TCI-LUH/Gateway-Module-v3/3d-case/backplate.step

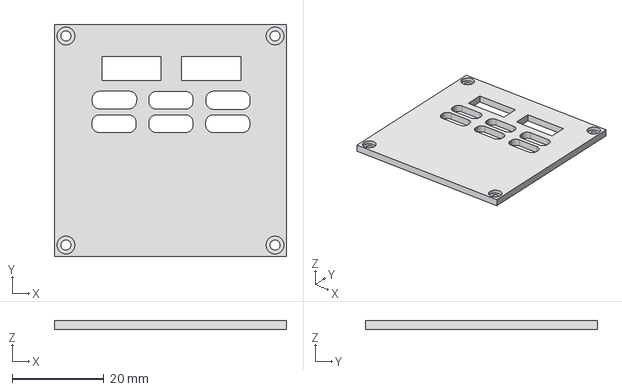
[picture p1: CAD file, 2025-05-20]
3d-case/backplate.step
50.6 x 50.6 x 2.00 mm
