TCI-LUH/Gateway-Module-v3/3d/fan_25x25x6.step

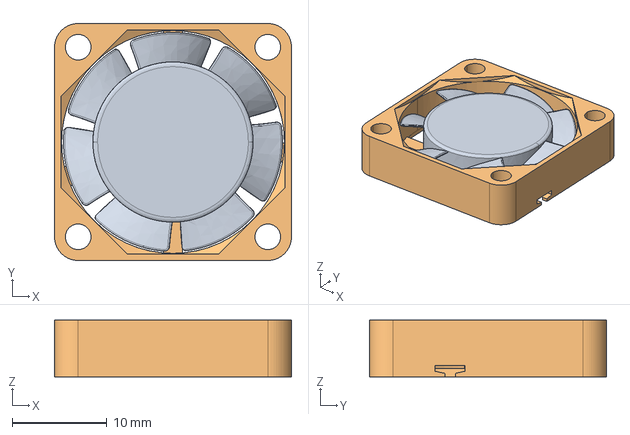
[picture p2: CAD file, 2025-05-20]
3d/fan_25x25x6.step
25.0 x 25.0 x 6.00 mm
