TCI-LUH/Gateway-Module-v3/pcbs/testing/tty2eth-slim/tty2eth-slim.step

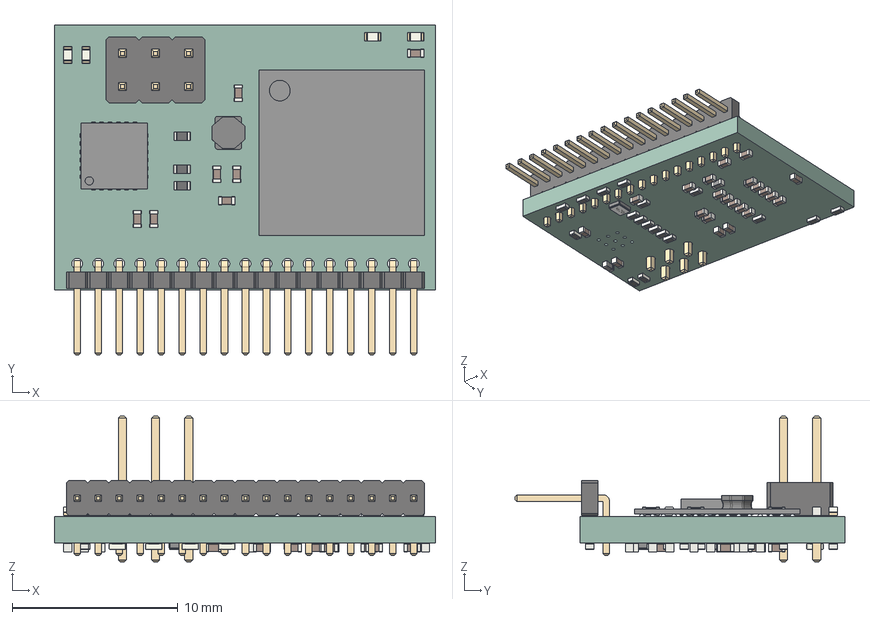
[picture p3: CAD file, 2025-05-20]
pcbs/testing/tty2eth-slim/tty2eth-slim.step
23.0 x 19.9 x 8.80 mm
C_0402_1005Metric x 29
R_0402_1005Metric x 21
LED_0402_1005Metric x 4
L_DND2020MK004
ASSEMBLY x 2
PinHeader_2x03_P200mm_Vertical
PinHeader_1x17_P127mm_Horizontal
ASCO
L_0402_1005Metric x 2
tty2eth-slim_PCB
