TCI-LUH/Gateway-Module-v3/3d-case/case-base.step

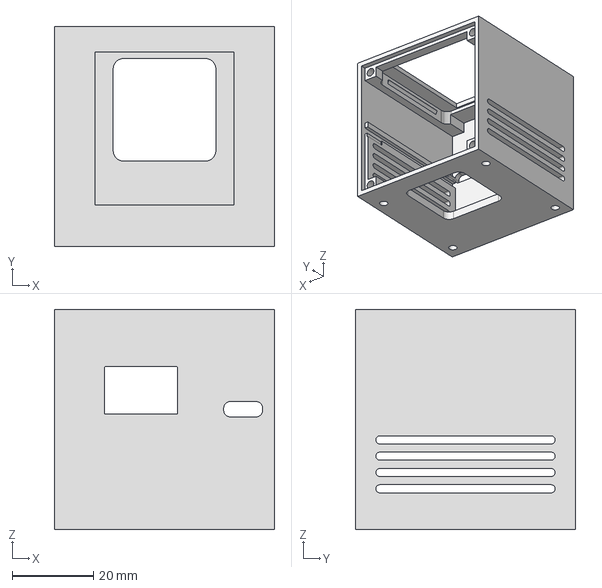
[picture p4: CAD file, 2025-05-20]
3d-case/case-base.step
54.0 x 54.0 x 54.0 mm
