TCI-LUH/Gateway-Module-v3/3d/XK049b-Heatspreader.step

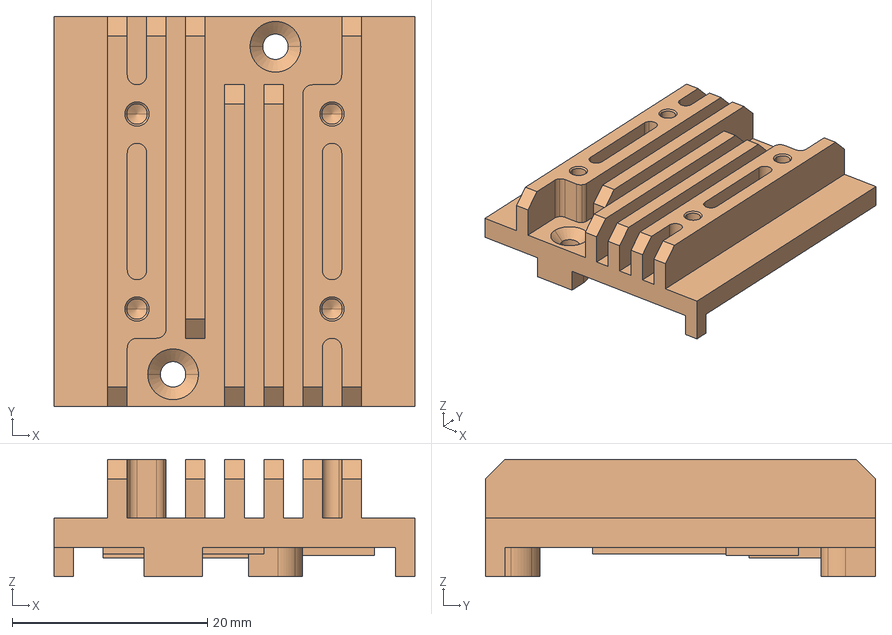
[picture p5: CAD file, 2025-05-20]
3d/XK049b-Heatspreader.step
37.0 x 40.0 x 12.0 mm
