TCI-LUH/Gateway-Module-v3/3d-case/foot.step

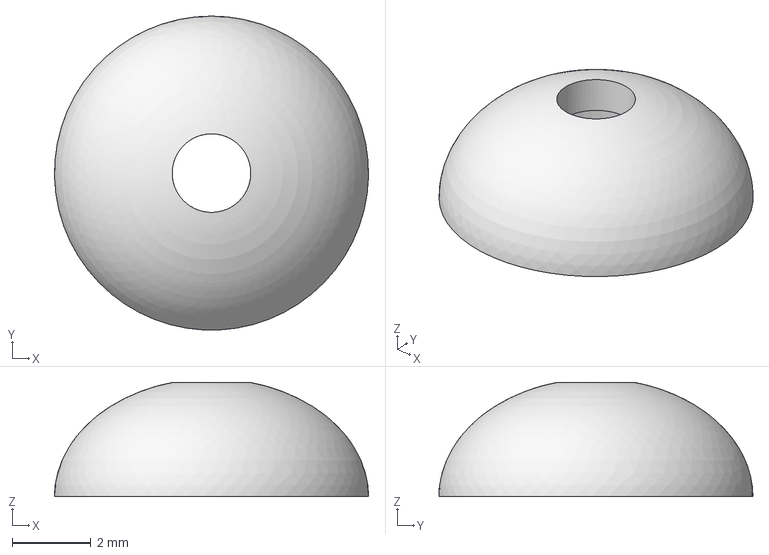
[picture p6: CAD file, 2025-05-20]
3d-case/foot.step
8.00 x 7.99 x 2.90 mm
