TCI-LUH/Gateway-Module-v3/3d-case/fan-grill.step

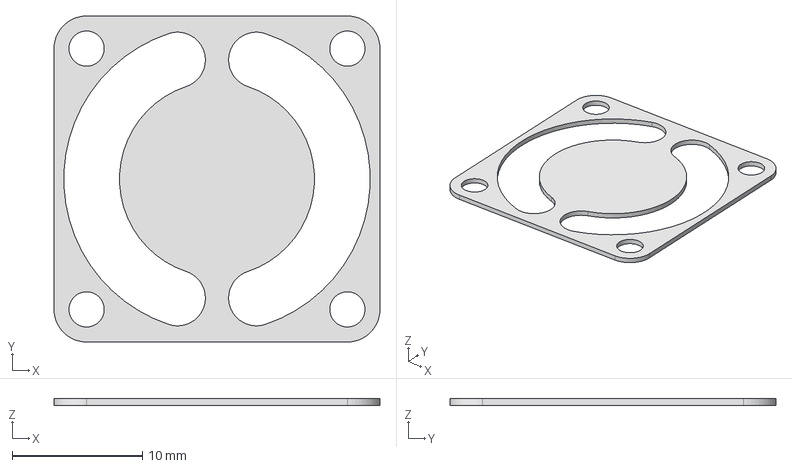
[picture p7: CAD file, 2025-05-20]
3d-case/fan-grill.step
25.0 x 25.0 x 0.5 mm
