TCI-LUH/Gateway-Module-v3/pcbs/schematics/gwm-main-board.pdf

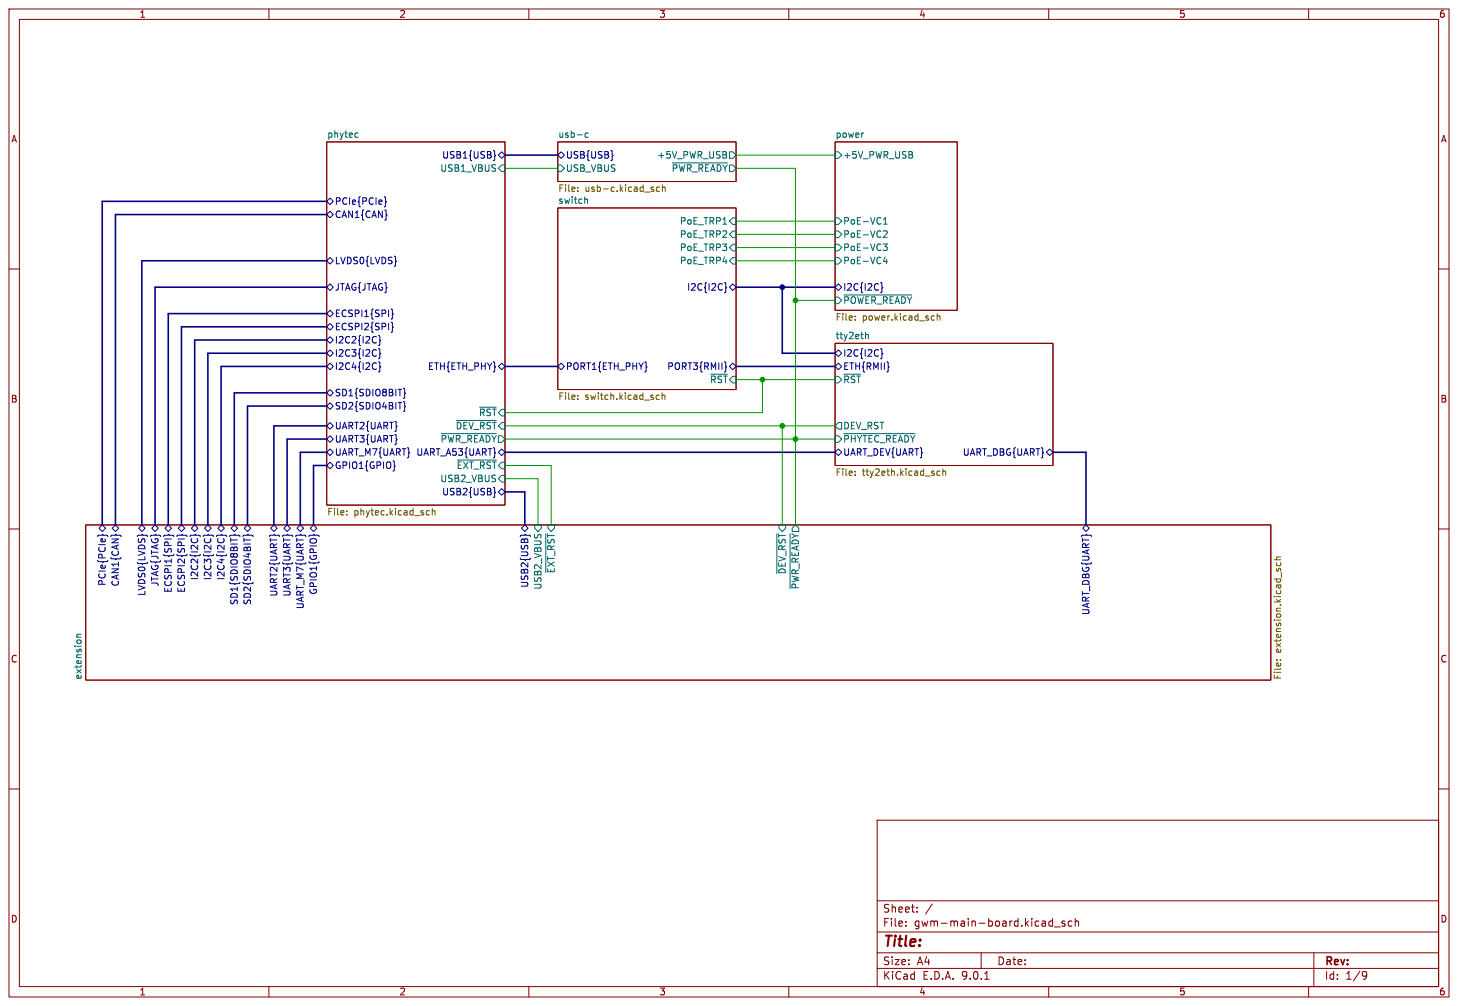
[picture p8: page 1]

Id: 1/9 Title: File: gwm-main-board.kicad_sch Sheet: /

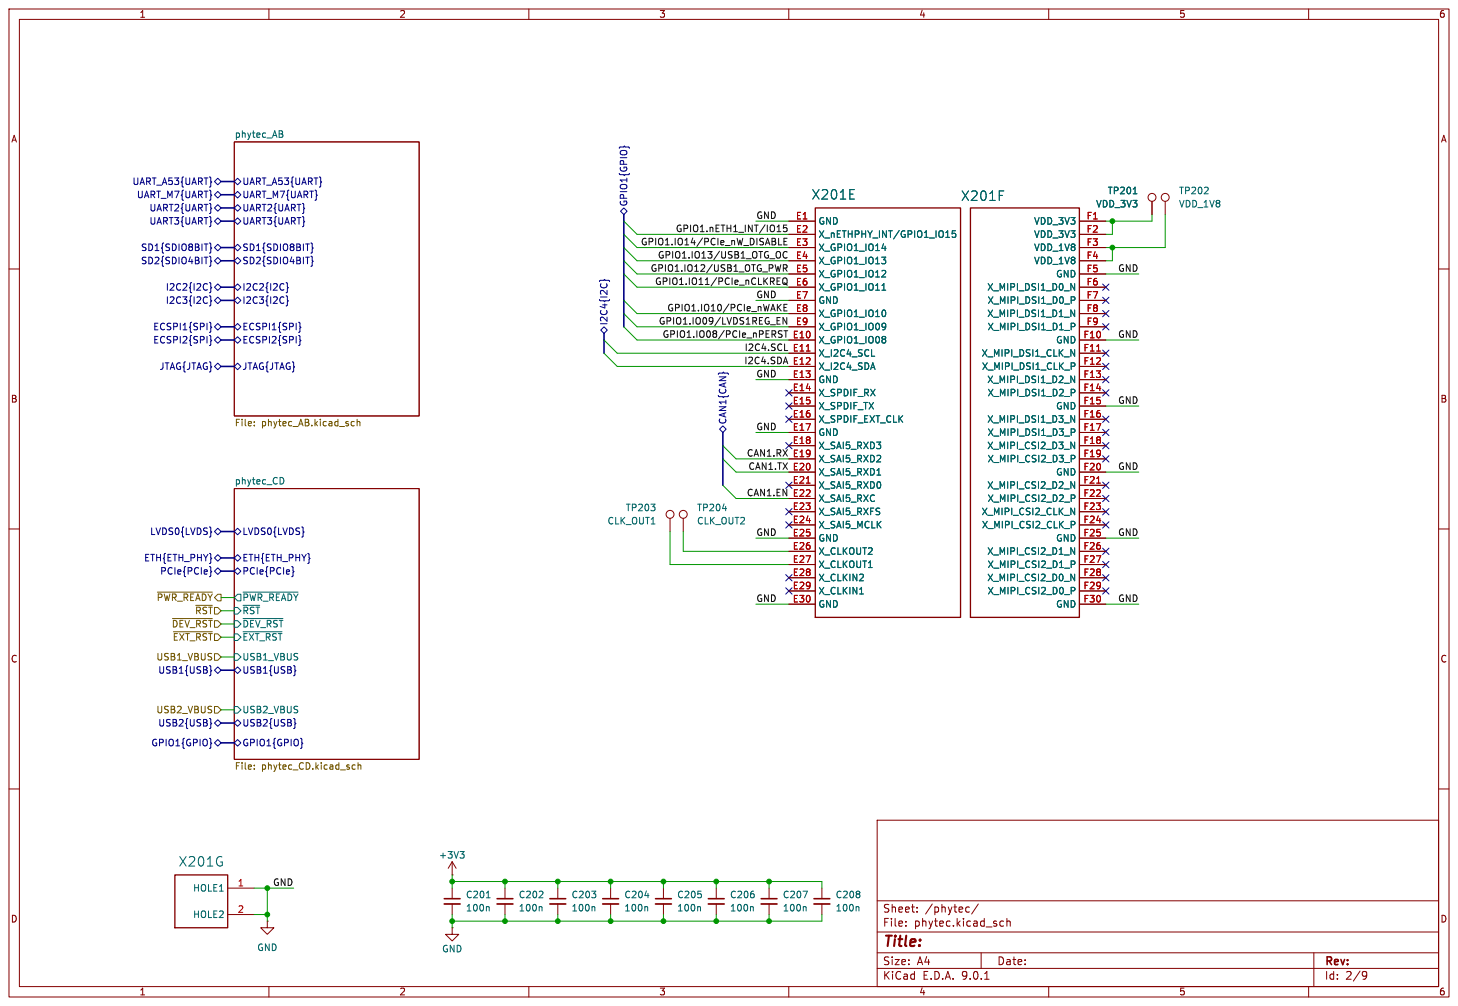
[picture p9: page 2]

Id: 2/9 Title: File: phytec.kicad_sch Sheet: /phytec/

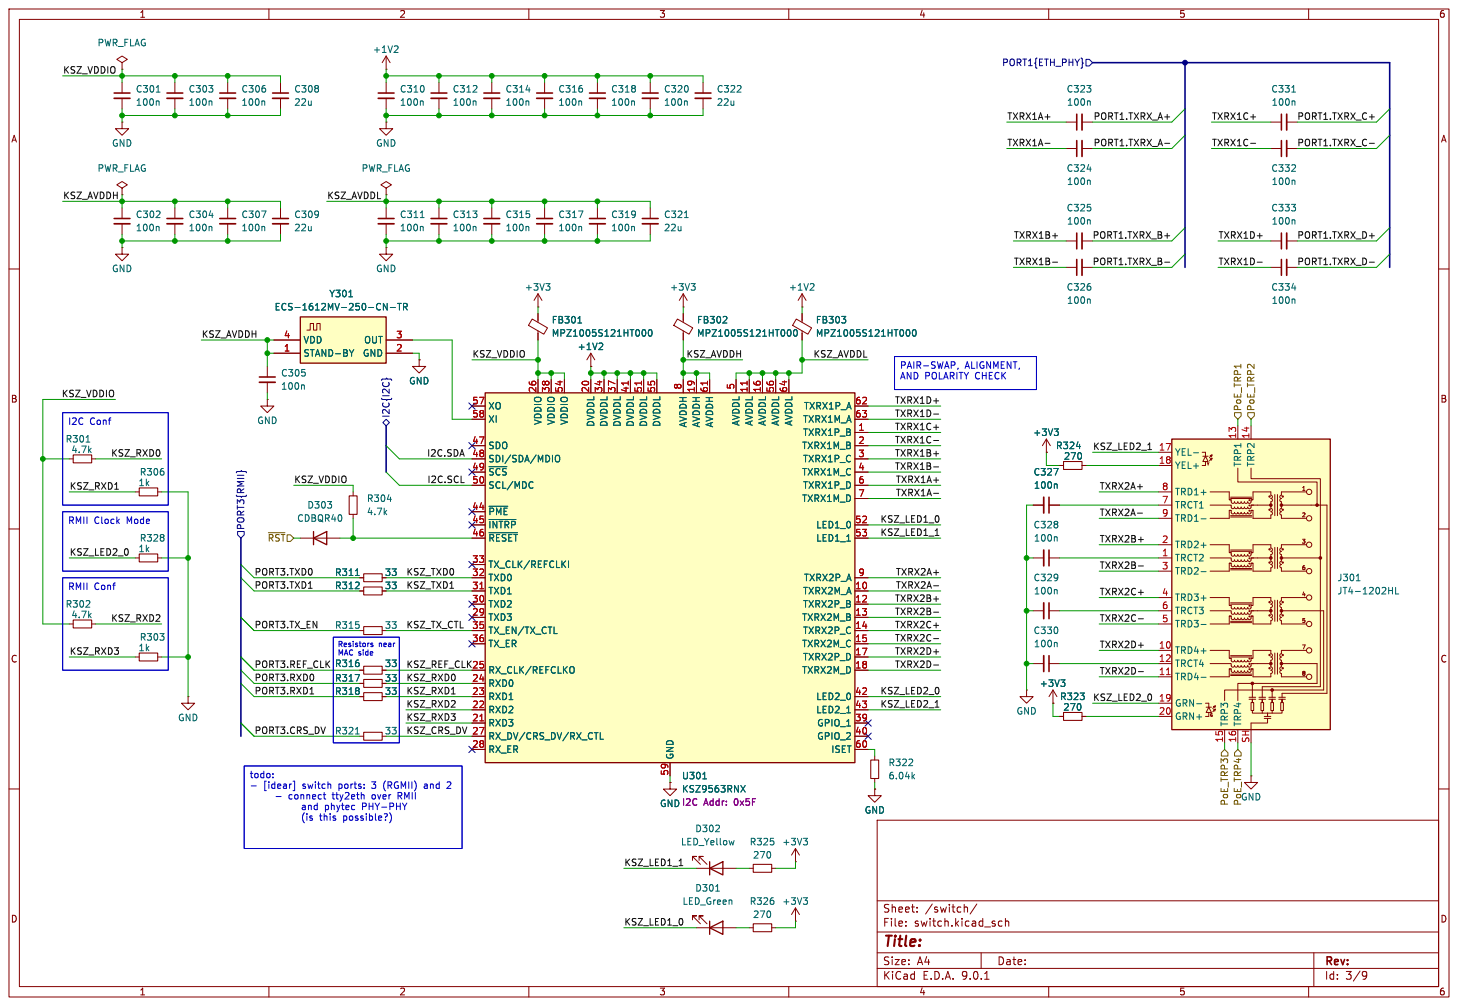
[picture p10: page 3]

PAIR-SWAP, ALIGNMENT, AND POLARITY CHECK

5 AVDDL 11 AVDDL 16 AVDDL 56 AVDDL 64 TXRX1P_A 62 TXRX1M_A 63 TXRX1P_B 1 TXRX1M_B 2 TXRX1P_C 3 TXRX1M_C 4 TXRX1P_D 6 TXRX1M_D 7

Id: 3/9 Title: File: switch.kicad_sch Sheet: /switch/

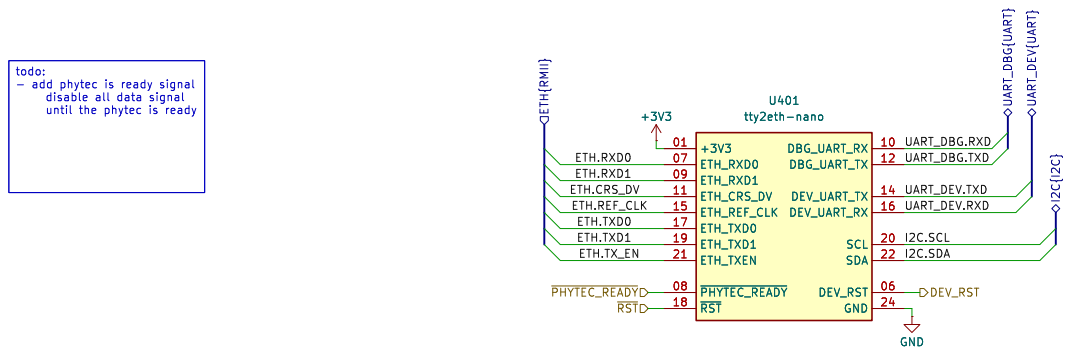
[picture p11: page 4]

Id: 4/9 Title: File: tty2eth.kicad_sch Sheet: /tty2eth/

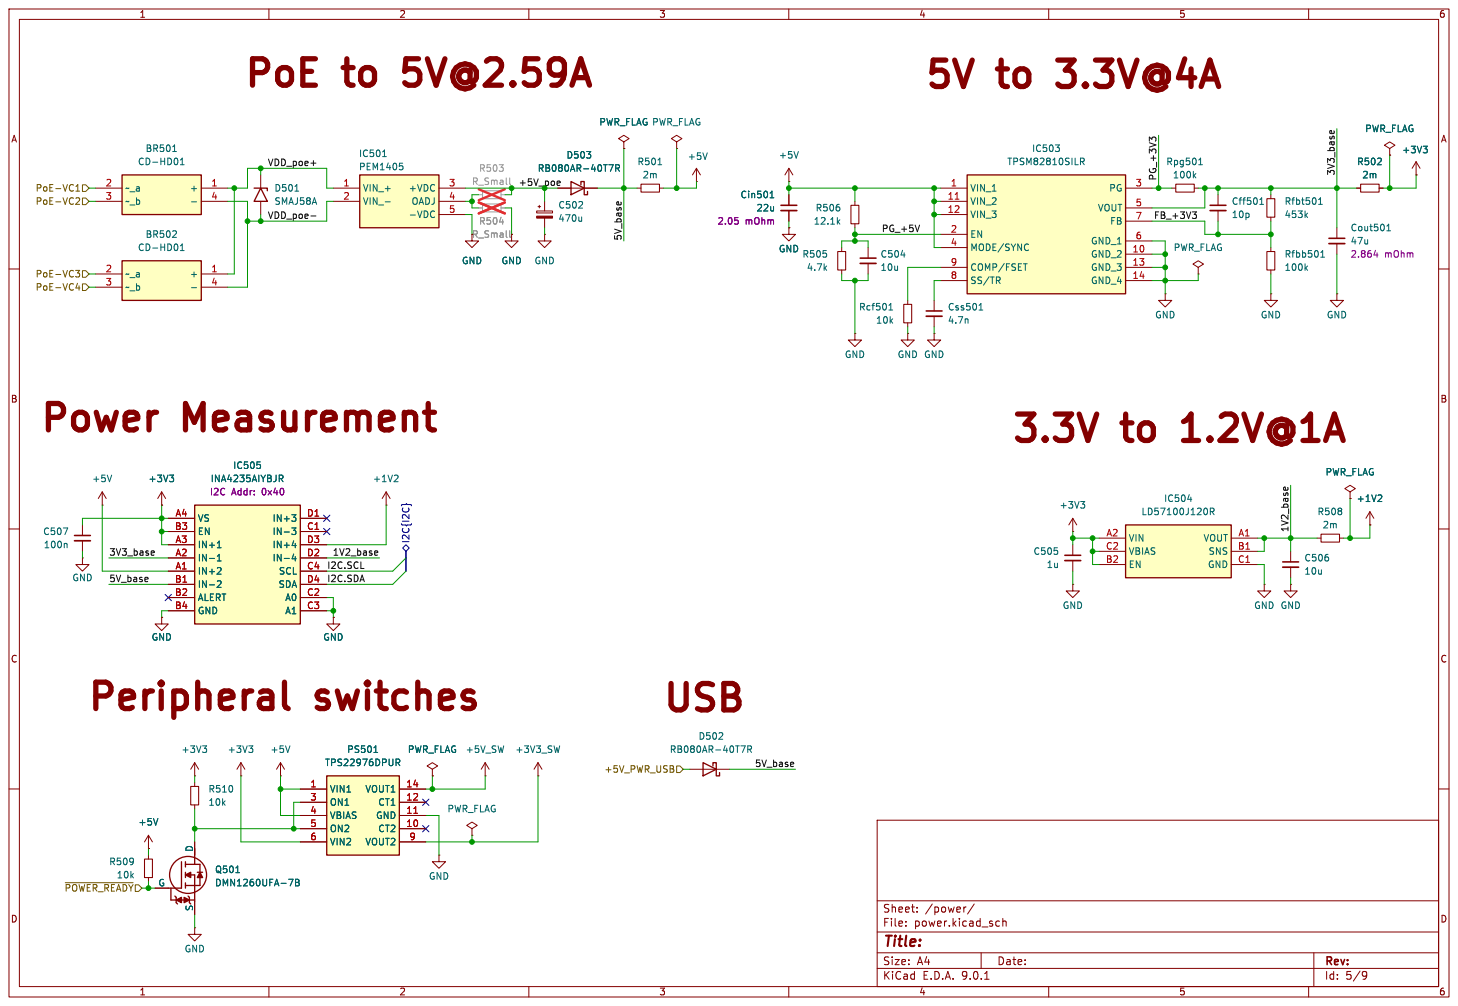
[picture p12: page 5]

Id: 5/9 Title: File: power.kicad_sch Sheet: /power/

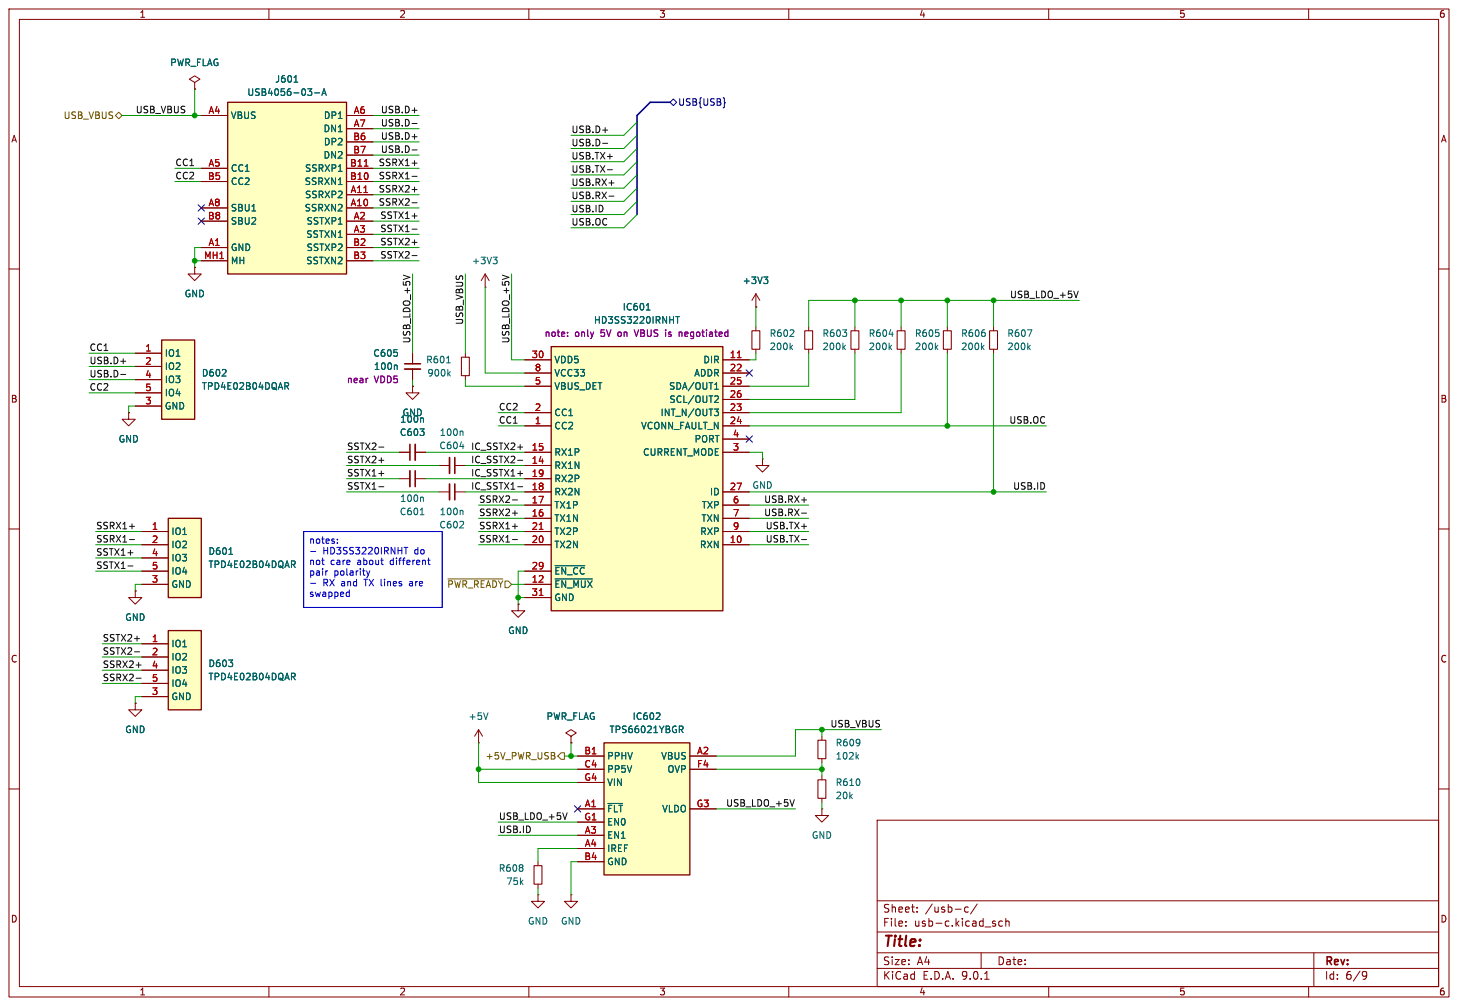
[picture p13: page 6]

PWR_FLAG
USB.TX- USB.RX+ USB.TX+ USB.D- USB.D+ CC1 USB.ID

USB.TX+ USB.TX- SSRX1+ SSTX2+

not care about different pair polarity - RX and TX lines are

Id: 6/9 Title: File: usb-c.kicad_sch Sheet: /usb-c/

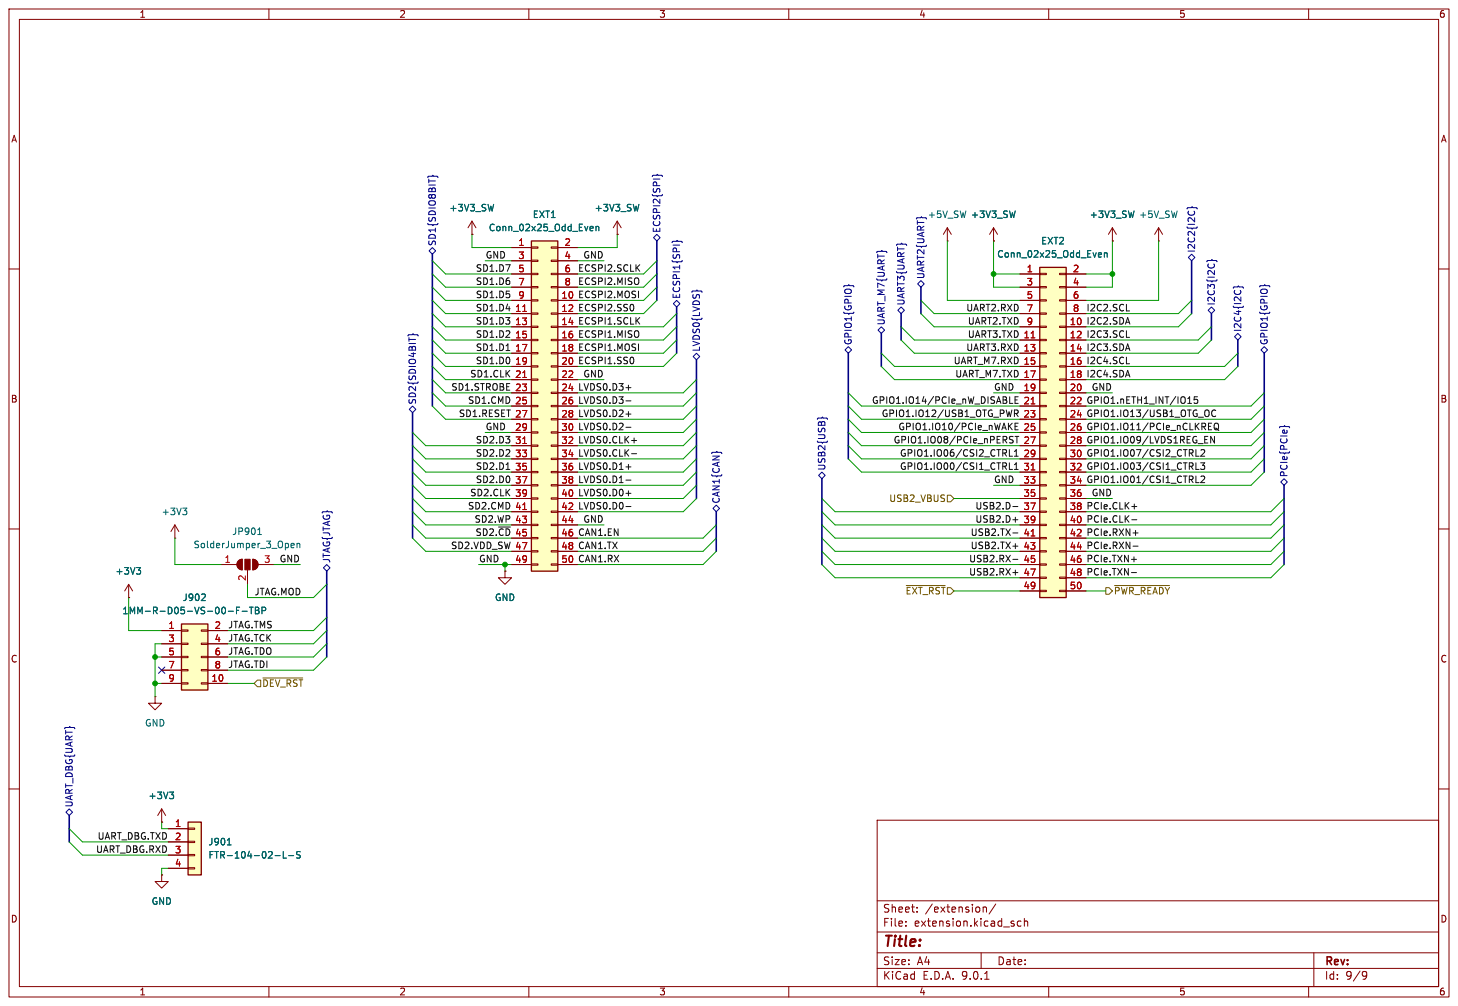
[picture p14: page 7]

Id: 9/9 Title: File: extension.kicad_sch Sheet: /extension/ 13579

PCIe.CLK- PCIe.TXN- SD2.WP

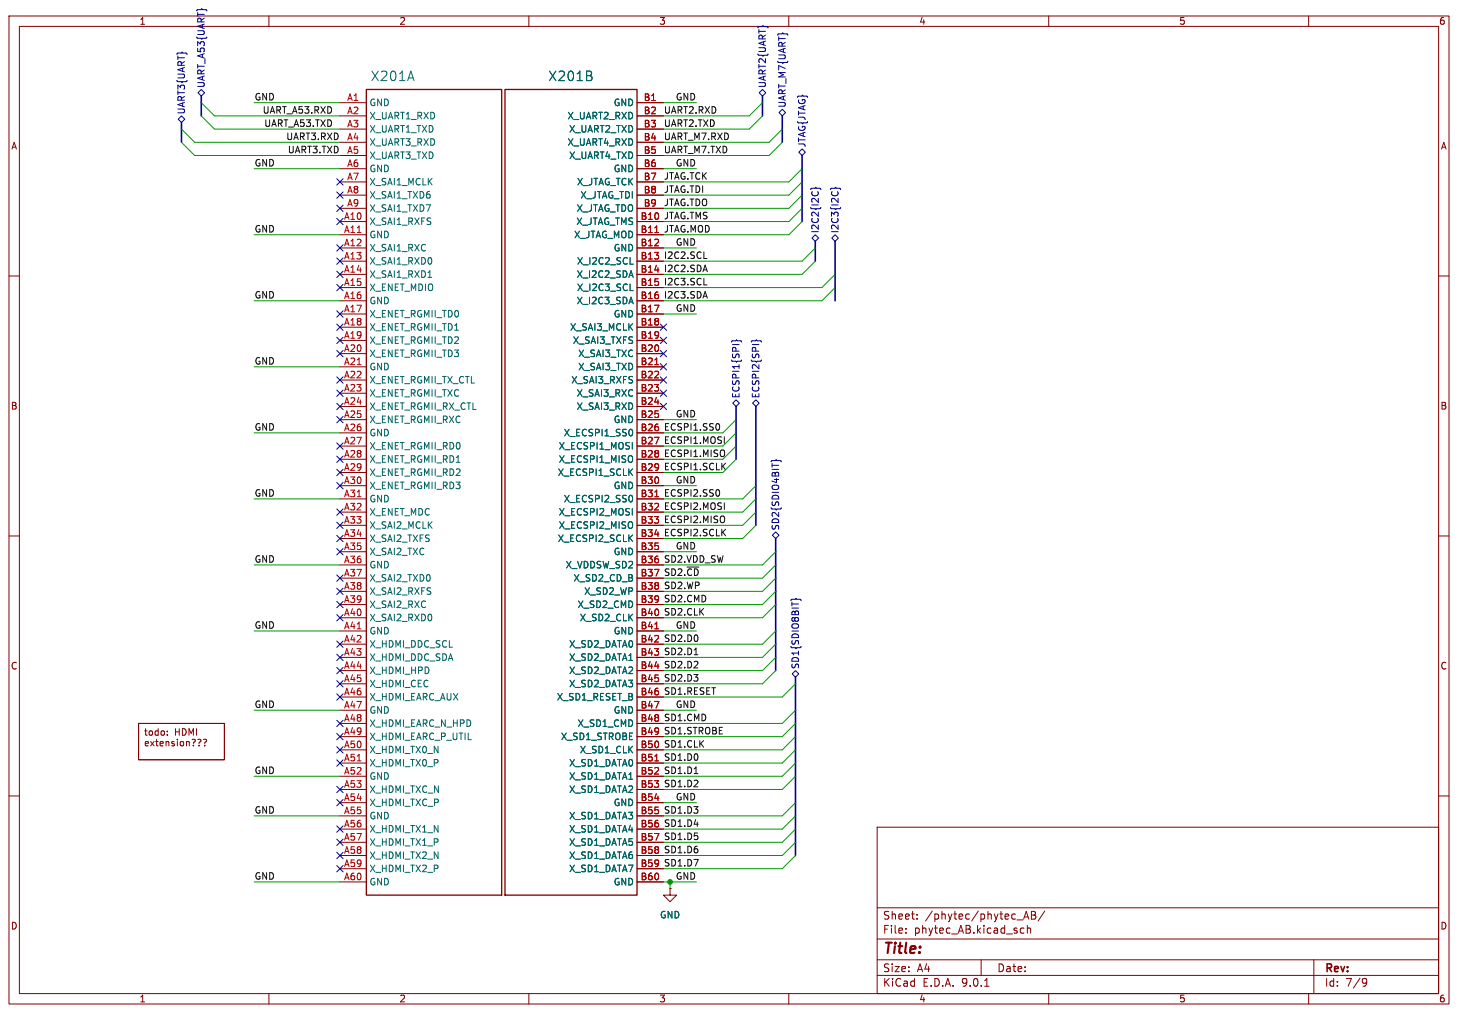
[picture p15: page 8]

UART3.RXD GND GND
UART3.TXD GND GND GND

GND B1 X_UART2_RXD B2 X_UART2_TXD B3 X_UART4_RXD B4 X_UART4_TXD B5 GND B6 X_JTAG_TCK B7 X_JTAG_TDI B8 X_JTAG_TDO B9 X_JTAG_TMS B10 X_JTAG_MOD B11 GND B12 X_I2C2_SCL B13 X_I2C2_SDA B14 X_I2C3_SCL B15 X_I2C3_SDA B16 GND B17 X_SAI3_MCLK B18 X_SAI3_TXFS B19 X_SAI3_TXC B20 X_SAI3_TXD B21 X_SAI3_RXFS B22 X_SAI3_RXC B23 X_SAI3_RXD B24 GND B25 X_ECSPI1_SS0 B26 X_ECSPI1_MOSI B27 X_ECSPI1_MISO B28 X_ECSPI1_SCLK B29 GND B30 X_ECSPI2_SS0 B31 X_ECSPI2_MOSI B32 X_ECSPI2_MISO B33 X_ECSPI2_SCLK B34 GND B35 X_VDDSW_SD2 B36 X_SD2_CD_B B37 X_SD2_WP B38 X_SD2_CMD B39 X_SD2_CLK B40 GND B41 X_SD2_DATA0 B42 X_SD2_DATA1 B43 X_SD2_DATA2 B44 X_SD2_DATA3 B45 X_SD1_RESET_B B46 GND B47 X_SD1_CMD B48 X_SD1_STROBE B49 X_SD1_CLK B50 X_SD1_DATA0 B51 X_SD1_DATA1 B52 X_SD1_DATA2 B53 GND B54 X_SD1_DATA3 B55 X_SD1_DATA4 B56 X_SD1_DATA5 B57 X_SD1_DATA6 B58 X_SD1_DATA7 B59 GND B60

JTAG.TCK GND GND

JTAG.TDI ECSPI2.SCLK GND

JTAG.MOD GND GND

Id: 7/9 Title: File: phytec_AB.kicad_sch Sheet: /phytec/phytec_AB/

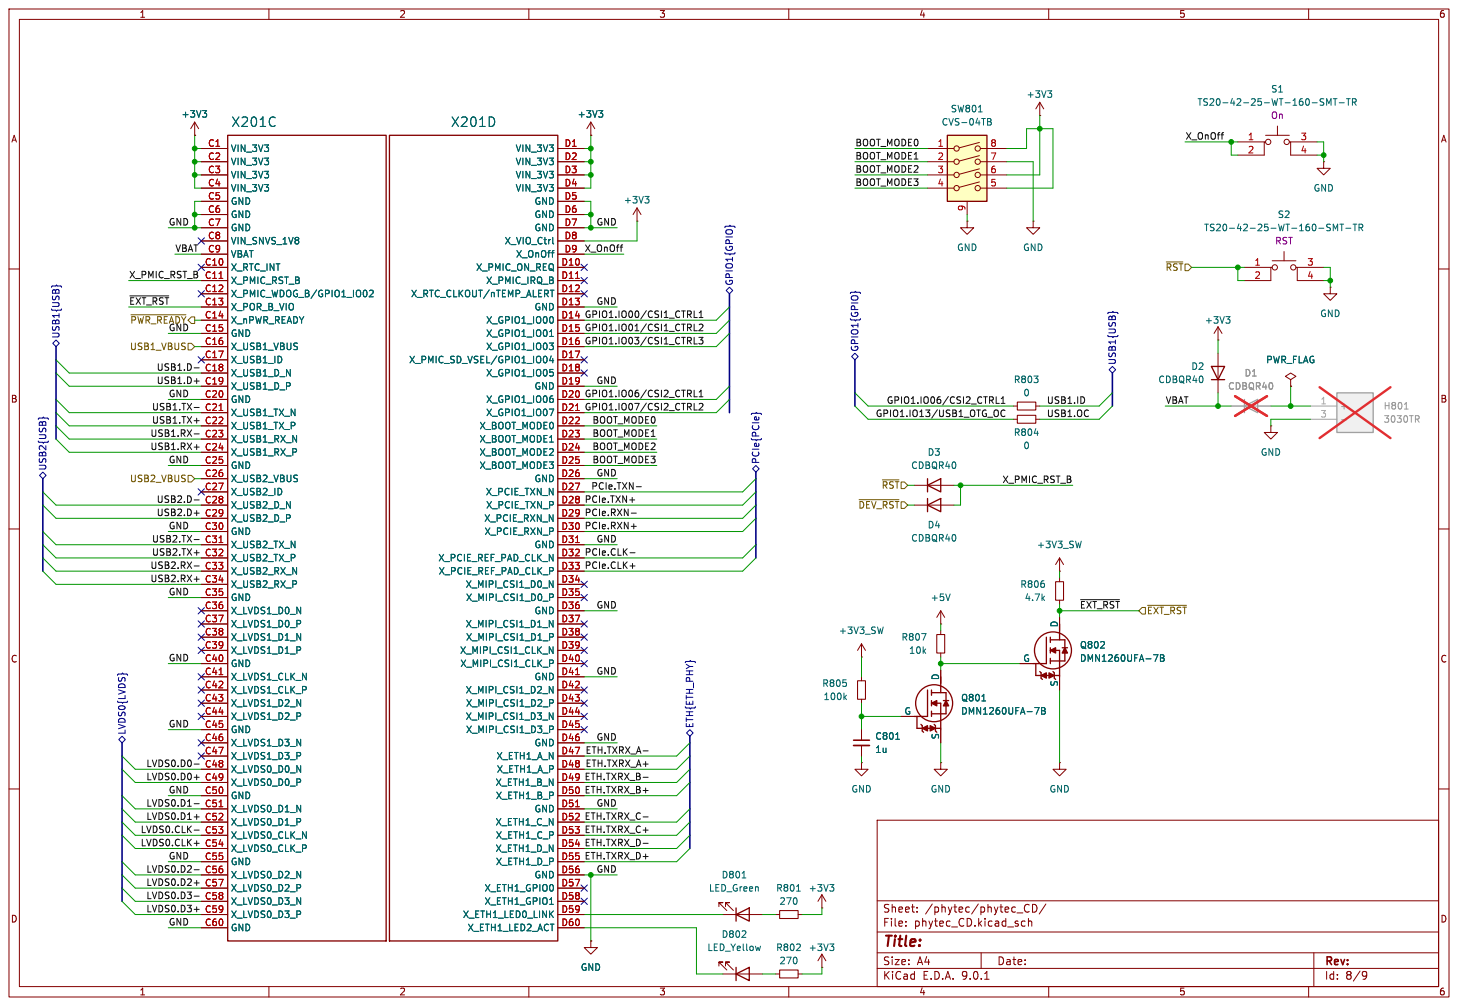
[picture p16: page 9]

4 S1 TS20-42-25-WT-160-SMT-TR On +5V PCIe{PCIe}
GPIO1.IO01/CSI1_CTRL2 GPIO1.IO00/CSI1_CTRL1 GPIO1.IO03/CSI1_CTRL3 GND GND

GND GND
VBAT GND
USB2.TX- USB2.TX+ USB2.RX+ USB2.RX- X_PMIC_RST_B GND GND

Id: 8/9 Title: File: phytec_CD.kicad_sch Sheet: /phytec/phytec_CD/
