TCI-LUH/Gateway-Module-v3/pcbs/schematics/serial-extension.pdf

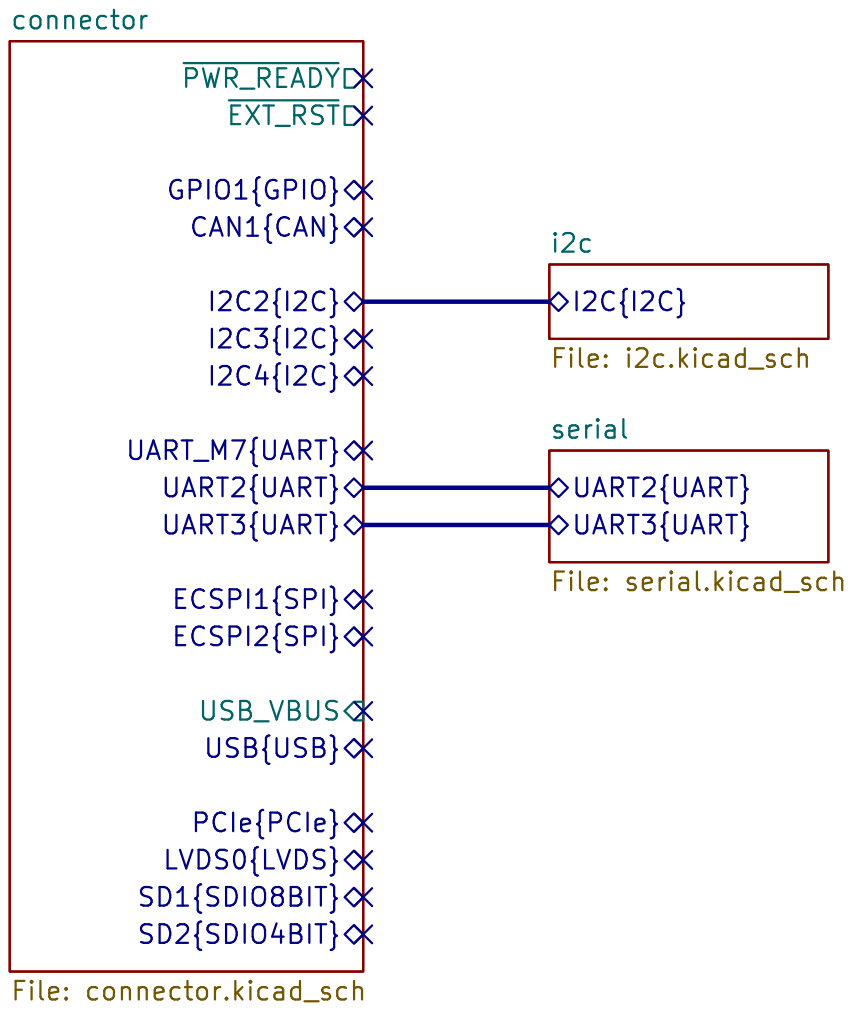
[picture p17: page 1]

UART3{UART} serial File: serial.kicad_sch

PCIe{PCIe}
LVDS0{LVDS}
SD1{SDIO8BIT}
Id: 1/4 Title: File: serial-extension.kicad_sch Sheet: / SD2{SDIO4BIT}

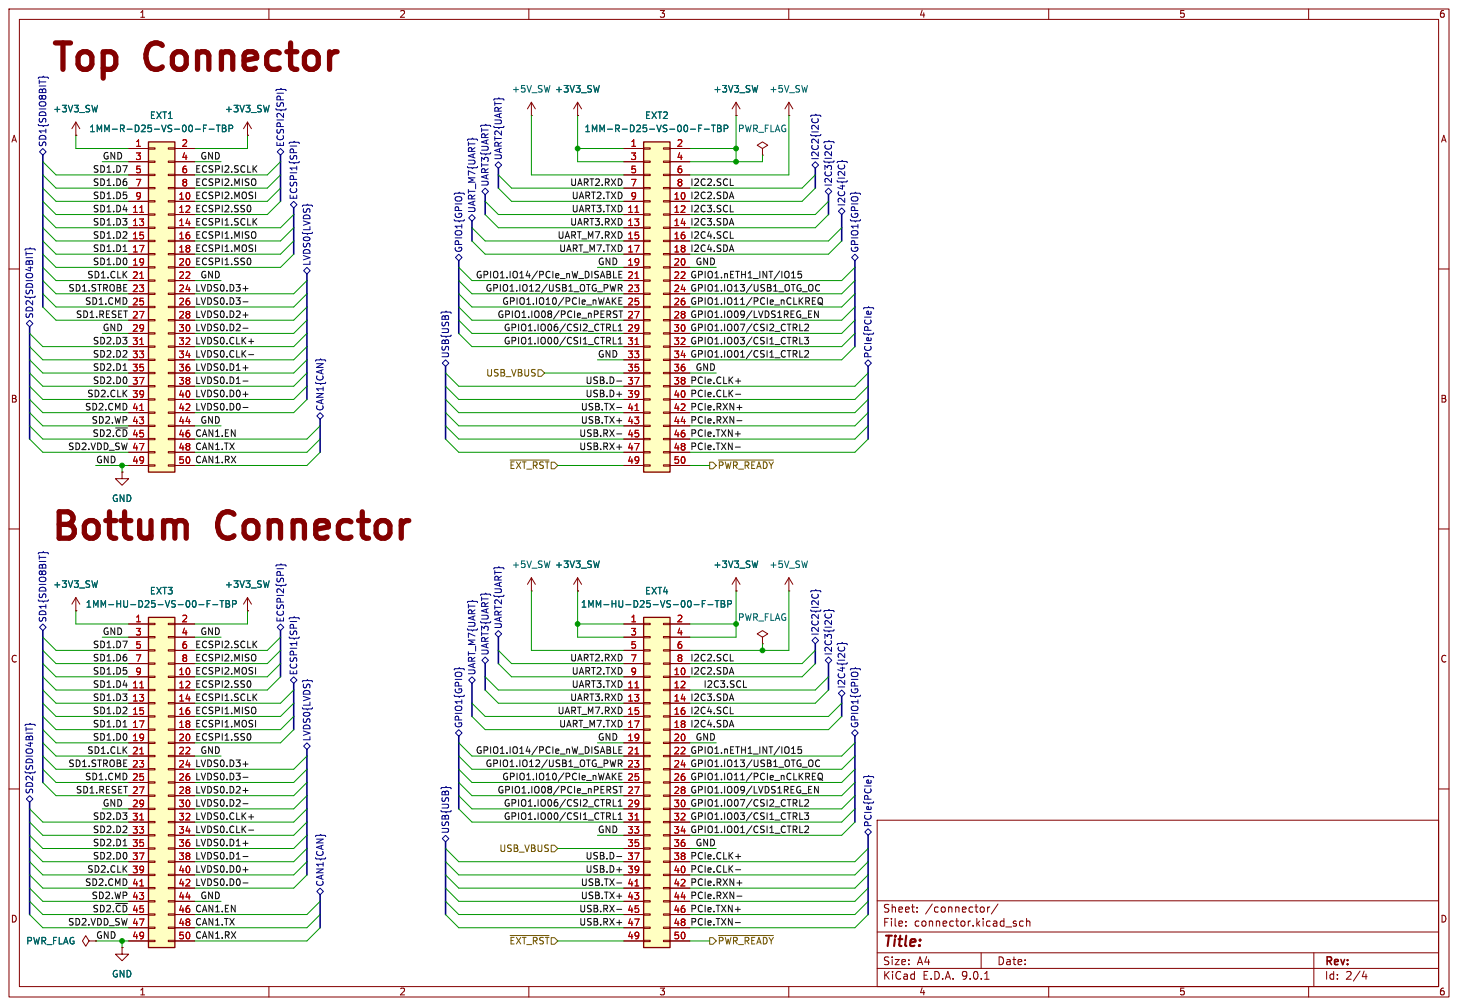
[picture p18: page 2]

Id: 2/4 Title: File: connector.kicad_sch Sheet: /connector/

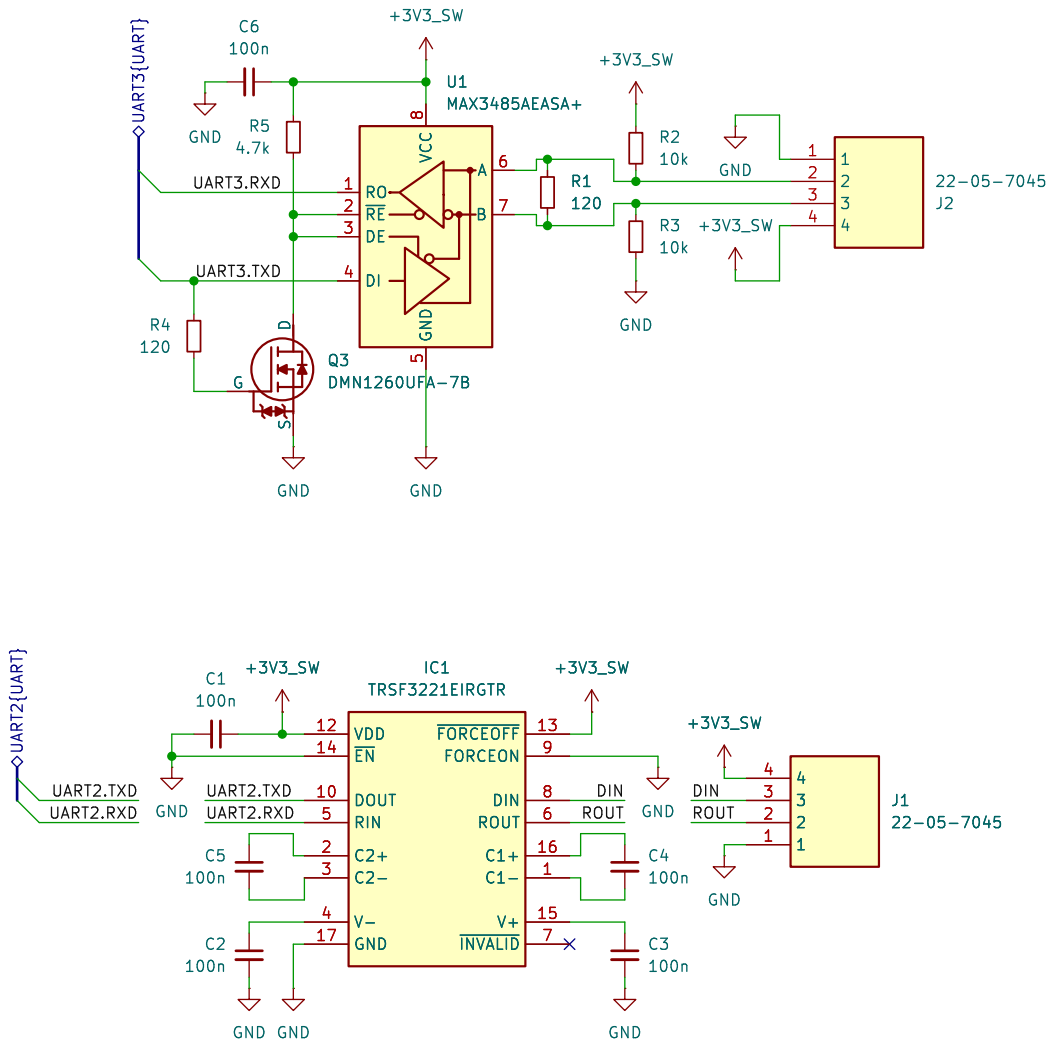
[picture p19: page 3]

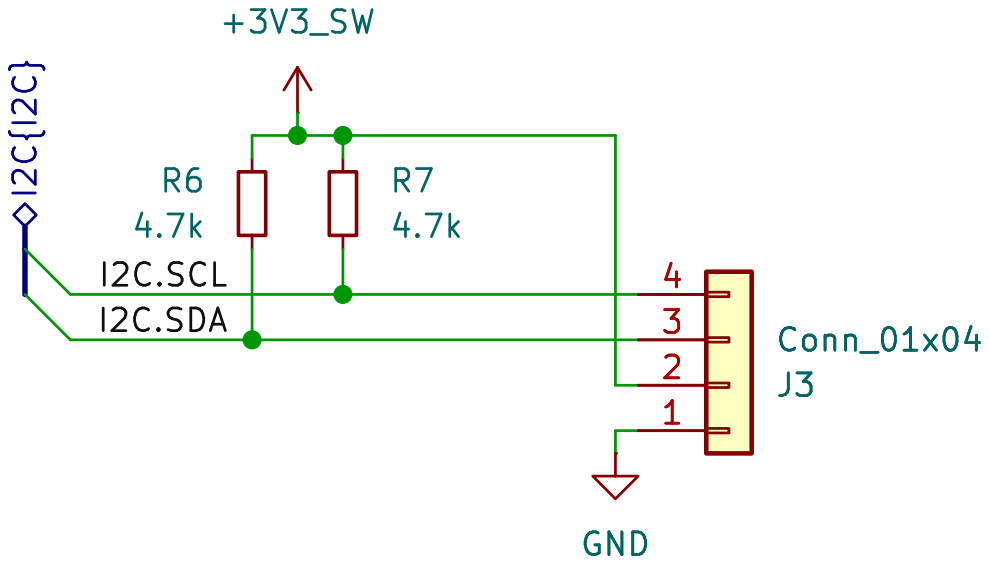
[picture p20: page 4]

Id: 4/4 Title: File: i2c.kicad_sch Sheet: /i2c/
