TCI-LUH/Gateway-Module-v3/pcbs/schematics/tty2eth-nano.pdf

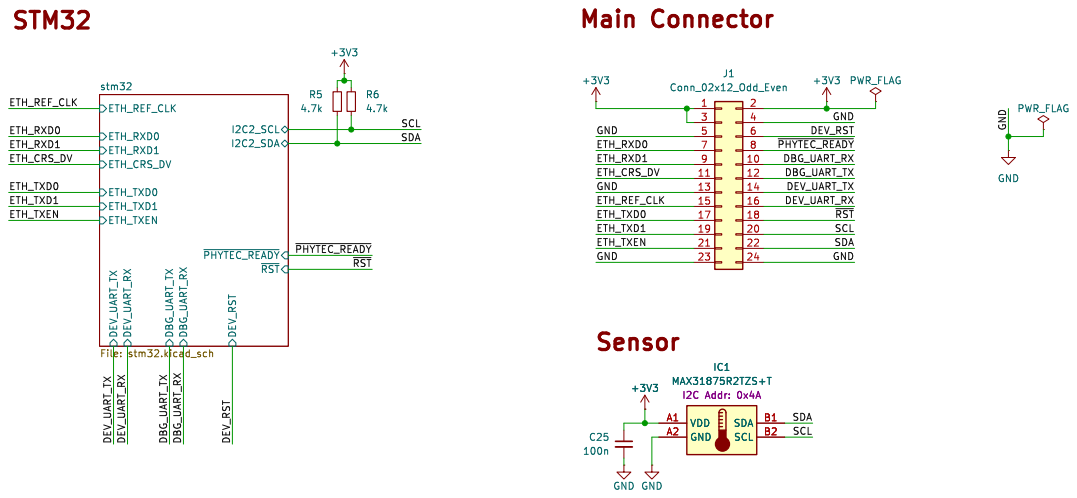
[picture p21: page 1]

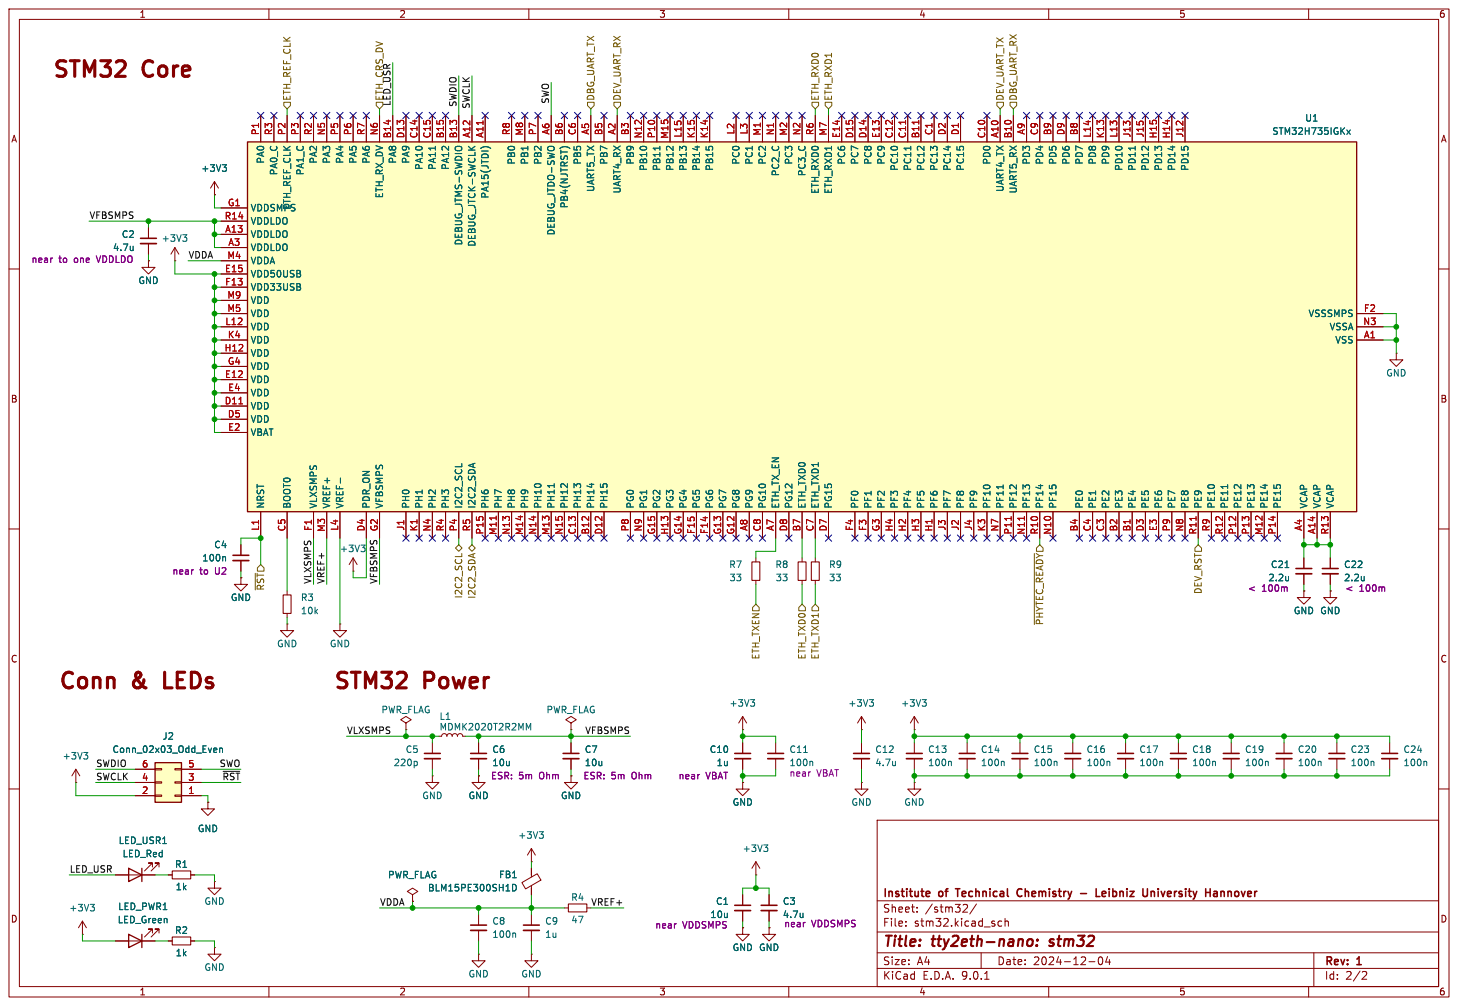
[picture p22: page 2]

near to one VDDLDO

near VDDSMPS GND GND
