TCI-LUH/Gateway-Module-v3/pcbs/schematics/usb-extension.pdf

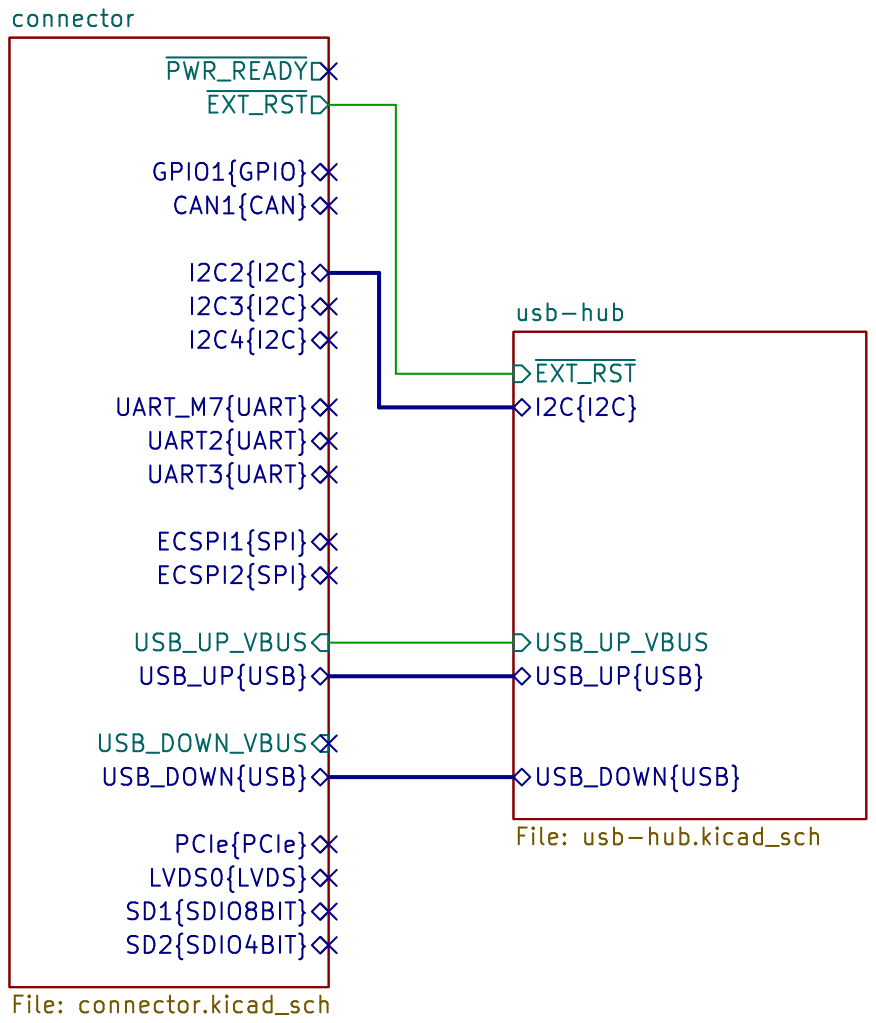
[picture p23: page 1]

Id: 1/4 Title: File: usb-extension.kicad_sch Sheet: / USB_UP_VBUS USB_UP{USB}

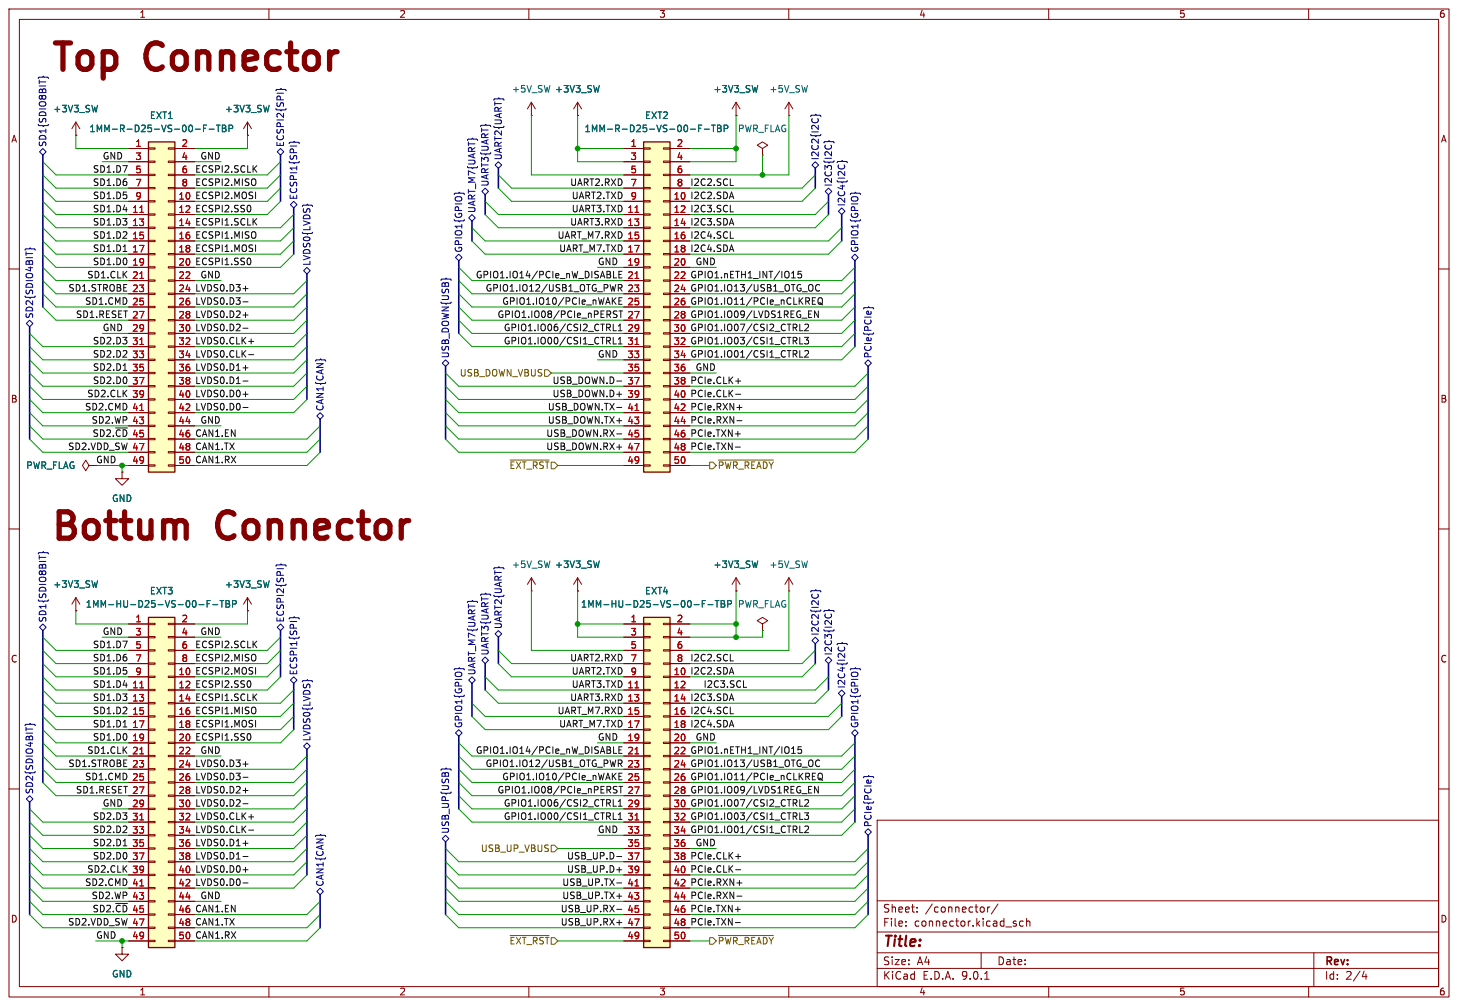
[picture p24: page 2]

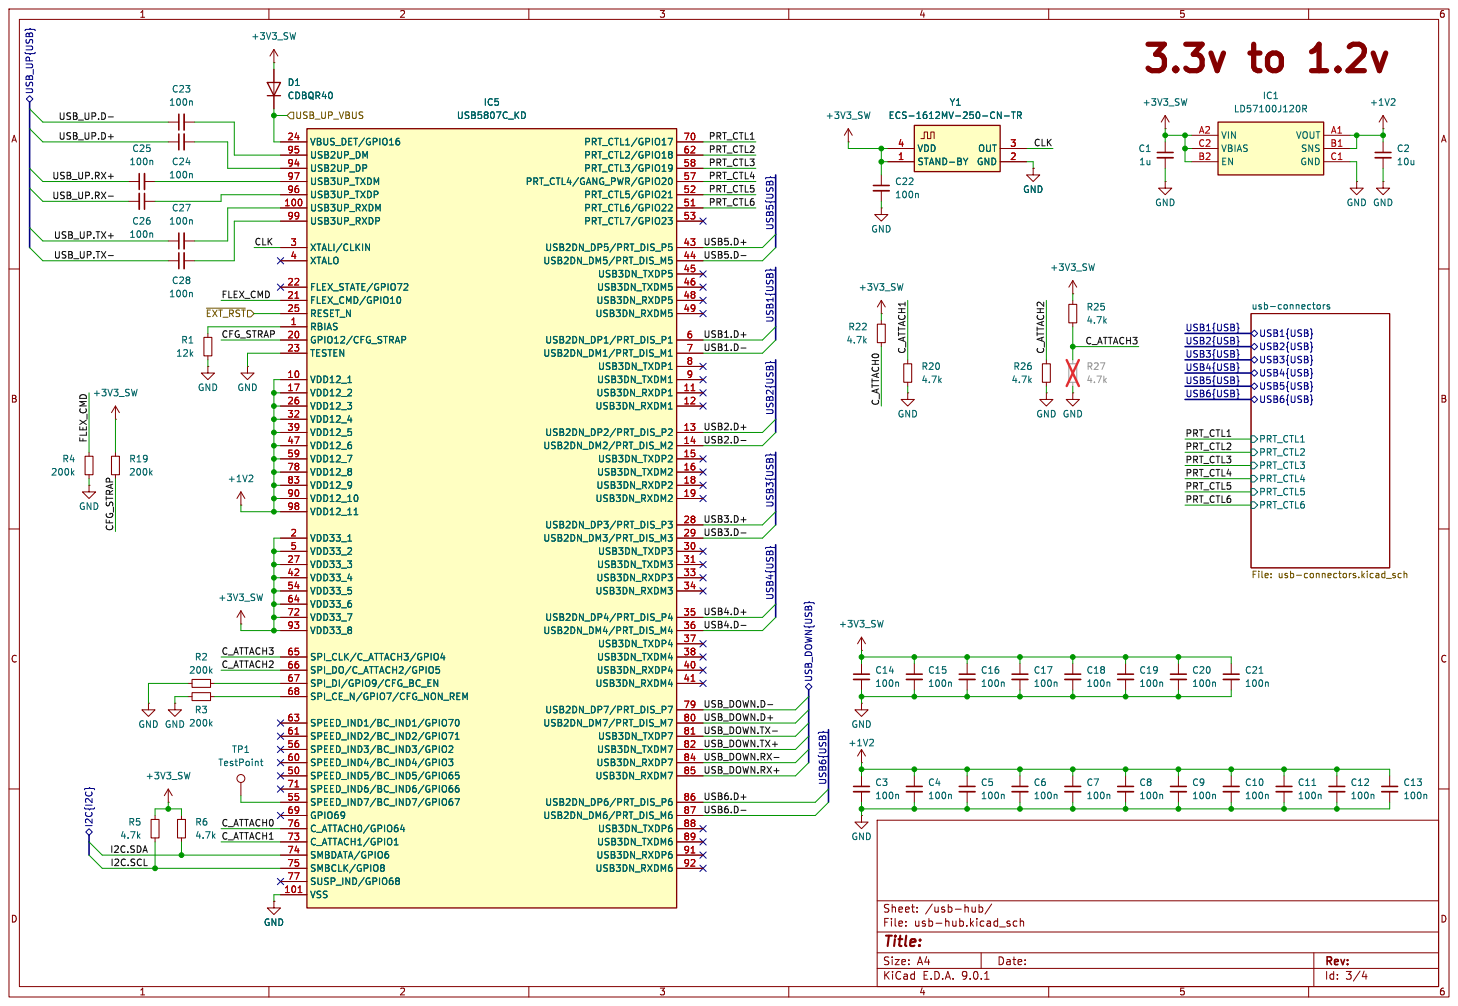
[picture p25: page 3]

Id: 3/4 Title: File: usb-hub.kicad_sch Sheet: /usb-hub/

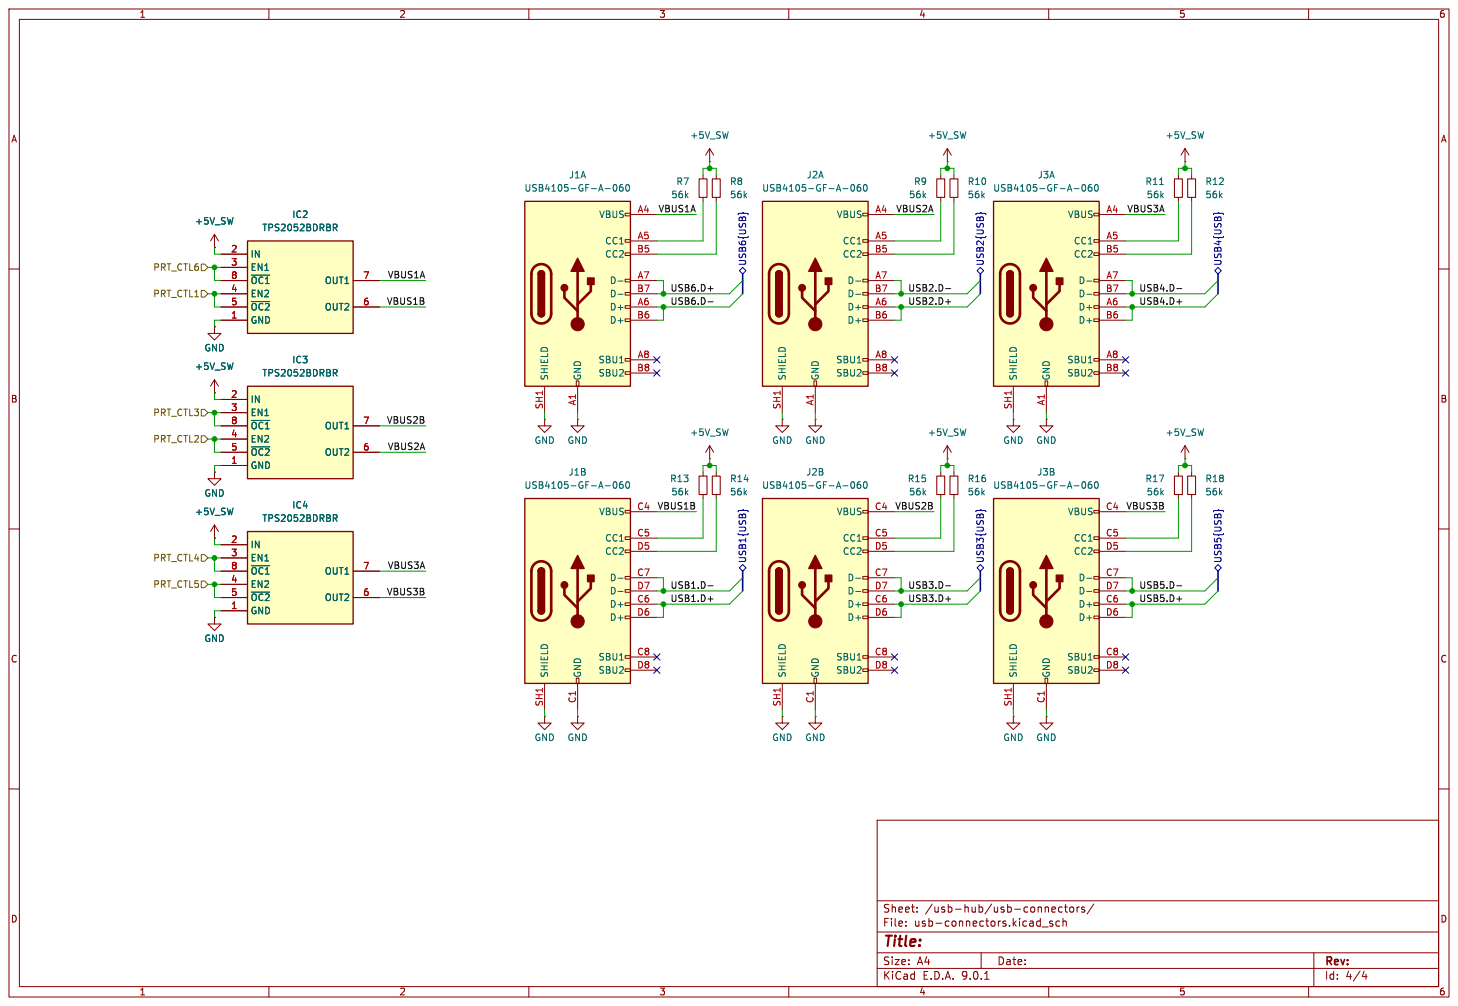
[picture p26: page 4]

Id: 4/4 Title: File: usb-connectors.kicad_sch Sheet: /usb-hub/usb-connectors/ R16
