TCI-LUH/Gateway-Module-v3/pcbs/testing/tty2eth-evb/tty2eth-evb-B_Cu.pdf

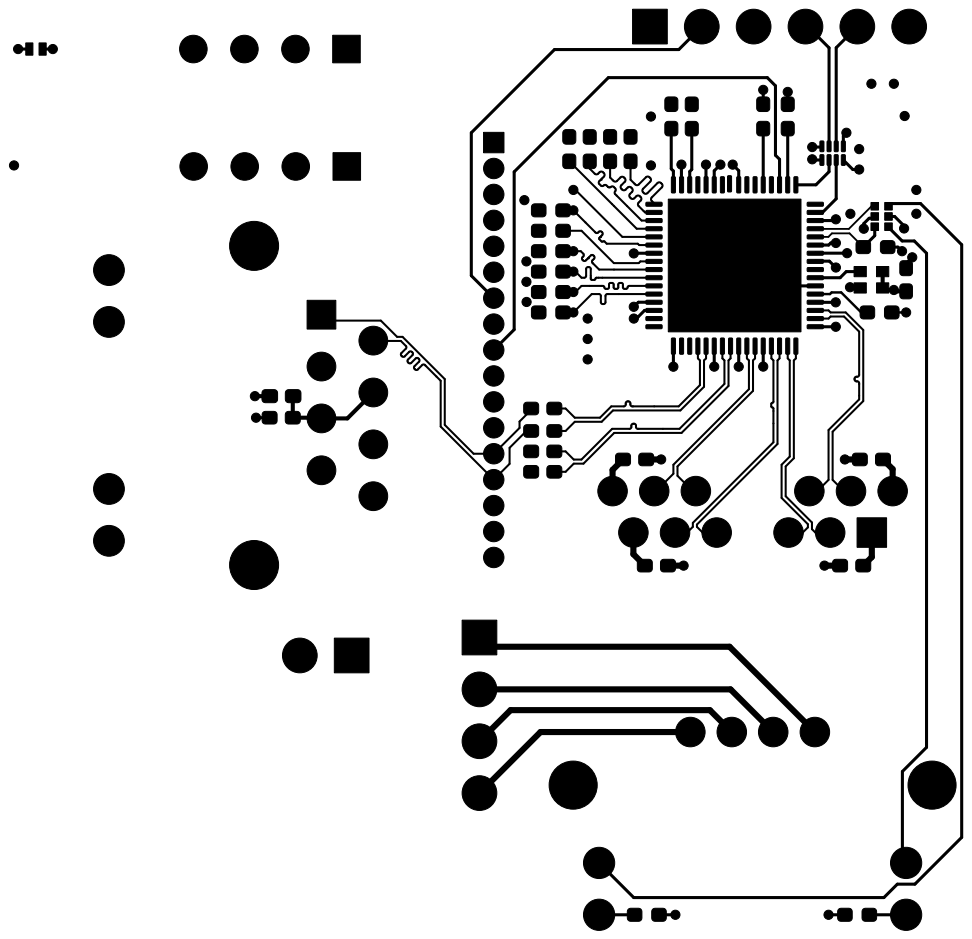
[picture p27: page 1]
