TCI-LUH/Gateway-Module-v3/pcbs/testing/tty2eth-evb/tty2eth-evb-B_Mask.pdf

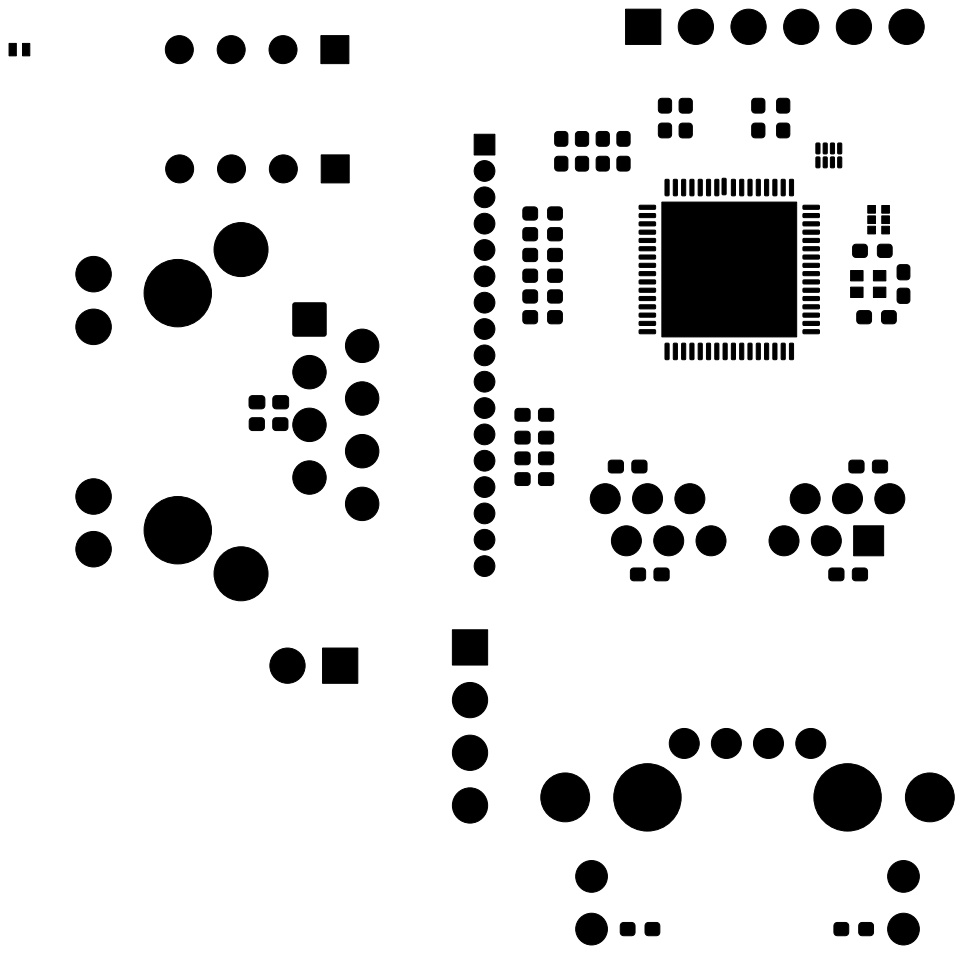
[picture p28: page 1]
