TCI-LUH/Gateway-Module-v3/pcbs/testing/tty2eth-evb/tty2eth-evb-B_Paste.pdf

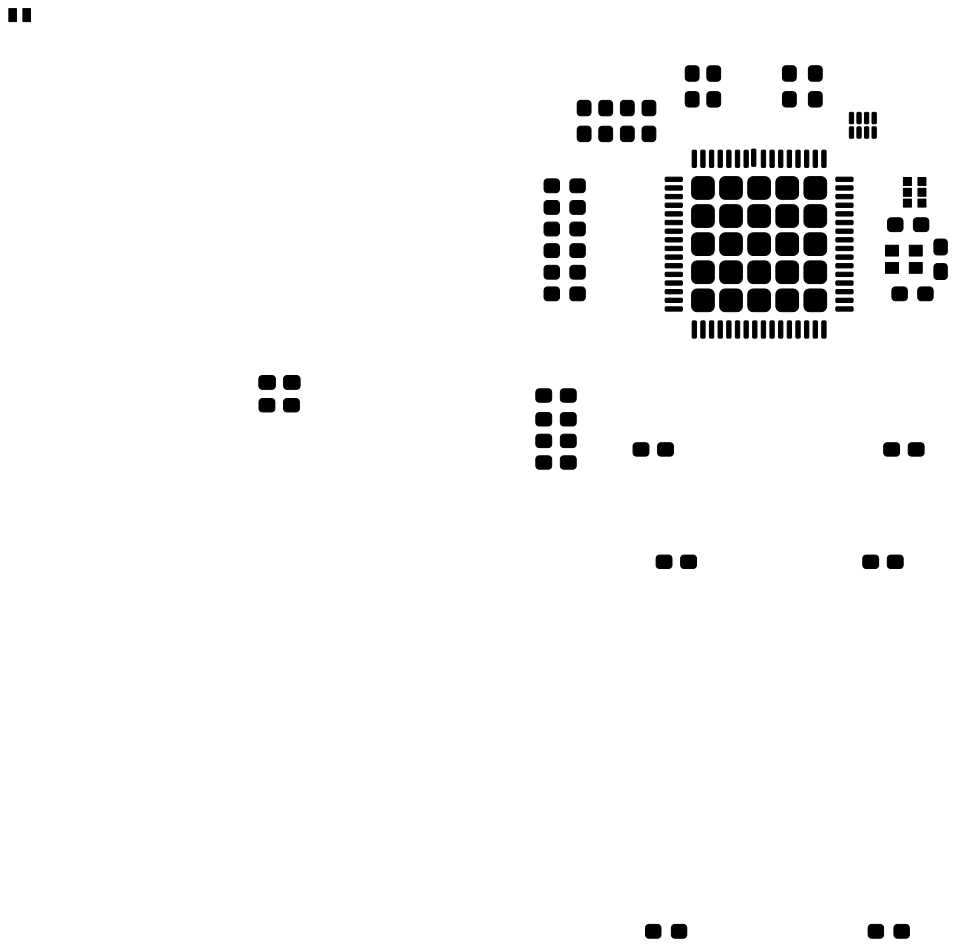
[picture p29: page 1]
