TCI-LUH/Gateway-Module-v3/pcbs/testing/tty2eth-evb/tty2eth-evb-B_Silkscreen.pdf

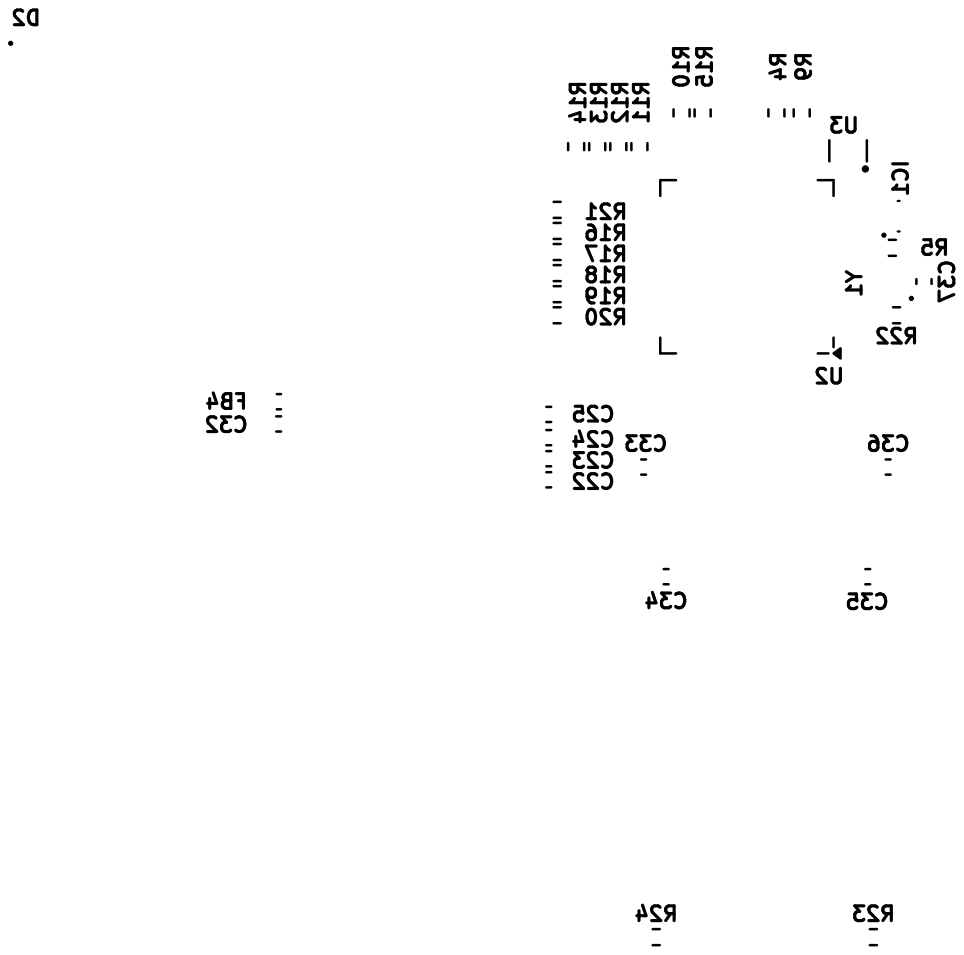
[picture p30: page 1]
