TCI-LUH/Gateway-Module-v3/pcbs/testing/tty2eth-evb/tty2eth-evb-F_Cu.pdf

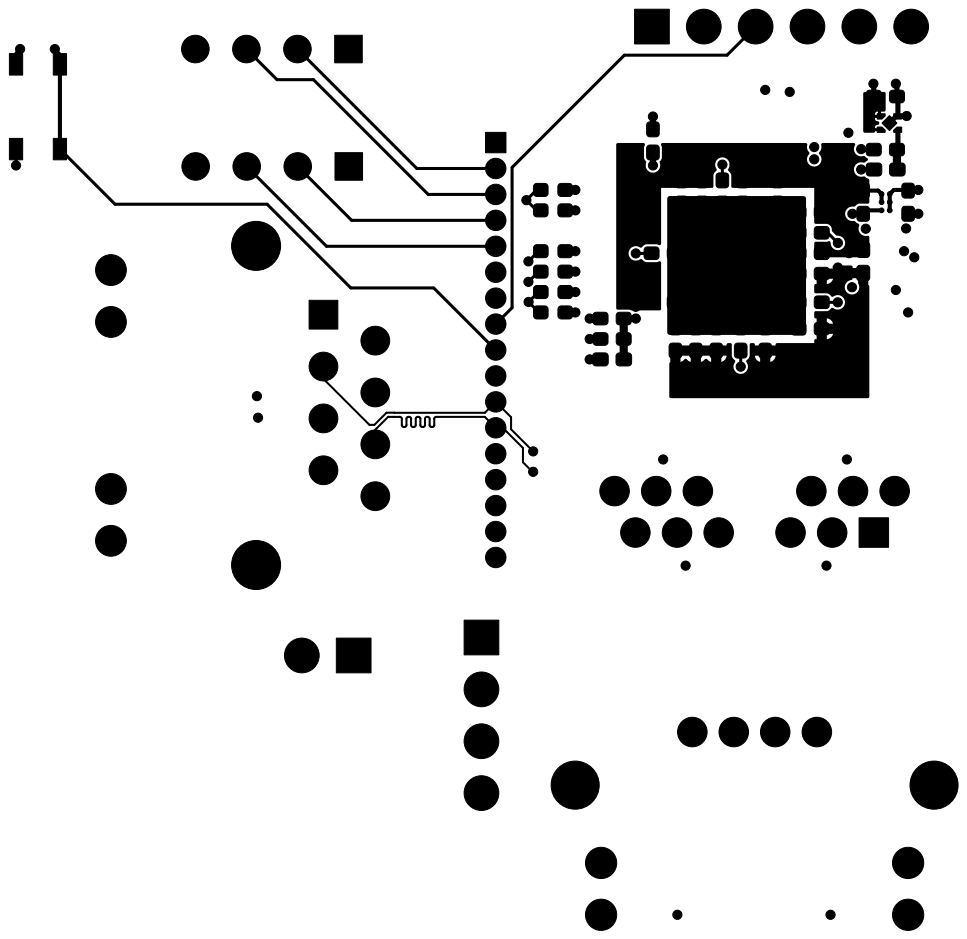
[picture p31: page 1]
