TCI-LUH/Gateway-Module-v3/pcbs/testing/tty2eth-evb/tty2eth-evb-F_Mask.pdf

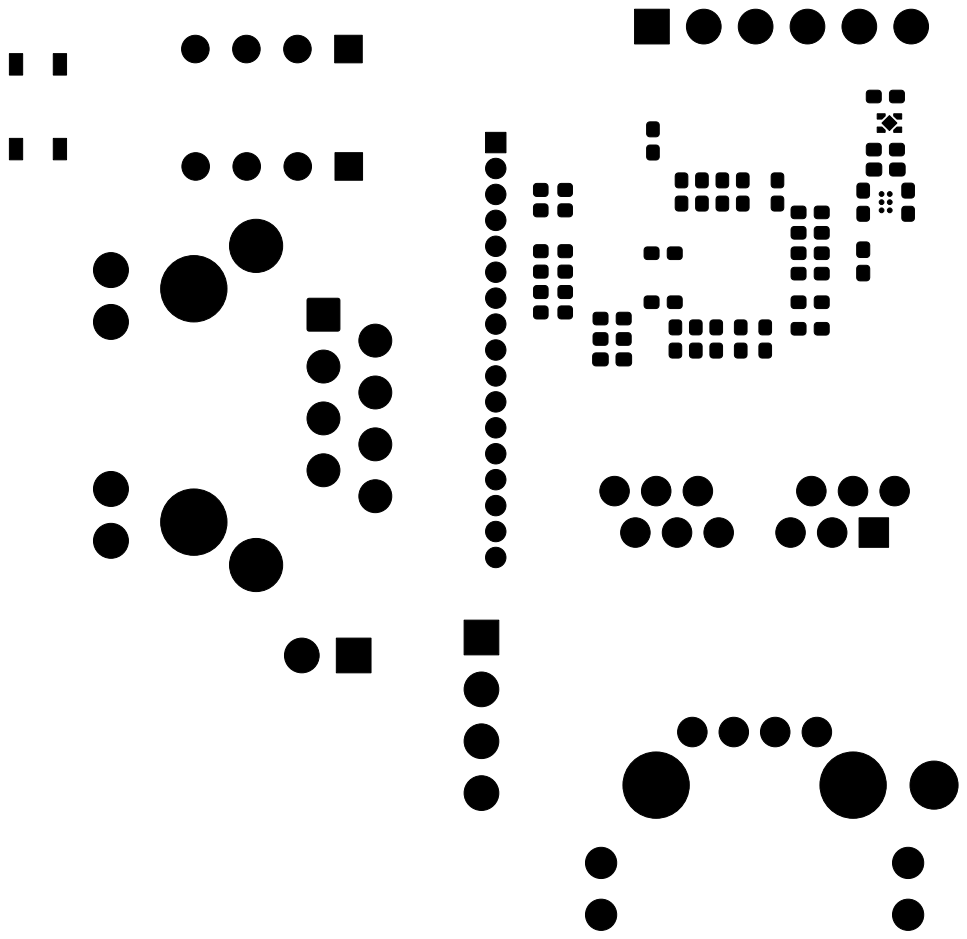
[picture p32: page 1]
