TCI-LUH/Gateway-Module-v3/pcbs/testing/tty2eth-evb/tty2eth-evb-F_Paste.pdf

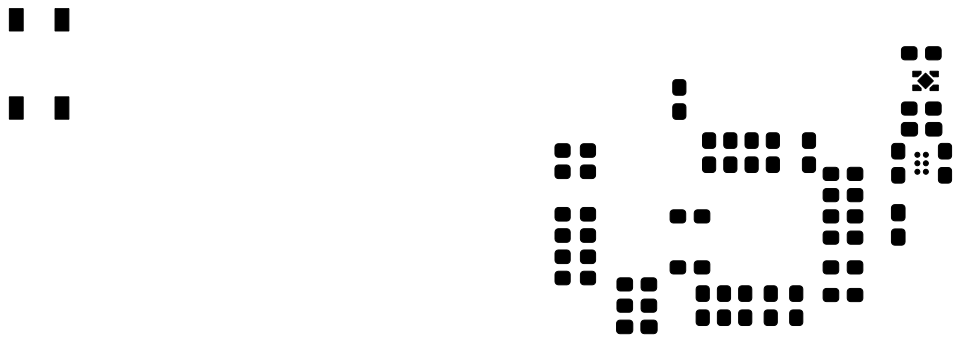
[picture p33: page 1]
