TCI-LUH/Gateway-Module-v3/pcbs/testing/tty2eth-evb/tty2eth-evb-F_Silkscreen.pdf

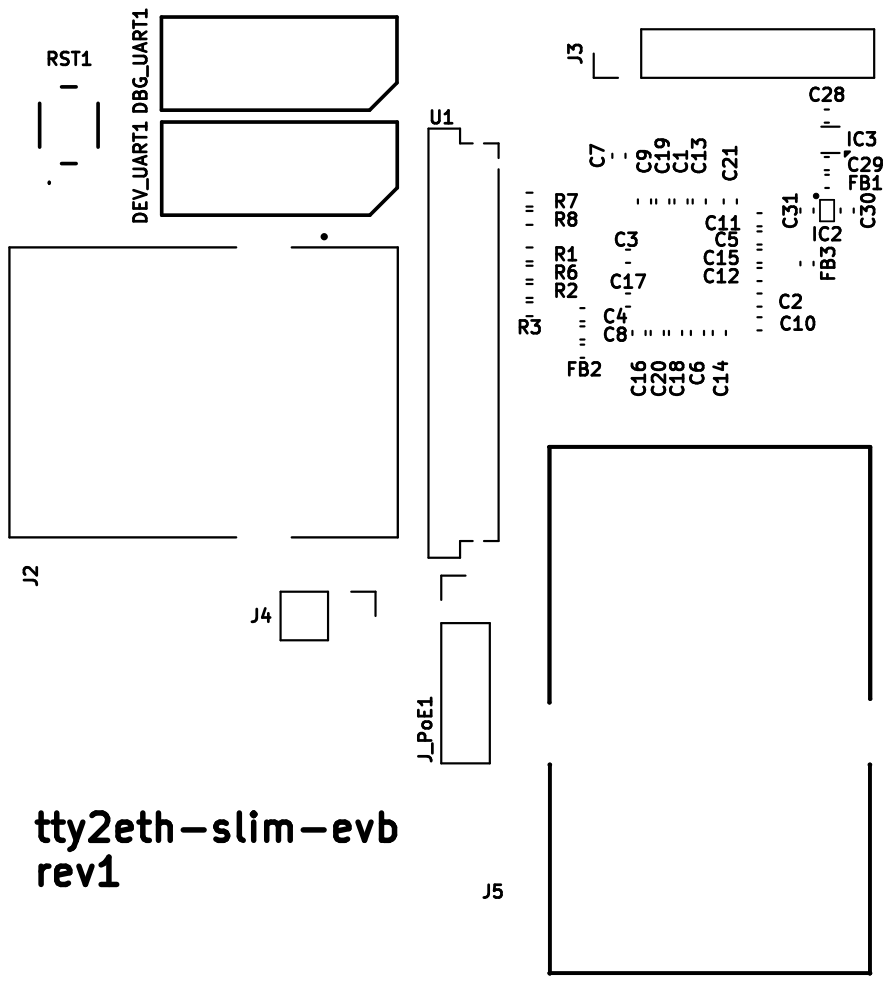
[picture p34: page 1]
