TCI-LUH/Gateway-Module-v3/pcbs/testing/tty2eth-evb/tty2eth-evb-GND_Cu.pdf

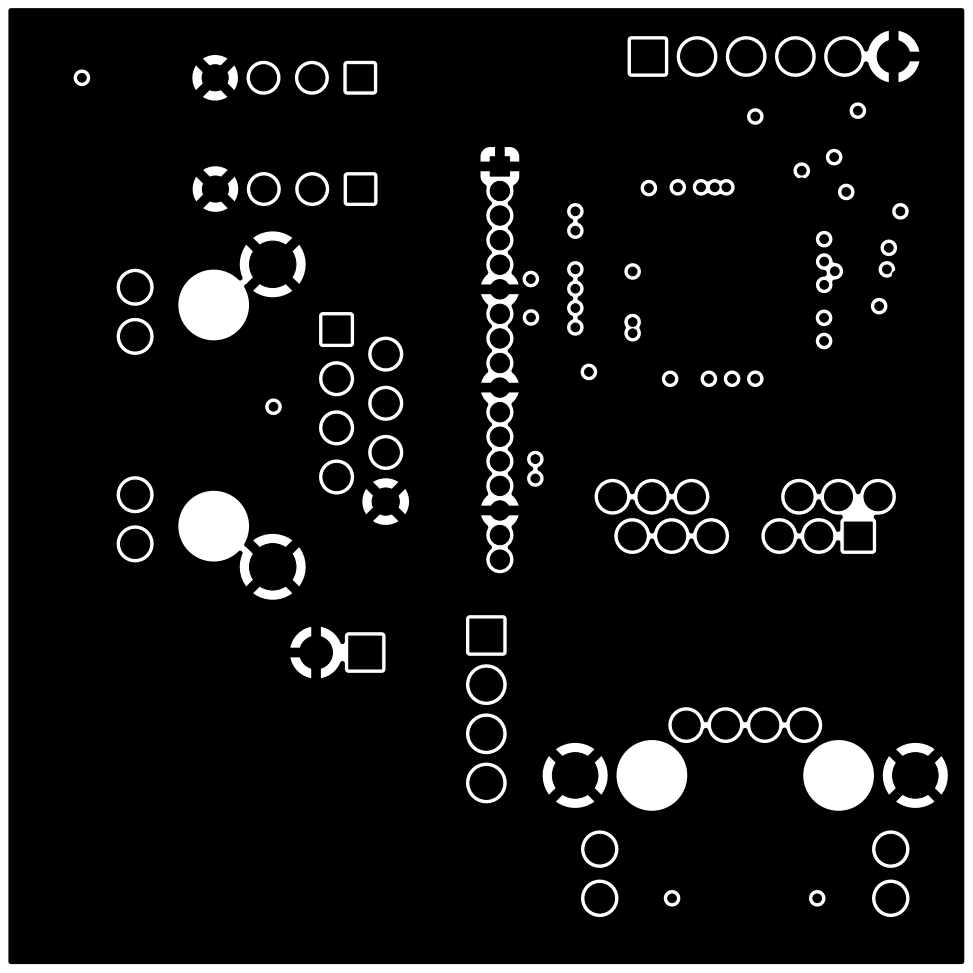
[picture p35: page 1]
