TCI-LUH/Gateway-Module-v3/pcbs/testing/tty2eth-evb/tty2eth-evb-VCC_Cu.pdf

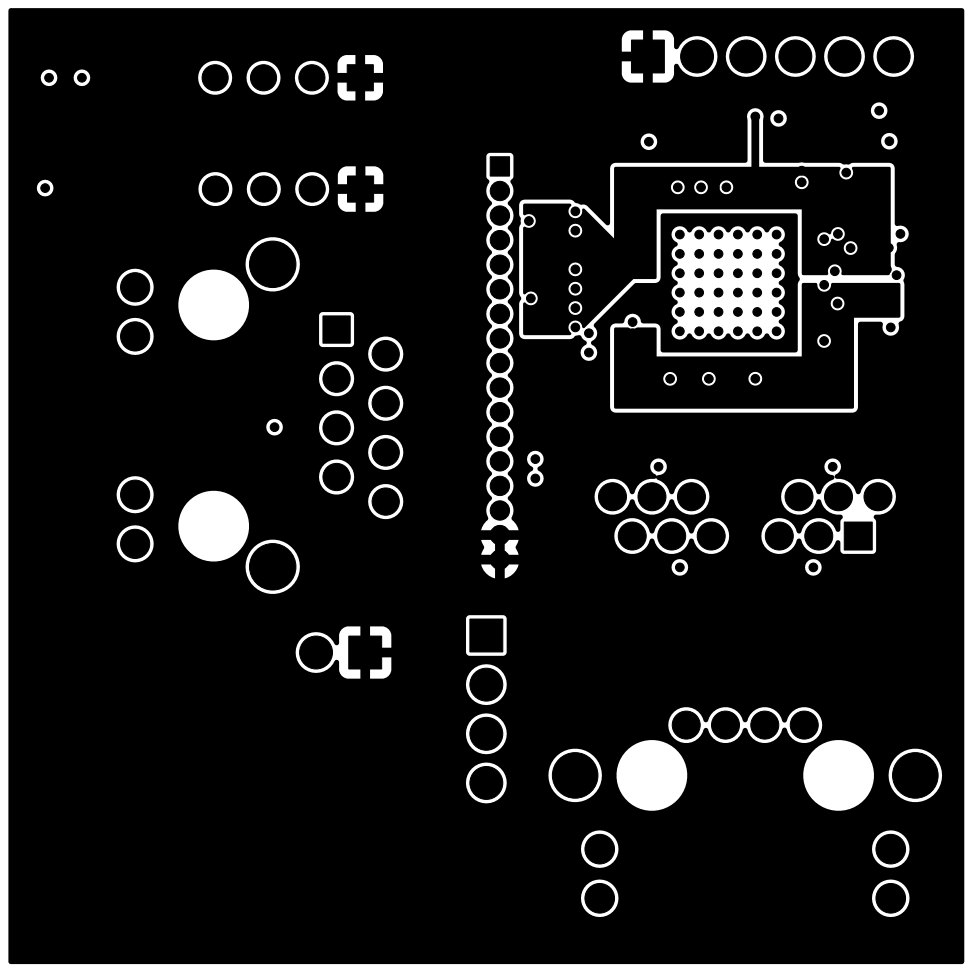
[picture p36: page 1]
