TCI-LUH/Gateway-Module-v3/pcbs/extensions/serial-extension/serial-extension.kicad_pcb

## KiCad design pcbs/extensions/serial-extension/serial-extension.kicad_pcb (2025-05-20)

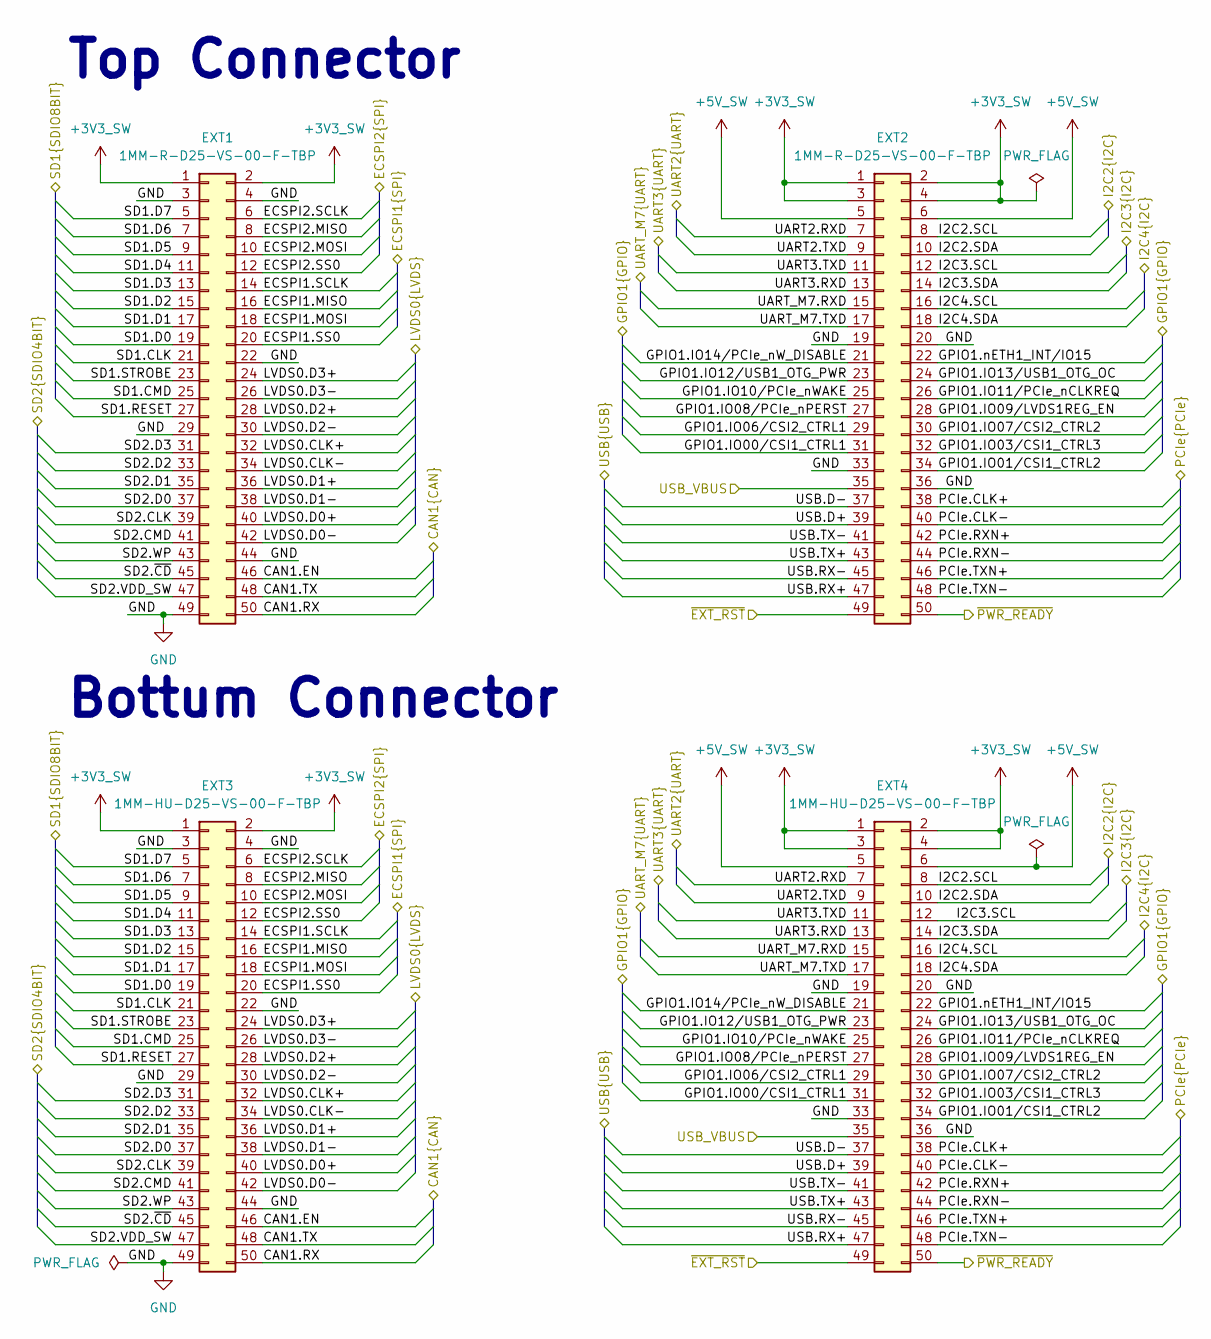
[picture p37: schematic connector.kicad_sch]

Parts:
EXT1, EXT2: 1MM-R-D25-VS-00-F-TBP; 1MMRD25VS00FTBP; Mouser Part Number 571-1MMRD25VS00FTBP
EXT3, EXT4: 1MM-HU-D25-VS-00-F-TBP; 1MMHUD25VS00FTBP; Mouser Part Number 571-1MMRD25VS00FTBP

Connections:
+3V3_SW: EXT1.1, EXT1.2, EXT2.1, EXT2.2, EXT2.3, EXT2.4, EXT3.1, EXT3.2, EXT4.1, EXT4.2, EXT4.3, EXT4.4; also elsewhere on the board
+5V_SW: EXT2.5, EXT2.6, EXT4.5, EXT4.6
/connector/CAN1.EN: EXT1.46, EXT3.46
/connector/CAN1.RX: EXT1.50, EXT3.50
/connector/CAN1.TX: EXT1.48, EXT3.48
/connector/ECSPI1.MISO: EXT1.16, EXT3.16
/connector/ECSPI1.MOSI: EXT1.18, EXT3.18
/connector/ECSPI1.SCLK: EXT1.14, EXT3.14
/connector/ECSPI1.SS0: EXT1.20, EXT3.20
/connector/ECSPI2.MISO: EXT1.8, EXT3.8
/connector/ECSPI2.MOSI: EXT1.10, EXT3.10
/connector/ECSPI2.SCLK: EXT1.6, EXT3.6
/connector/ECSPI2.SS0: EXT1.12, EXT3.12
/connector/GPIO1.IO00/CSI1_CTRL1: EXT2.31, EXT4.31
/connector/GPIO1.IO01/CSI1_CTRL2: EXT2.34, EXT4.34
/connector/GPIO1.IO03/CSI1_CTRL3: EXT2.32, EXT4.32
/connector/GPIO1.IO06/CSI2_CTRL1: EXT2.29, EXT4.29
/connector/GPIO1.IO07/CSI2_CTRL2: EXT2.30, EXT4.30
/connector/GPIO1.IO08/PCIe_nPERST: EXT2.27, EXT4.27
/connector/GPIO1.IO09/LVDS1REG_EN: EXT2.28, EXT4.28
/connector/GPIO1.IO10/PCIe_nWAKE: EXT2.25, EXT4.25
/connector/GPIO1.IO11/PCIe_nCLKREQ: EXT2.26, EXT4.26
/connector/GPIO1.IO12/USB1_OTG_PWR: EXT2.23, EXT4.23
/connector/GPIO1.IO13/USB1_OTG_OC: EXT2.24, EXT4.24
/connector/GPIO1.IO14/PCIe_nW_DISABLE: EXT2.21, EXT4.21
/connector/GPIO1.nETH1_INT/IO15: EXT2.22, EXT4.22
/connector/I2C2.SCL: EXT2.8, EXT4.8; also elsewhere on the board
/connector/I2C2.SDA: EXT2.10, EXT4.10; also elsewhere on the board
/connector/I2C3.SCL: EXT2.12, EXT4.12
/connector/I2C3.SDA: EXT2.14, EXT4.14
/connector/I2C4.SCL: EXT2.16, EXT4.16
/connector/I2C4.SDA: EXT2.18, EXT4.18
/connector/LVDS0.CLK+: EXT1.32, EXT3.32
/connector/LVDS0.CLK-: EXT1.34, EXT3.34
/connector/LVDS0.D0+: EXT1.40, EXT3.40
/connector/LVDS0.D0-: EXT1.42, EXT3.42
/connector/LVDS0.D1+: EXT1.36, EXT3.36
/connector/LVDS0.D1-: EXT1.38, EXT3.38
/connector/LVDS0.D2+: EXT1.28, EXT3.28
/connector/LVDS0.D2-: EXT1.30, EXT3.30
/connector/LVDS0.D3+: EXT1.24, EXT3.24
/connector/LVDS0.D3-: EXT1.26, EXT3.26
/connector/PCIe.CLK+: EXT2.38, EXT4.38
/connector/PCIe.CLK-: EXT2.40, EXT4.40
/connector/PCIe.RXN+: EXT2.42, EXT4.42
/connector/PCIe.RXN-: EXT2.44, EXT4.44
/connector/PCIe.TXN+: EXT2.46, EXT4.46
/connector/PCIe.TXN-: EXT2.48, EXT4.48
/connector/SD1.CLK: EXT1.21, EXT3.21
/connector/SD1.CMD: EXT1.25, EXT3.25
/connector/SD1.D0: EXT1.19, EXT3.19
/connector/SD1.D1: EXT1.17, EXT3.17
/connector/SD1.D2: EXT1.15, EXT3.15
/connector/SD1.D3: EXT1.13, EXT3.13
/connector/SD1.D4: EXT1.11, EXT3.11
/connector/SD1.D5: EXT1.9, EXT3.9
/connector/SD1.D6: EXT1.7, EXT3.7
/connector/SD1.D7: EXT1.5, EXT3.5
/connector/SD1.RESET: EXT1.27, EXT3.27
/connector/SD1.STROBE: EXT1.23, EXT3.23
/connector/SD2.CLK: EXT1.39, EXT3.39
/connector/SD2.CMD: EXT1.41, EXT3.41
/connector/SD2.D0: EXT1.37, EXT3.37
/connector/SD2.D1: EXT1.35, EXT3.35
/connector/SD2.D2: EXT1.33, EXT3.33
/connector/SD2.D3: EXT1.31, EXT3.31
/connector/SD2.VDD_SW: EXT1.47, EXT3.47
/connector/SD2.WP: EXT1.43, EXT3.43
/connector/SD2.~CD: EXT1.45, EXT3.45
/connector/UART2.RXD: EXT2.7, EXT4.7; also elsewhere on the board
/connector/UART2.TXD: EXT2.9, EXT4.9; also elsewhere on the board
/connector/UART3.RXD: EXT2.13, EXT4.13; also elsewhere on the board
/connector/UART3.TXD: EXT2.11, EXT4.11; also elsewhere on the board
/connector/UART_M7.RXD: EXT2.15, EXT4.15
/connector/UART_M7.TXD: EXT2.17, EXT4.17
/connector/USB.D+: EXT2.39, EXT4.39
/connector/USB.D-: EXT2.37, EXT4.37
/connector/USB.RX+: EXT2.47, EXT4.47
/connector/USB.RX-: EXT2.45, EXT4.45
/connector/USB.TX+: EXT2.43, EXT4.43
/connector/USB.TX-: EXT2.41, EXT4.41
/connector/USB_VBUS: EXT2.35, EXT4.35
/connector/~EXT_RST: EXT2.49, EXT4.49
/connector/~PWR_READY: EXT2.50, EXT4.50
GND: EXT1.3, EXT1.4, EXT1.22, EXT1.29, EXT1.44, EXT1.49, EXT2.19, EXT2.20, EXT2.33, EXT2.36, EXT3.3, EXT3.4, EXT3.22, EXT3.29, EXT3.44, EXT3.49, EXT4.19, EXT4.20, EXT4.33, EXT4.36; also elsewhere on the board

Notes on the sheet:
Top Connector
Bottum Connector

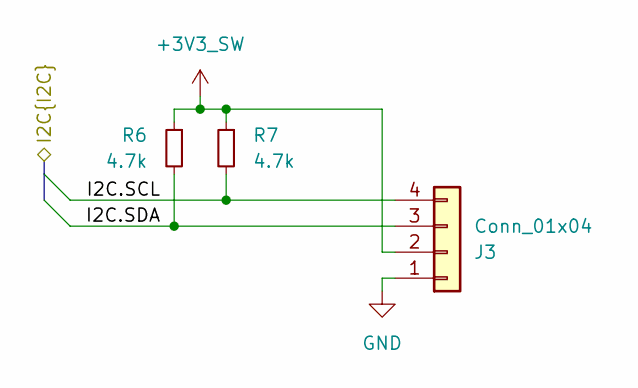
[picture p38: schematic i2c.kicad_sch]

Parts:
J3: Conn_01x04; PinHeader_1x04_P1.27mm_Horizontal; Mouser Part Number 437-8501000420001101
R6, R7: 4.7k; R_0402; Mouser Part Number 652-CR0402FX-4701GLF

Connections:
+3V3_SW: J3.2, R6.1, R7.1; also elsewhere on the board
/connector/I2C2.SCL: J3.4, R7.2; also elsewhere on the board
/connector/I2C2.SDA: J3.3, R6.2; also elsewhere on the board
GND: J3.1; also elsewhere on the board

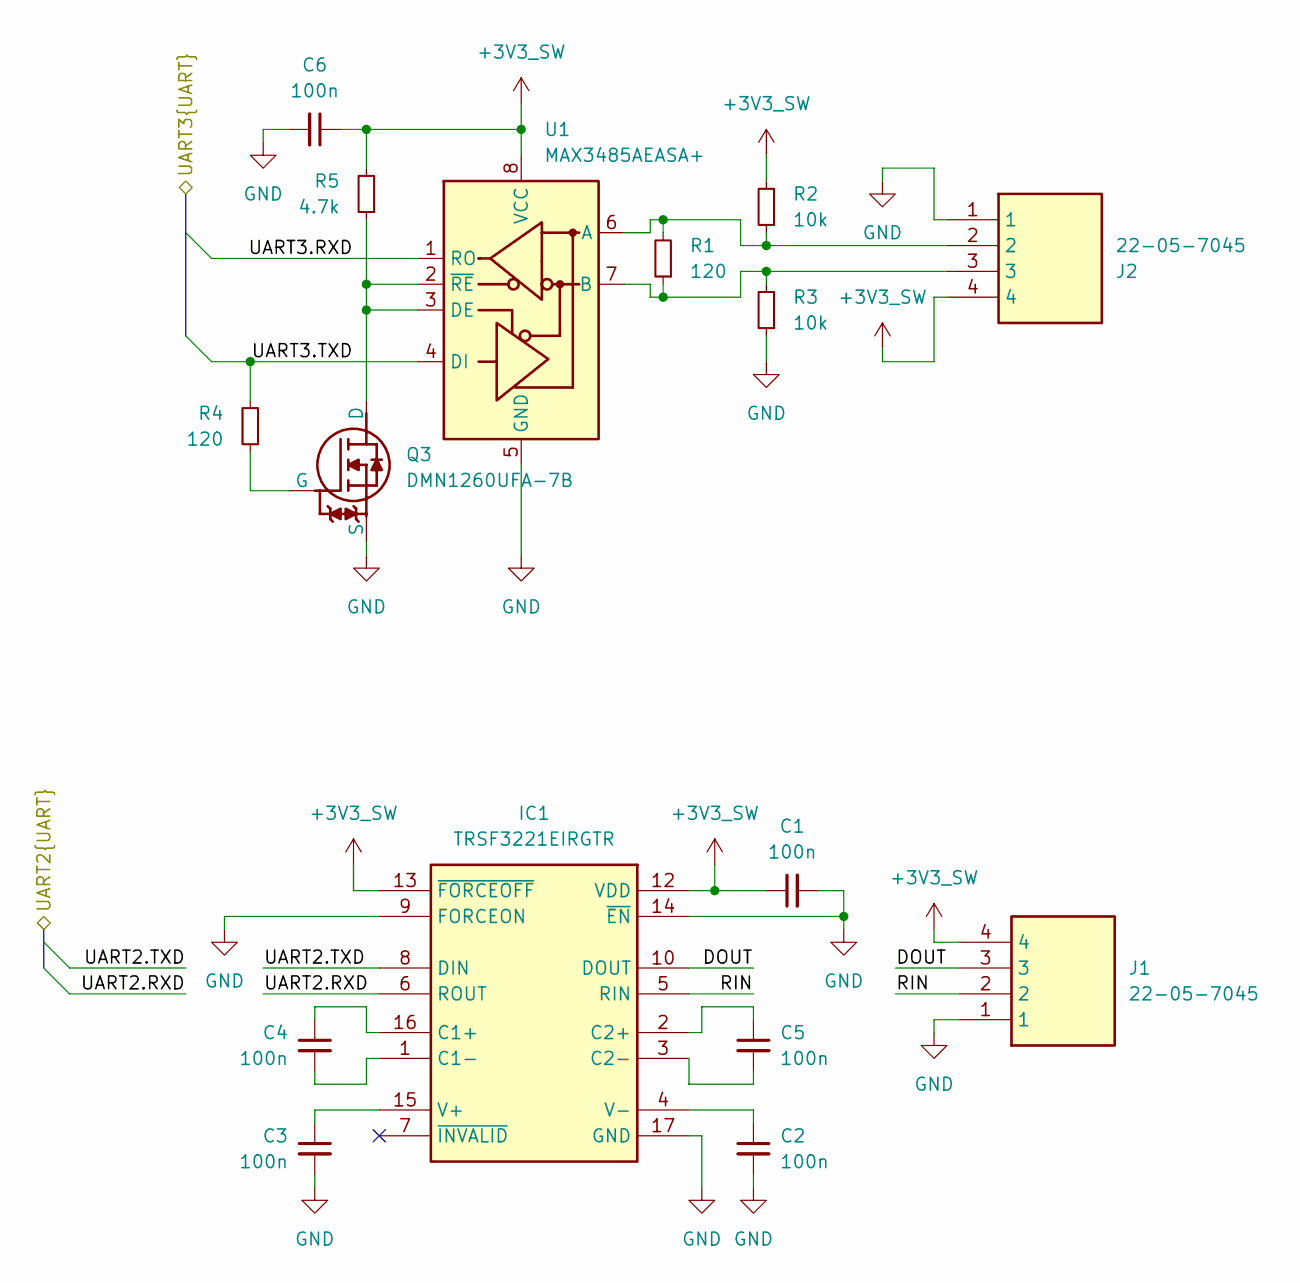
[picture p39: schematic serial.kicad_sch]

Parts:
C1, C2, C3, C4, C5, C6: 100n; C_0402; Mouser Part Number 80-C0402C104K4R7867
IC1: TRSF3221EIRGTR; QFN50P300X300X100-17N-D; Mouser Part Number 595-TRSF3221EIRGTR
J1, J2: 22-05-7045; SHDRRA4W45P0X250_1X4_1240X790X510P; Mouser Part Number 538-22-05-7045
Q3: DMN1260UFA-7B; DMN1260UFA7B; Mouser Part Number 621-DMN1260UFA-7B
R1, R4: 120; R_0402; Mouser Part Number 603-AC0402FR-07120RL
R2, R3: 10k; R_0402; Mouser Part Number 652-CR0402AFX1002GAS
R5: 4.7k; R_0402; Mouser Part Number 652-CR0402FX-4701GLF
U1: MAX3485AEASA+; SOIC-8_3.9x4.9mm_P1.27mm; Mouser Part Number 700-MAX3485AEASA+

Connections:
+3V3_SW: C1.1, C6.1, IC1.12 (VDD), IC1.13 (~FORCEOFF), J1.4, J2.4, R2.2, R5.2, U1.8 (VCC); also elsewhere on the board
/connector/UART2.RXD: IC1.6 (ROUT); also elsewhere on the board
/connector/UART2.TXD: IC1.8 (DIN); also elsewhere on the board
/connector/UART3.RXD: U1.1 (RO); also elsewhere on the board
/connector/UART3.TXD: R4.2, U1.4 (DI); also elsewhere on the board
/serial/DOUT: IC1.10 (DOUT), J1.3
/serial/RIN: IC1.5 (RIN), J1.2
GND: C1.2, C2.2, C3.2, C6.2, IC1.9 (FORCEON), IC1.11 (GND), IC1.14 (~EN), IC1.17 (GND), J1.1, J2.1, Q3.2 (S), R3.1, U1.5 (GND); also elsewhere on the board
unnamed: C4.1, IC1.16 (C1+)
unnamed: C4.2, IC1.1 (C1-)
unnamed: C5.1, IC1.2 (C2+)
unnamed: C5.2, IC1.3 (C2-)
unnamed: C3.1, IC1.15 (V+)
unnamed: C2.1, IC1.4 (V-)
unnamed: Q3.3 (D), R5.1, U1.2 (~RE), U1.3 (DE)
unnamed: Q3.1 (G), R4.1
unnamed: J2.2, R1.2, R2.1, U1.6 (A)
unnamed: J2.3, R1.1, R3.2, U1.7 (B)

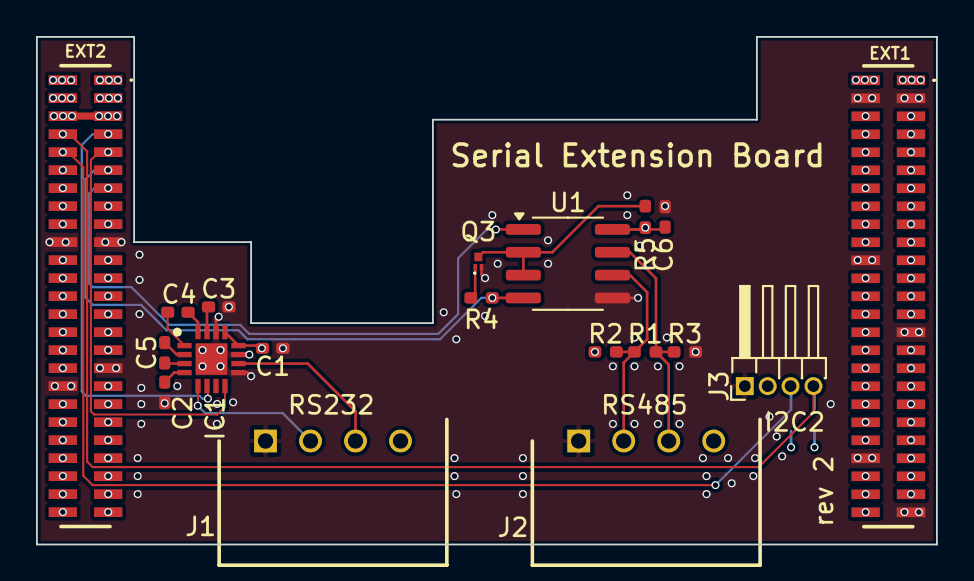
[picture p40: board serial-extension.kicad_pcb from above]

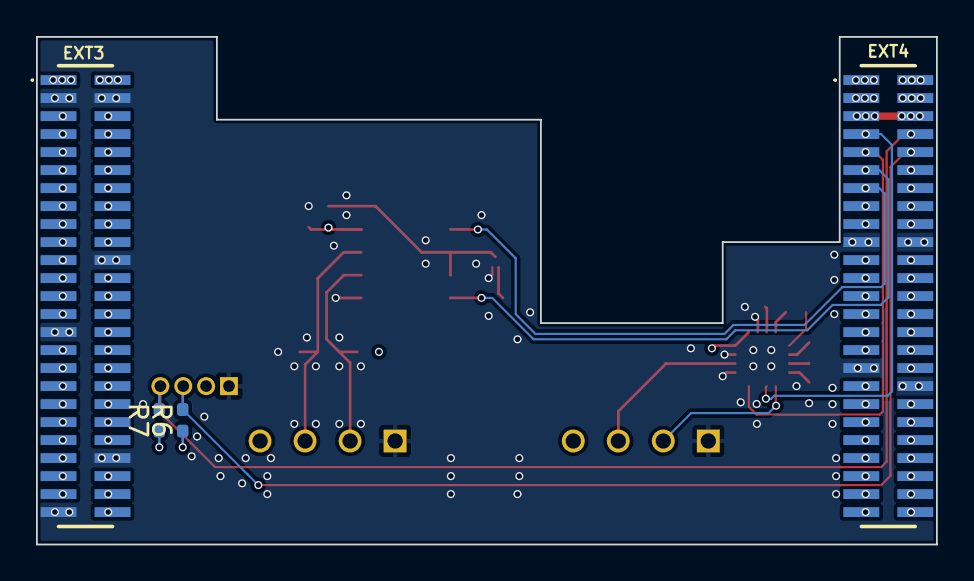
[picture p41: board serial-extension.kicad_pcb from below]

Board: 4 copper layers, 50.0 x 28.2 mm, 23 parts (4 on the bottom side), 97 nets.
