TCI-LUH/Gateway-Module-v3/pcbs/testing/power-test/power-test.kicad_pcb

## KiCad design pcbs/testing/power-test/power-test.kicad_pcb (2025-05-20)

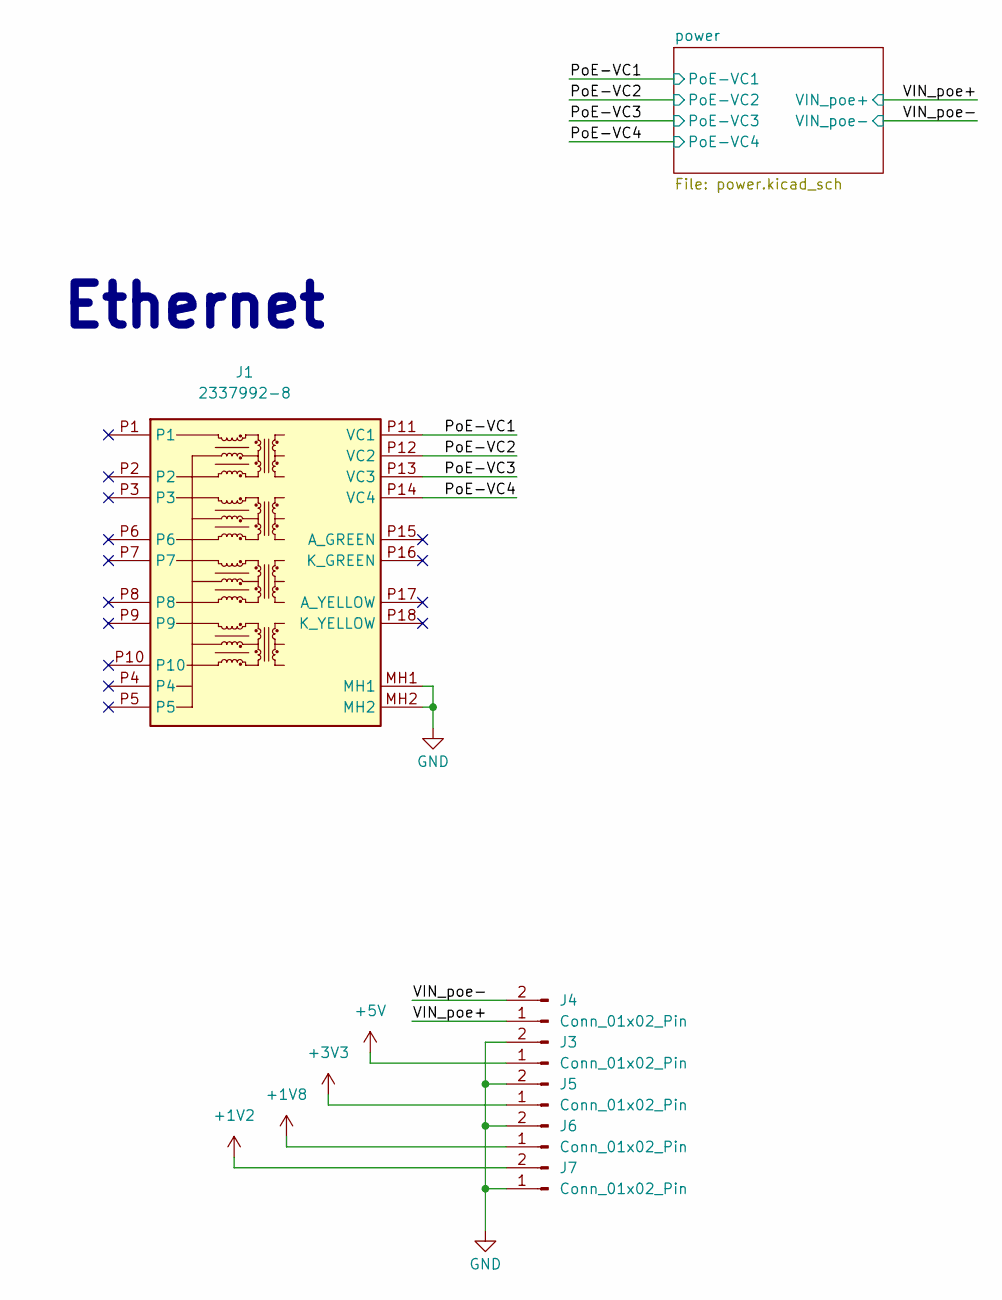
[picture p42: schematic power-test.kicad_sch]

Parts:
J1: 2337992-8; 23379928; Mouser Part Number 571-2337992-8
J3, J4, J5, J6, J7: Conn_01x02_Pin; PinHeader_1x02_P2.54mm_Horizontal

Connections:
+1V2: J7.2; also elsewhere on the board
+1V8: J6.1; also elsewhere on the board
+3V3: J5.1; also elsewhere on the board
+5V: J3.1; also elsewhere on the board
/PoE-VC1: J1.P11 (VC1); also elsewhere on the board
/PoE-VC2: J1.P12 (VC2); also elsewhere on the board
/PoE-VC3: J1.P13 (VC3); also elsewhere on the board
/PoE-VC4: J1.P14 (VC4); also elsewhere on the board
/VIN_poe+: J4.1; also elsewhere on the board
/VIN_poe-: J4.2; also elsewhere on the board
GND: J1.MH1, J1.MH2, J3.2, J5.2, J6.2, J7.1; also elsewhere on the board

Notes on the sheet:
Ethernet

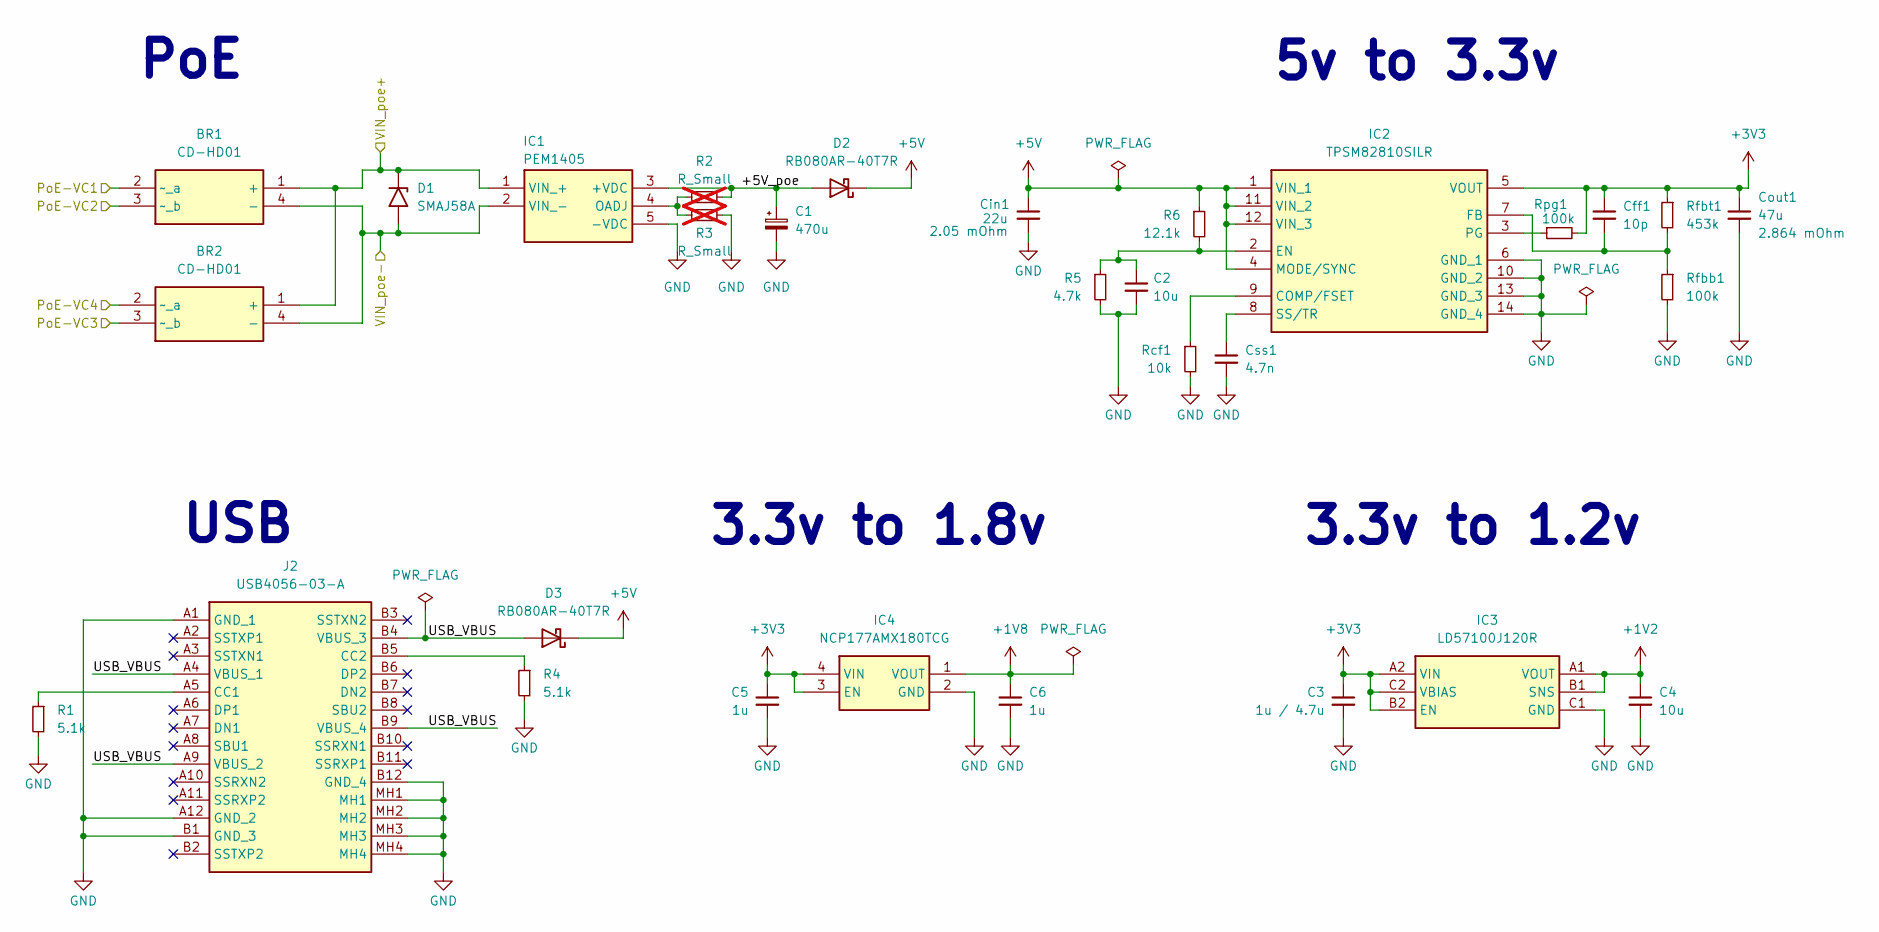
[picture p43: schematic power.kicad_sch]

Parts:
BR1, BR2: CD-HD01; CDHD01; Mouser Part Number 652-CD-HD01
C1: 470u; CP_Radial_D6.3mm_P2.50mm; Mouser Part Number 661-APSE6R3L471MF08S
C2: 10u; C_0402_1005Metric_Pad0.74x0.62mm_HandSolder; Mouser Part Number 80-C0603X472J4RECAUT
C3: 1u / 4.7u; C_0402_1005Metric_Pad0.74x0.62mm_HandSolder
C4: 10u; C_0402_1005Metric_Pad0.74x0.62mm_HandSolder
C5, C6: 1u; C_0402_1005Metric_Pad0.74x0.62mm_HandSolder; Mouser Part Number 187-CL05A105KO5NNNC
Cff1: 10p; C_0603_1608Metric_Pad1.08x0.95mm_HandSolder; Mouser Part Number 581-06035A100J
Cin1: 22u; C_0805_2012Metric_Pad1.18x1.45mm_HandSolder; Mouser Part Number 810-C2012X5R1V226MAC
Cout1: 47u; C_1206_3216Metric_Pad1.33x1.80mm_HandSolder; Mouser Part Number 81-GRM32ER71A476KE5L
Css1: 4.7n; C_0603_1608Metric_Pad1.08x0.95mm_HandSolder; Mouser Part Number 80-C0603X472J4RECAUT
D1: SMAJ58A; D_SMA; Mouser Part Number 576-SMAJ58A
D2, D3: RB080AR-40T7R; D_2010_5025Metric_Pad1.52x2.65mm_HandSolder; Mouser Part Number 755-RB080AR-40T7R
IC1: PEM1405; Manufacturer_Part_Number PEM1405
IC2: TPSM82810SILR; Mouser Part Number 595-TPSM82810SILR
IC3: LD57100J120R; BGA6C40P2X3_78X118X36; Mouser Part Number 511-LD57100J120R
IC4: NCP177AMX180TCG; OnSemi_XDFN4-1EP_1.0x1.0mm_EP0.52x0.52mm; Mouser Part Number 863-NCP177AMX180TCG
J2: USB4056-03-A; USB405603A; Mouser Part Number 640-USB4056-03-A
R1, R4: 5.1k; R_0402_1005Metric_Pad0.72x0.64mm_HandSolder
R2, R3: R_Small; R_0402_1005Metric_Pad0.72x0.64mm_HandSolder; not fitted
R5: 4.7k; R_0402_1005Metric_Pad0.72x0.64mm_HandSolder; Mouser Part Number 71-CRCW0402-10K-E3
R6: 12.1k; R_0402_1005Metric_Pad0.72x0.64mm_HandSolder; Mouser Part Number 71-CRCW0402-10K-E3
Rcf1: 10k; R_0402_1005Metric_Pad0.72x0.64mm_HandSolder; Mouser Part Number 71-CRCW0402-10K-E3
Rfbb1: 100k; R_0402_1005Metric_Pad0.72x0.64mm_HandSolder; Mouser Part Number 71-CRCW0402-100K-E3
Rfbt1: 453k; R_0402_1005Metric_Pad0.72x0.64mm_HandSolder; Mouser Part Number 71-CRCW0402-453K-E3
Rpg1: 100k; R_0402_1005Metric_Pad0.72x0.64mm_HandSolder; Mouser Part Number 71-CRCW0402-100K-E3

Connections:
+1V2: C4.1, IC3.A1 (VOUT), IC3.B1 (SNS); also elsewhere on the board
+1V8: C6.1, IC4.1 (VOUT); also elsewhere on the board
+3V3: C3.1, C5.1, Cff1.1, Cout1.1, IC2.5 (VOUT), IC3.A2 (VIN), IC3.B2 (EN), IC3.C2 (VBIAS), IC4.3 (EN), IC4.4 (VIN), Rfbt1.1, Rpg1.2; also elsewhere on the board
+5V: Cin1.1, D2.1 (K), D3.1 (K), IC2.1 (VIN_1), IC2.4 (MODE/SYNC), IC2.11 (VIN_2), IC2.12 (VIN_3), R6.1; also elsewhere on the board
/PoE-VC1: BR1.2 (~_a); also elsewhere on the board
/PoE-VC2: BR1.3 (~_b); also elsewhere on the board
/PoE-VC3: BR2.3 (~_b); also elsewhere on the board
/PoE-VC4: BR2.2 (~_a); also elsewhere on the board
/VIN_poe+: BR1.1 (+), BR2.1 (+), D1.1 (A1), IC1.1 (VIN_+); also elsewhere on the board
/VIN_poe-: BR1.4 (-), BR2.4 (-), D1.2 (A2), IC1.2 (VIN_-); also elsewhere on the board
/power/+5V_poe: C1.1, D2.2 (A), IC1.3 (+VDC), R2.2
/power/USB_VBUS: D3.2 (A), J2.A4 (VBUS_1), J2.A9 (VBUS_2), J2.B4 (VBUS_3), J2.B9 (VBUS_4)
GND: C1.2, C2.2, C3.2, C4.2, C5.2, C6.2, Cin1.2, Cout1.2, Css1.2, IC1.5 (-VDC), IC2.6 (GND_1), IC2.10 (GND_2), IC2.13 (GND_3), IC2.14 (GND_4), IC3.C1 (GND), IC4.2 (GND), IC4.5 (GND), J2.A1 (GND_1), J2.A12 (GND_2), J2.B1 (GND_3), J2.B12 (GND_4), J2.MH1, J2.MH2, J2.MH3, J2.MH4, R1.2, R3.2, R4.2, R5.2, Rcf1.2, Rfbb1.2; also elsewhere on the board
unnamed: IC1.4 (OADJ), R2.1, R3.1
unnamed: IC2.9 (COMP/FSET), Rcf1.1
unnamed: C2.1, IC2.2 (EN), R5.1, R6.2
unnamed: Cff1.2, IC2.7 (FB), Rfbb1.1, Rfbt1.2
unnamed: IC2.3 (PG), Rpg1.1
unnamed: Css1.1, IC2.8 (SS/TR)
unnamed: J2.A5 (CC1), R1.1
unnamed: J2.B5 (CC2), R4.1

Notes on the sheet:
USB
3.3v to 1.8v
3.3v to 1.2v
5v to 3.3v
PoE

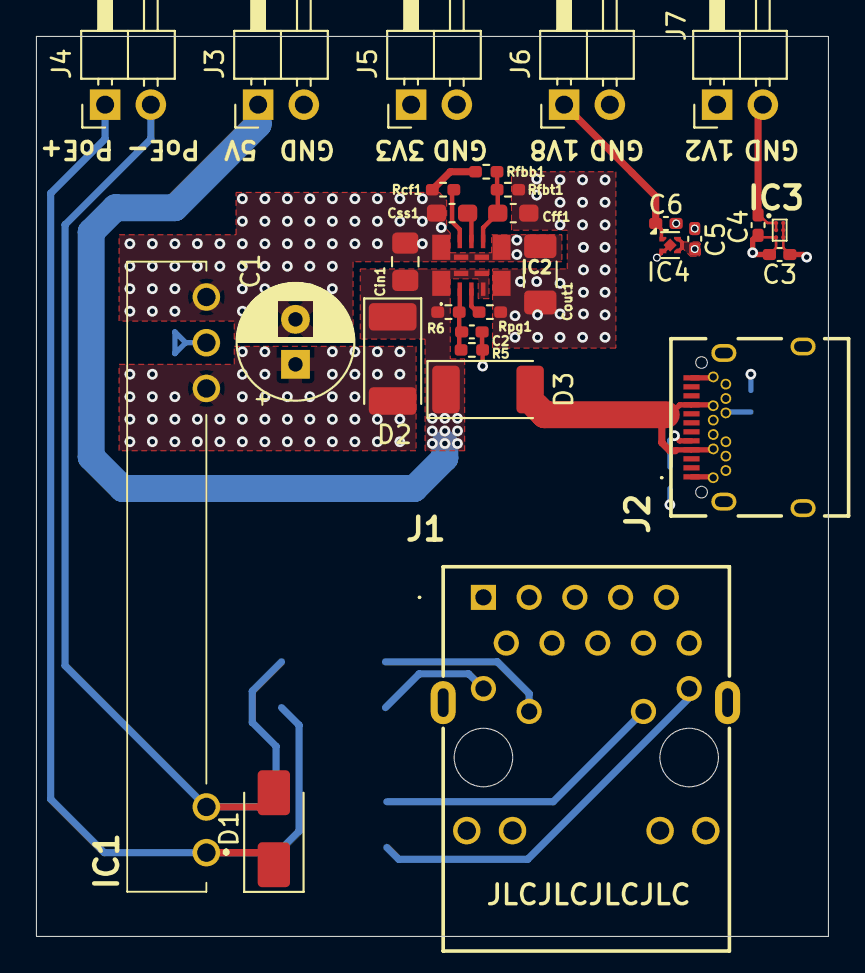
[picture p44: board power-test.kicad_pcb from above]

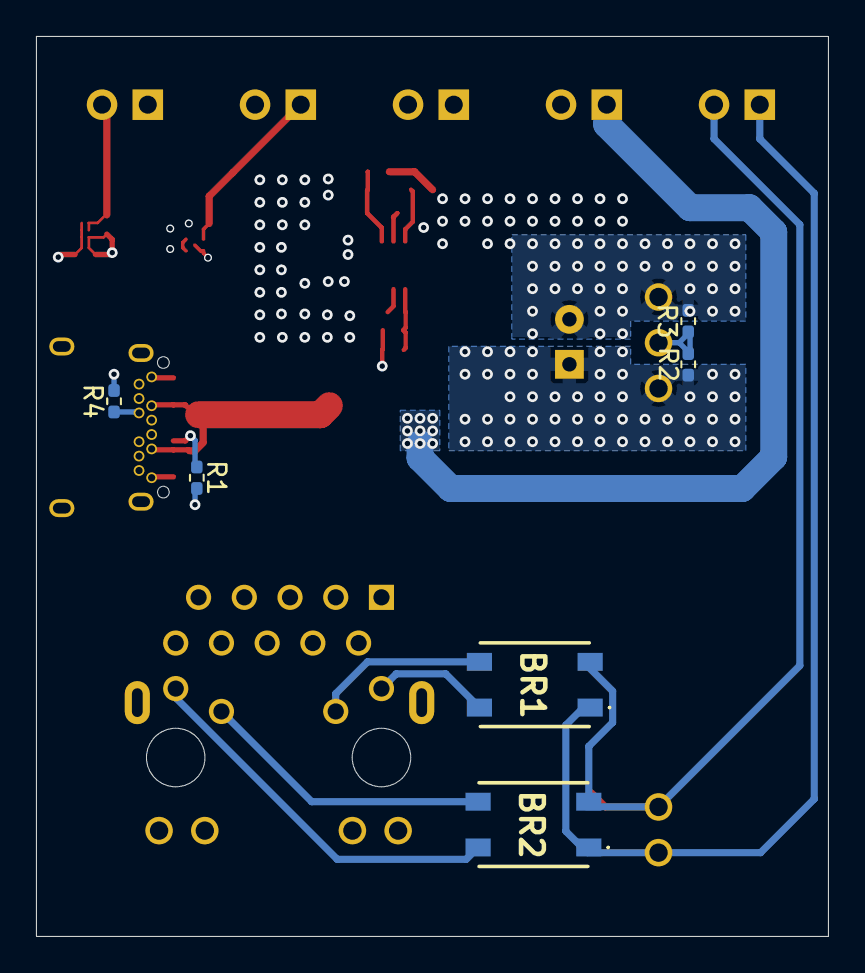
[picture p45: board power-test.kicad_pcb from below]

Board: 4 copper layers, 44.0 x 50.0 mm, 36 parts (6 on the bottom side), 21 nets.
