TCI-LUH/Gateway-Module-v3/pcbs/testing/tty2eth-evb/tty2eth-evb.kicad_pcb

## KiCad design pcbs/testing/tty2eth-evb/tty2eth-evb.kicad_pcb (2025-05-20)

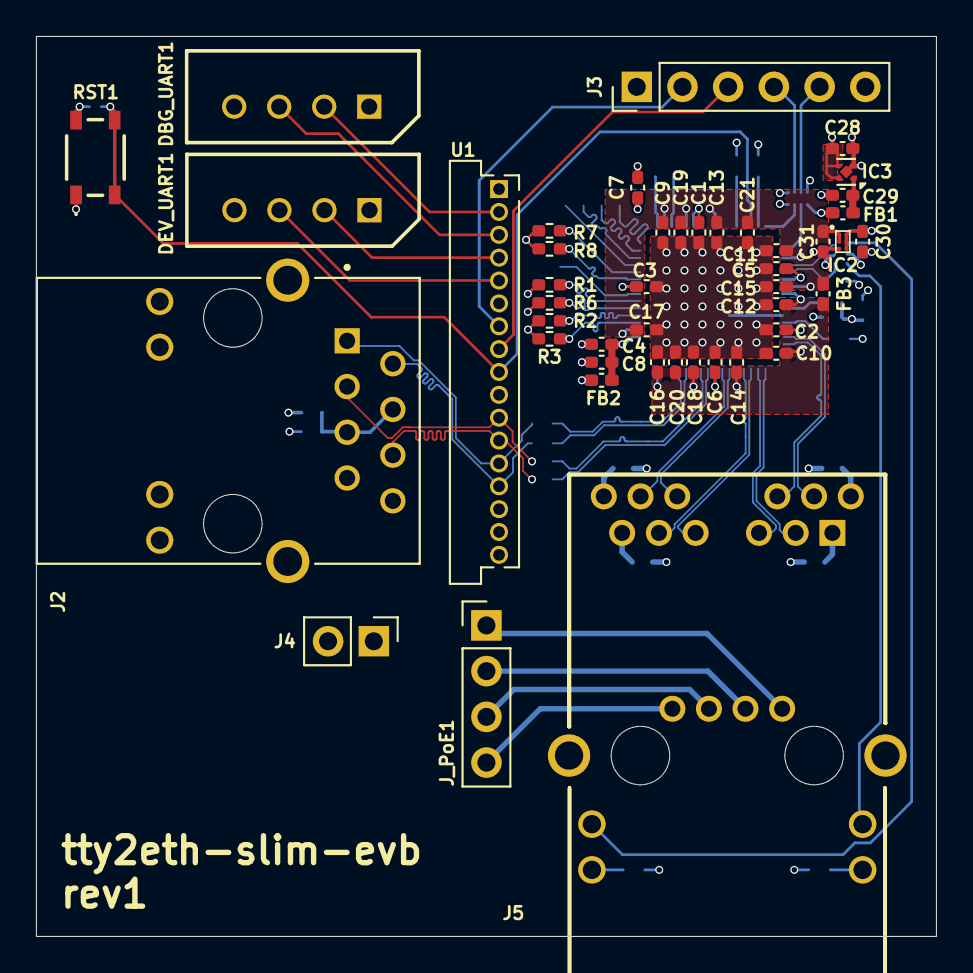
[picture p46: board tty2eth-evb.kicad_pcb from above]

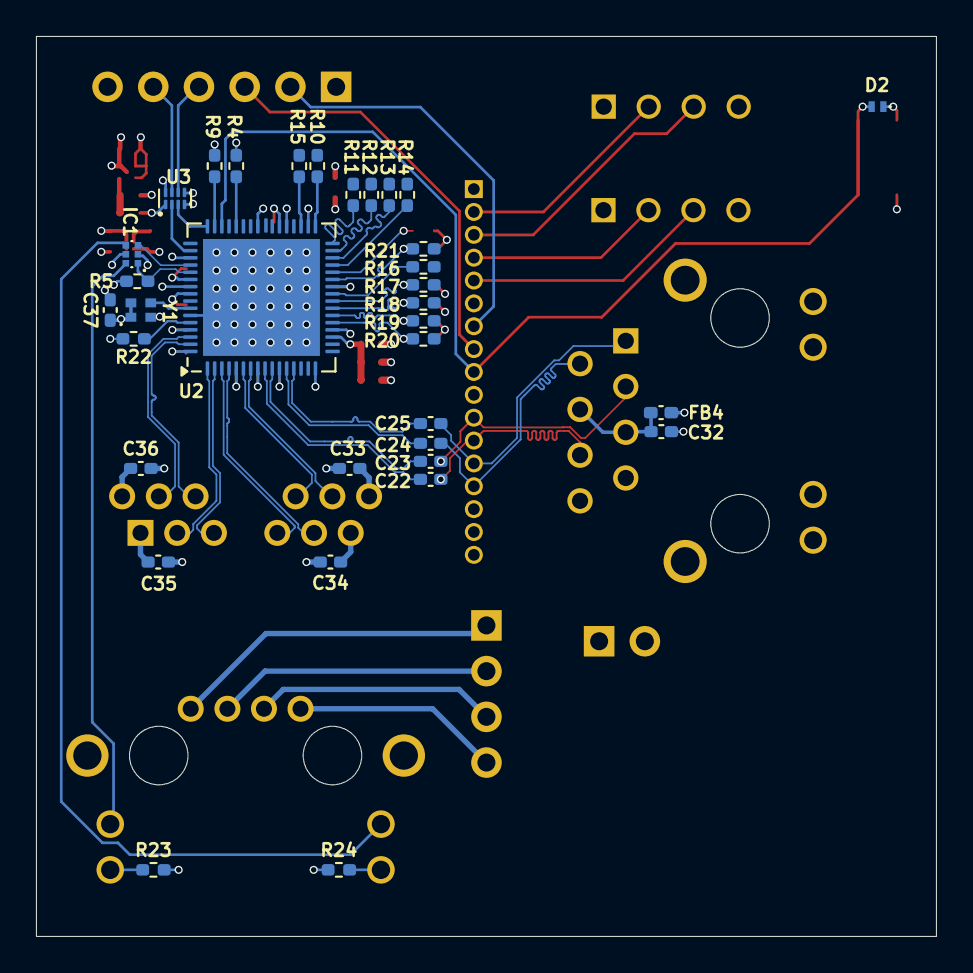
[picture p47: board tty2eth-evb.kicad_pcb from below]

Board: 4 copper layers, 50.0 x 50.0 mm, 79 parts (34 on the bottom side), 66 nets.

Parts:
C1, C2, C3, C4, C5, C6, C9, C10, C11, C12, C13, C14, C15, C16, C17, C18, C19, C22, C23, C24, C25, C33, C34, C35, C36, C37: 100n; C_0402_1005Metric_Pad0.74x0.62mm_HandSolder
C7, C8, C20, C21: 22u; C_0402_1005Metric_Pad0.74x0.62mm_HandSolder
C28, C29: 1u; C_0402_1005Metric_Pad0.74x0.62mm_HandSolder
C30: 1u / 4.7u; C_0402_1005Metric_Pad0.74x0.62mm_HandSolder
C31: 10u; C_0402_1005Metric_Pad0.74x0.62mm_HandSolder
C32: 22n; C_0402_1005Metric_Pad0.74x0.62mm_HandSolder
D2: SC1333-01ETG; SC133301ETG
DBG_UART1: 22-03-5045; SHDR4W70P0X250_1X4_1240X490X610P
DEV_UART1: 22-03-5045; SHDR4W70P0X250_1X4_1240X490X610P
FB1, FB2, FB3: BLM15PX121SN1D; L_0402_1005Metric_Pad0.77x0.64mm_HandSolder
FB4: BLM15PE300SH1D; L_0402_1005Metric_Pad0.77x0.64mm_HandSolder
IC1: 74AUP2G07GM; PESD3V3L5UF115
IC2: LD57100J120R; BGA6C40P2X3_78X118X36
IC3: NCP177AMX180TCG; OnSemi_XDFN4-1EP_1.0x1.0mm_EP0.52x0.52mm
J2: CRJ011-ML1-TH; CUI_CRJ011-ML1-TH
J3: Conn_01x06; PinHeader_1x06_P2.54mm_Vertical
J4: Conn_01x02; PinHeader_1x02_P2.54mm_Vertical
J5: JT4-1202HL; JT41202HL
J_PoE1: Conn_01x04; PinHeader_1x04_P2.54mm_Vertical
R1, R2, R3, R4, R5: 4.7k; R_0402_1005Metric_Pad0.72x0.64mm_HandSolder
R6, R7, R8, R9, R23, R24: 1k; R_0402_1005Metric_Pad0.72x0.64mm_HandSolder
R10, R11, R12, R13, R14, R15, R16, R17, R18, R19, R20, R21: 33; R_0402_1005Metric_Pad0.72x0.64mm_HandSolder
R22: 6.04k; R_0402_1005Metric_Pad0.72x0.64mm_HandSolder
RST1: TS20-42-25-WT-160-SMT-TR; TS204225WT160SMTTR
U1: tty2usb-slim; tty2eth-slim
U2: KSZ9563RNX; QFN-64-1EP_8x8mm_P0.4mm_EP6.5x6.5mm
U3: TXS0102DQER; X2SON-8_1.4x1mm_P0.35mm
Y1: ECS-1612MV-250-CN-TR; ECS1612MV250CNTR

Connections:
+1V2: C9.1, C11.1, C13.1, C15.1, C17.1, C19.1, C21.1, C31.1, FB3.1, IC2.A1 (VOUT), IC2.B1 (SNS), U2.20 (DVDDL), U2.34 (DVDDL), U2.37 (DVDDL), U2.41 (DVDDL), U2.51 (DVDDL), U2.55 (DVDDL)
+1V8: C29.1, FB1.1, IC3.1 (VOUT)
+3V3: C28.1, C30.1, DBG_UART1.1, DEV_UART1.1, FB2.1, FB4.2, IC2.A2 (VIN), IC2.B2 (EN), IC2.C2 (VBIAS), IC3.3 (EN), IC3.4 (VIN), J3.1, J4.1, R23.1, R24.1, U1.16 (VDD), U1.17 (VCC), U3.8 (VCCB)
/DBG_UART_RX: DBG_UART1.2, U1.2 (DBG_UART_RX)
/DBG_UART_TX: DBG_UART1.3, U1.3 (DBG_UART_TX)
/DEV_RST: J3.2, U1.7 (DEV_RST)
/DEV_UART_RX: DEV_UART1.3, U1.5 (DEV_UART_RX)
/DEV_UART_TX: DEV_UART1.2, U1.4 (DEV_UART_TX)
/EXT_TMP: J3.3, U1.8 (EXT_TMP)
/PHY_RX+: C23.2, J2.P3 (RXP), U1.11 (PHY_RX+)
/PHY_RX-: C22.2, J2.P6 (RXN), U1.12 (PHY_RX-)
/PHY_TX+: C25.2, J2.P1 (TXP), U1.13 (PHY_TX+)
/PHY_TX-: C24.2, J2.P2 (TXN), U1.14 (PHY_TX-)
/SCL: J3.5, U3.7 (B1)
/SDA: J3.4, U3.6 (B2)
/switch/GRN+: J5.20 (GRN+), R24.2
/switch/GRN-: IC1.4 (2Y), J5.19 (GRN-)
/switch/KDZ_SCL: U2.50 (SCL/MDC), U3.2 (A1)
/switch/KDZ_SDA: U2.48 (SDI/SDA/MDIO), U3.3 (A2)
/switch/KSZ_AVDDH: C2.1, C4.1, C6.1, C8.1, C37.1, FB2.2, U2.8 (AVDDH), U2.19 (AVDDH), U2.61 (AVDDH), Y1.1 (STAND-BY), Y1.4 (VDD)
/switch/KSZ_AVDDL: C10.1, C12.1, C14.1, C16.1, C18.1, C20.1, FB3.2, U2.5 (AVDDL), U2.11 (AVDDL), U2.16 (AVDDL), U2.56 (AVDDL), U2.64 (AVDDL)
/switch/KSZ_LED1_0: IC1.3 (2A), U2.52 (LED1_0)
/switch/KSZ_LED1_1: IC1.1 (1A), R5.2, U2.53 (LED1_1)
/switch/KSZ_RXD0: R1.2, R17.2, U2.24 (RXD0)
/switch/KSZ_RXD1: R6.2, R18.2, U2.23 (RXD1)
/switch/KSZ_RXD2: R2.2, R19.2, U2.22 (RXD2)
/switch/KSZ_RXD3: R3.2, R20.2, U2.21 (RXD3)
/switch/KSZ_RX_CLK: R16.2, U2.25 (RX_CLK/REFCLKO)
/switch/KSZ_RX_CTL: R8.1, R21.2, U2.27 (RX_DV/CRS_DV/RX_CTL)
/switch/KSZ_RX_ER: R7.1, U2.28 (RX_ER)
/switch/KSZ_SDO: R9.1, U2.47 (SDO)
/switch/KSZ_TXD0: R11.2, U2.32 (TXD0)
/switch/KSZ_TXD1: R12.2, U2.31 (TXD1)
/switch/KSZ_TXD2: R13.2, U2.30 (TXD2)
/switch/KSZ_TXD3: R14.2, U2.29 (TXD3)
/switch/KSZ_TX_CLK: R10.2, U2.33 (TX_CLK/REFCLKI)
/switch/KSZ_TX_CTL: R15.2, U2.35 (TX_EN/TX_CTL)
/switch/KSZ_VDDIO: C1.1, C3.1, C5.1, C7.1, FB1.2, IC1.5 (VCC), R1.1, R2.1, R3.1, R4.1, R5.1, U2.26 (VDDIO), U2.38 (VDDIO), U2.54 (VDDIO), U3.1 (VCCA), U3.5 (OE)
/switch/KSZ_~PME: R4.2, U2.44 (~PME)
/switch/TRP1: J5.13 (TRP1), J_PoE1.1
/switch/TRP2: J5.14 (TRP2), J_PoE1.2
/switch/TRP3: J5.15 (TRP3), J_PoE1.3
/switch/TRP4: J5.16 (TRP4), J_PoE1.4
/switch/TXRX1A+: J5.8 (TRD1+), U2.62 (TXRX1P_A)
/switch/TXRX1A-: J5.9 (TRD1-), U2.63 (TXRX1M_A)
/switch/TXRX1B+: J5.2 (TRD2+), U2.1 (TXRX1P_B)
/switch/TXRX1B-: J5.3 (TRD2-), U2.2 (TXRX1M_B)
/switch/TXRX1C+: J5.4 (TRD3+), U2.3 (TXRX1P_C)
/switch/TXRX1C-: J5.5 (TRD3-), U2.4 (TXRX1M_C)
/switch/TXRX1D+: J5.10 (TRD4+), U2.6 (TXRX1P_D)
/switch/TXRX1D-: J5.11 (TRD4-), U2.7 (TXRX1M_D)
/switch/TXRX2A+: C22.1, U2.9 (TXRX2P_A)
/switch/TXRX2A-: C23.1, U2.10 (TXRX2M_A)
/switch/TXRX2B+: C24.1, U2.12 (TXRX2P_B)
/switch/TXRX2B-: C25.1, U2.13 (TXRX2M_B)
/switch/YEL+: J5.18 (YEL+), R23.2
/switch/YEL-: IC1.6 (1Y), J5.17 (YEL-)
/~RST: D2.2, RST1.3 (COM_1), RST1.4 (COM_2), U1.9 (~RST), U2.46 (~RESET)
GND: C1.2, C2.2, C3.2, C4.2, C5.2, C6.2, C7.2, C8.2, C9.2, C10.2, C11.2, C12.2, C13.2, C14.2, C15.2, C16.2, C17.2, C18.2, C19.2, C20.2, C21.2, C28.2, C29.2, C30.2, C31.2, C32.2, C33.2, C34.2, C35.2, C36.2, C37.2, D2.1, DBG_UART1.4, DEV_UART1.4, IC1.2 (GND), IC2.C1 (GND), IC3.2 (GND), IC3.5 (GND), J2.P8 (GND), J2.S1 (SHIELD), J2.S2 (SHIELD__1), J3.6, J4.2, J5.SH, R6.1, R7.2, R8.2, R9.2, R22.2, RST1.1 (NO_1), RST1.2 (NO_2), U1.1 (GND), U1.6 (GND), U1.10 (GND), U1.15 (GND), U2.59 (GND), U2.65 (GND), U3.4 (GND), Y1.2 (GND)
unnamed: C32.1, FB4.1, J2.P4 (TXCT), J2.P5 (RXCT)
unnamed: C36.1, J5.7 (TRCT1)
unnamed: C35.1, J5.1 (TRCT2)
unnamed: C34.1, J5.6 (TRCT3)
unnamed: C33.1, J5.12 (TRCT4)
unnamed: R22.1, U2.60 (ISET)
unnamed: U2.58 (XI), Y1.3 (OUT)
