TCI-LUH/Gateway-Module-v3/pcbs/tty2eth-nano/tty2eth-nano.kicad_pcb

## KiCad design pcbs/tty2eth-nano/tty2eth-nano.kicad_pcb (2025-05-20)

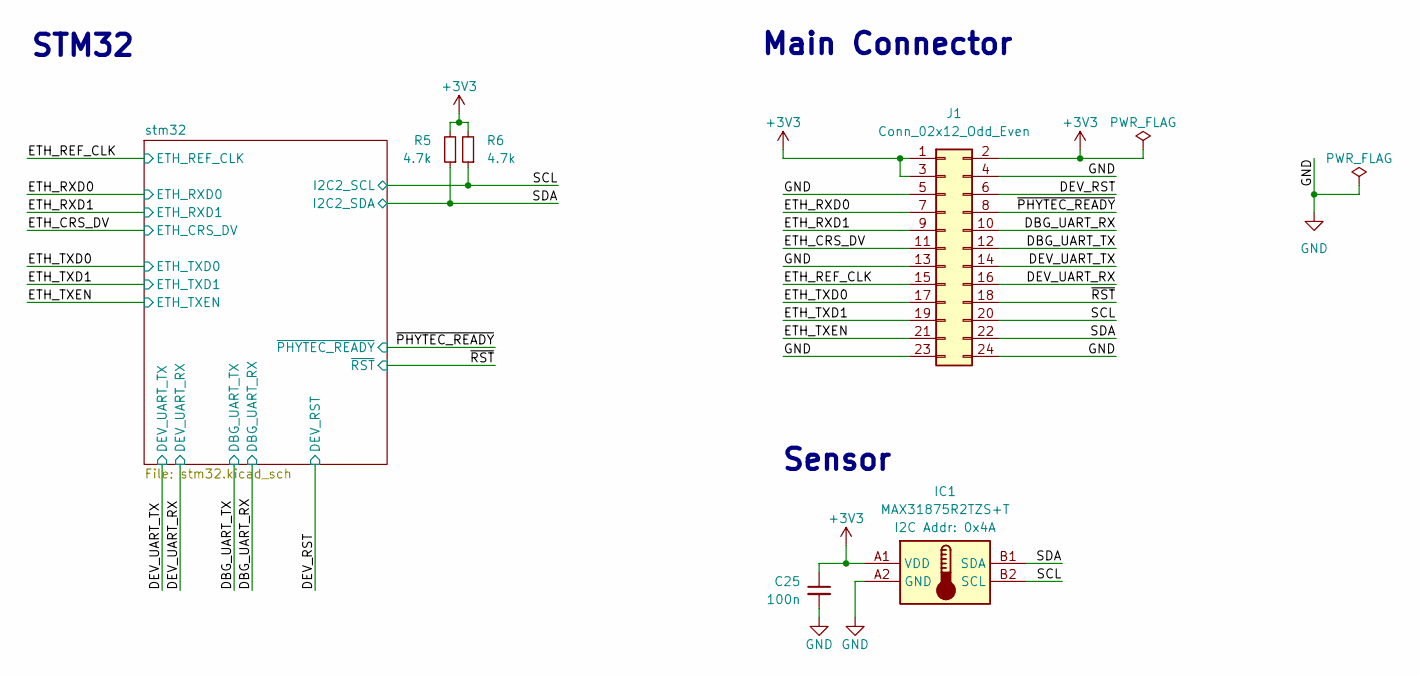
[picture p48: schematic tty2eth-nano.kicad_sch]

Parts:
C25: 100n; C_0402; Mouser Part Number 80-C0402C104K4R7867
IC1: MAX31875R2TZS+T; BGA4C40P2X2_84X84X37; Manufacturer_Part_Number MAX31875R2TZS+T; Mouser Part Number 700-MAX31875R2TZS+T
J1: Conn_02x12_Odd_Even; PinHeader_2x12_P1.27mm_Horizontal; Mouser Part Number 200-FTSH11204FDRA
R5, R6: 4.7k; R_0402; Mouser Part Number 652-CR0402FX-47R0GLF

Connections:
+3V3: C25.1, IC1.A1 (VDD), J1.1, J1.2, J1.3, R5.2, R6.2; also elsewhere on the board
/DBG_UART_RX: J1.10; also elsewhere on the board
/DBG_UART_TX: J1.12; also elsewhere on the board
/DEV_RST: J1.6; also elsewhere on the board
/DEV_UART_RX: J1.16; also elsewhere on the board
/DEV_UART_TX: J1.14; also elsewhere on the board
/ETH_CRS_DV: J1.11; also elsewhere on the board
/ETH_REF_CLK: J1.15; also elsewhere on the board
/ETH_RXD0: J1.7; also elsewhere on the board
/ETH_RXD1: J1.9; also elsewhere on the board
/ETH_TXD0: J1.17; also elsewhere on the board
/ETH_TXD1: J1.19; also elsewhere on the board
/ETH_TXEN: J1.21; also elsewhere on the board
/SCL: IC1.B2 (SCL), J1.20, R6.1; also elsewhere on the board
/SDA: IC1.B1 (SDA), J1.22, R5.1; also elsewhere on the board
/~PHYTEC_READY: J1.8; also elsewhere on the board
/~RST: J1.18; also elsewhere on the board
GND: C25.2, IC1.A2 (GND), J1.4, J1.5, J1.13, J1.23, J1.24; also elsewhere on the board

Notes on the sheet:
STM32
Sensor
Main Connector
