TCI-LUH/Gateway-Module-v3/pcbs/tty2eth-nano/tty2eth-nano.kicad_pcb

## KiCad design pcbs/tty2eth-nano/tty2eth-nano.kicad_pcb (continued)

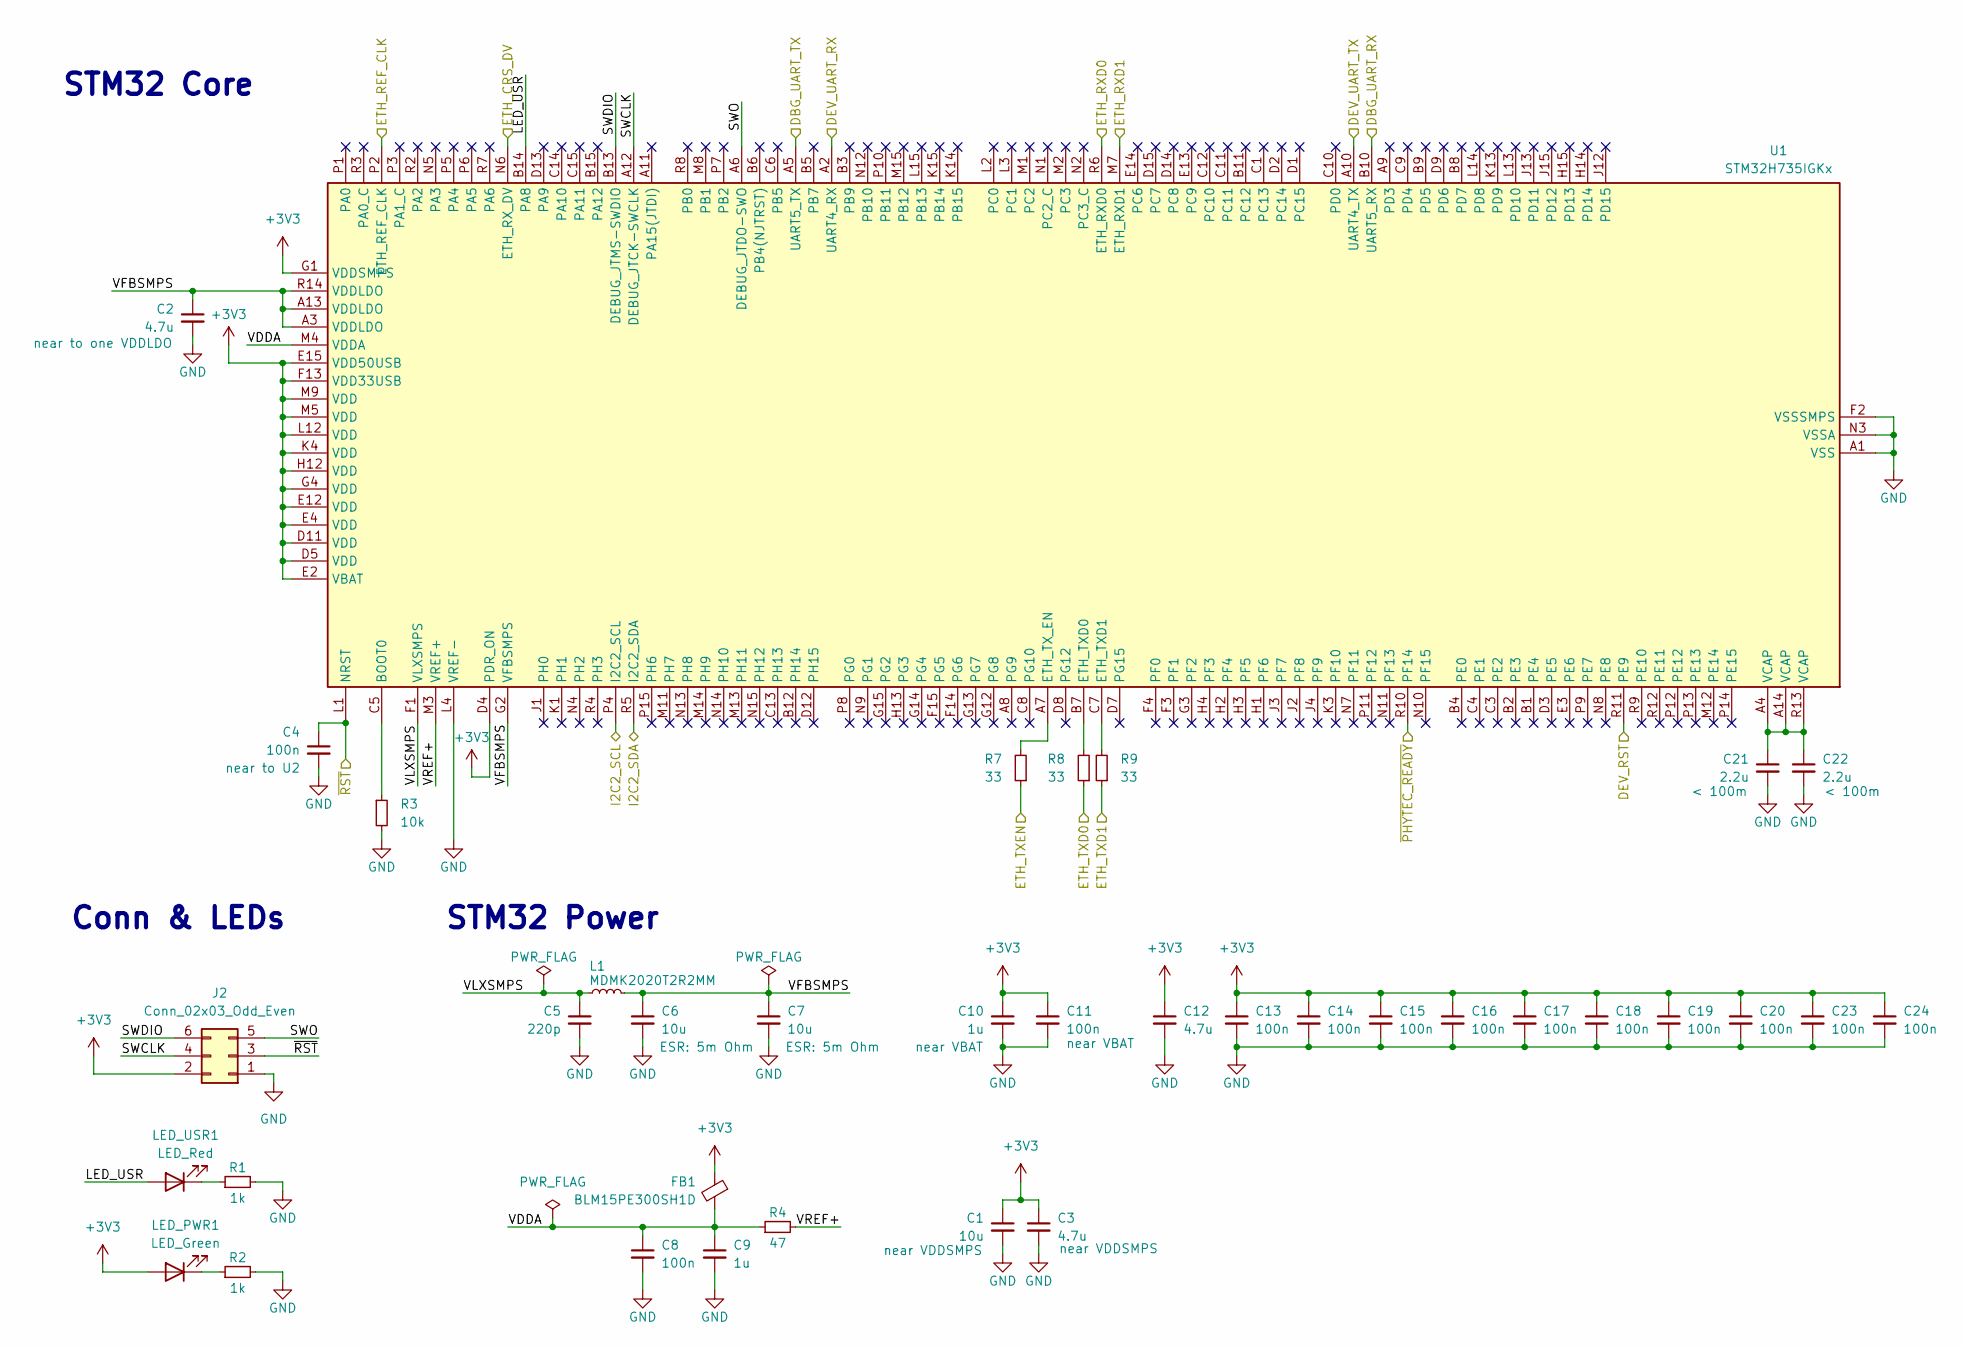
[picture p49: schematic stm32.kicad_sch, tty2eth-nano: stm32]

Parts:
C1, C6, C7: 10u; C_0402; Mouser Part Number 187-CL05A106MP6NUN8
C2, C3, C12: 4.7u; C_0402; Mouser Part Number 187-CL05A475MP5NRNC
C4, C8, C11, C13, C14, C15, C16, C17, C18, C19, C20, C23, C24: 100n; C_0402; Mouser Part Number 80-C0402C104K4R7867
C5: 220p; C_0402; Mouser Part Number 187-CL05C221JB5NNNC
C9, C10: 1u; C_0402; Mouser Part Number 187-CL05A105KO5NNNC
C21, C22: 2.2u; C_0402; Mouser Part Number 963-MSASL105SB5225KF
FB1: BLM15PE300SH1D; L_0402; Mouser Part Number 81-BLM15PE300SH1D
J2: Conn_02x03_Odd_Even; SAMTEC_CLT-103-01-F-D; Mouser Part Number 710-62000621121
L1: MDMK2020T2R2MM; L_Taiyo-Yuden_NR-20xx; Mouser Part Number 963-MDMK2020T2R2MM
LED_PWR1: LED_Green; LED_0402_1005Metric_Pad0.77x0.64mm_HandSolder; Mouser Part Number 755-SML-P11MTT86R
LED_USR1: LED_Red; LED_0402_1005Metric_Pad0.77x0.64mm_HandSolder; Mouser Part Number 755-SML-P11UTT86R
R1, R2: 1k; R_0402; Mouser Part Number 652-CR0402AFX1001GLF
R3: 10k; R_0402; Mouser Part Number 652-CR0402AFX1002GAS
R4: 47; R_0402; Mouser Part Number 652-CR0402FX-47R0GLF
R7, R8, R9: 33; R_0402; Mouser Part Number 652-CR0402FX-47R0GLF
U1: STM32H735IGKx; UFBGA-201_10x10mm_Layout15x15_P0.65mm; Mouser Part Number 511-STM32H735IGK6

Connections:
+3V3: C1.1, C3.1, C10.1, C11.1, C12.1, C13.1, C14.1, C15.1, C16.1, C17.1, C18.1, C19.1, C20.1, C23.1, C24.1, FB1.1, J2.2, LED_PWR1.2 (A), U1.D4 (PDR_ON), U1.D5 (VDD), U1.D11 (VDD), U1.E2 (VBAT), U1.E4 (VDD), U1.E12 (VDD), U1.E15 (VDD50USB), U1.F13 (VDD33USB), U1.G1 (VDDSMPS), U1.G4 (VDD), U1.H12 (VDD), U1.K4 (VDD), U1.L12 (VDD), U1.M5 (VDD), U1.M9 (VDD); also elsewhere on the board
/DBG_UART_RX: U1.B10 (UART5_RX); also elsewhere on the board
/DBG_UART_TX: U1.A5 (UART5_TX); also elsewhere on the board
/DEV_RST: U1.R11 (PE9); also elsewhere on the board
/DEV_UART_RX: U1.A2 (UART4_RX); also elsewhere on the board
/DEV_UART_TX: U1.A10 (UART4_TX); also elsewhere on the board
/ETH_CRS_DV: U1.N6 (ETH_RX_DV); also elsewhere on the board
/ETH_REF_CLK: U1.P2 (ETH_REF_CLK); also elsewhere on the board
/ETH_RXD0: U1.R6 (ETH_RXD0); also elsewhere on the board
/ETH_RXD1: U1.M7 (ETH_RXD1); also elsewhere on the board
/ETH_TXD0: R8.1; also elsewhere on the board
/ETH_TXD1: R9.1; also elsewhere on the board
/ETH_TXEN: R7.1; also elsewhere on the board
/SCL: U1.P4 (I2C2_SCL); also elsewhere on the board
/SDA: U1.R5 (I2C2_SDA); also elsewhere on the board
/stm32/LED_USR: LED_USR1.2 (A), U1.B14 (PA8)
/stm32/SWCLK: J2.4, U1.A12 (DEBUG_JTCK-SWCLK)
/stm32/SWDIO: J2.6, U1.B13 (DEBUG_JTMS-SWDIO)
/stm32/SWO: J2.5, U1.A6 (DEBUG_JTDO-SWO)
/stm32/VDDA: C8.1, C9.1, FB1.2, R4.1, U1.M4 (VDDA)
/stm32/VFBSMPS: C2.1, C6.1, C7.1, L1.1, U1.A3 (VDDLDO), U1.A13 (VDDLDO), U1.G2 (VFBSMPS), U1.R14 (VDDLDO)
/stm32/VLXSMPS: C5.1, L1.2, U1.F1 (VLXSMPS)
/stm32/VREF+: R4.2, U1.M3 (VREF+)
/~PHYTEC_READY: U1.R10 (PF14); also elsewhere on the board
/~RST: C4.1, J2.3, U1.L1 (NRST); also elsewhere on the board
GND: C1.2, C2.2, C3.2, C4.2, C5.2, C6.2, C7.2, C8.2, C9.2, C10.2, C11.2, C12.2, C13.2, C14.2, C15.2, C16.2, C17.2, C18.2, C19.2, C20.2, C21.2, C22.2, C23.2, C24.2, J2.1, R1.2, R2.2, R3.2, U1.A1 (VSS), U1.A15 (VSS), U1.C2 (VSS), U1.D6 (VSS), U1.D10 (VSS), U1.E1 (VSS), U1.F2 (VSSSMPS), U1.F6 (VSS), U1.F7 (VSS), U1.F8 (VSS), U1.F9 (VSS), U1.F10 (VSS), U1.F12 (VSS), U1.G6 (VSS), U1.G7 (VSS), U1.G8 (VSS), U1.G9 (VSS), U1.G10 (VSS), U1.H6 (VSS), U1.H7 (VSS), U1.H8 (VSS), U1.H9 (VSS), U1.H10 (VSS), U1.J6 (VSS), U1.J7 (VSS), U1.J8 (VSS), U1.J9 (VSS), U1.J10 (VSS), U1.J14 (VSS), U1.K2 (VSS), U1.K6 (VSS), U1.K7 (VSS), U1.K8 (VSS), U1.K9 (VSS), U1.K10 (VSS), U1.K12 (VSS), U1.L4 (VREF-), U1.M6 (VSS), U1.M10 (VSS), U1.N3 (VSSA), U1.R1 (VSS), U1.R15 (VSS); also elsewhere on the board
unnamed: C21.1, C22.1, U1.A4 (VCAP), U1.A14 (VCAP), U1.R13 (VCAP)
unnamed: LED_PWR1.1 (K), R2.1
unnamed: LED_USR1.1 (K), R1.1
unnamed: R3.1, U1.C5 (BOOT0)
unnamed: R7.2, U1.A7 (ETH_TX_EN)
unnamed: R8.2, U1.B7 (ETH_TXD0)
unnamed: R9.2, U1.C7 (ETH_TXD1)

Notes on the sheet:
STM32 Power
STM32 Core
Conn & LEDs

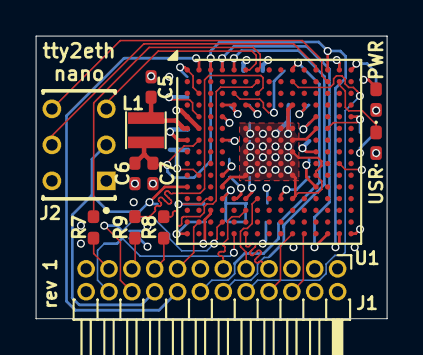
[picture p50: board tty2eth-nano.kicad_pcb from above]

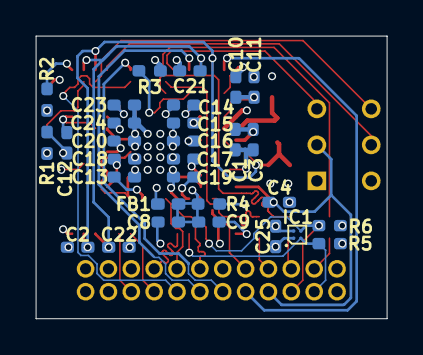
[picture p51: board tty2eth-nano.kicad_pcb from below]

Board: 4 copper layers, 19.5 x 15.7 mm, 42 parts (30 on the bottom side), 33 nets.
