TCI-LUH/Gateway-Module-v3/pcbs/testing/tty2eth-slim/tty2eth-slim.kicad_pcb

## KiCad design pcbs/testing/tty2eth-slim/tty2eth-slim.kicad_pcb (2025-05-20)

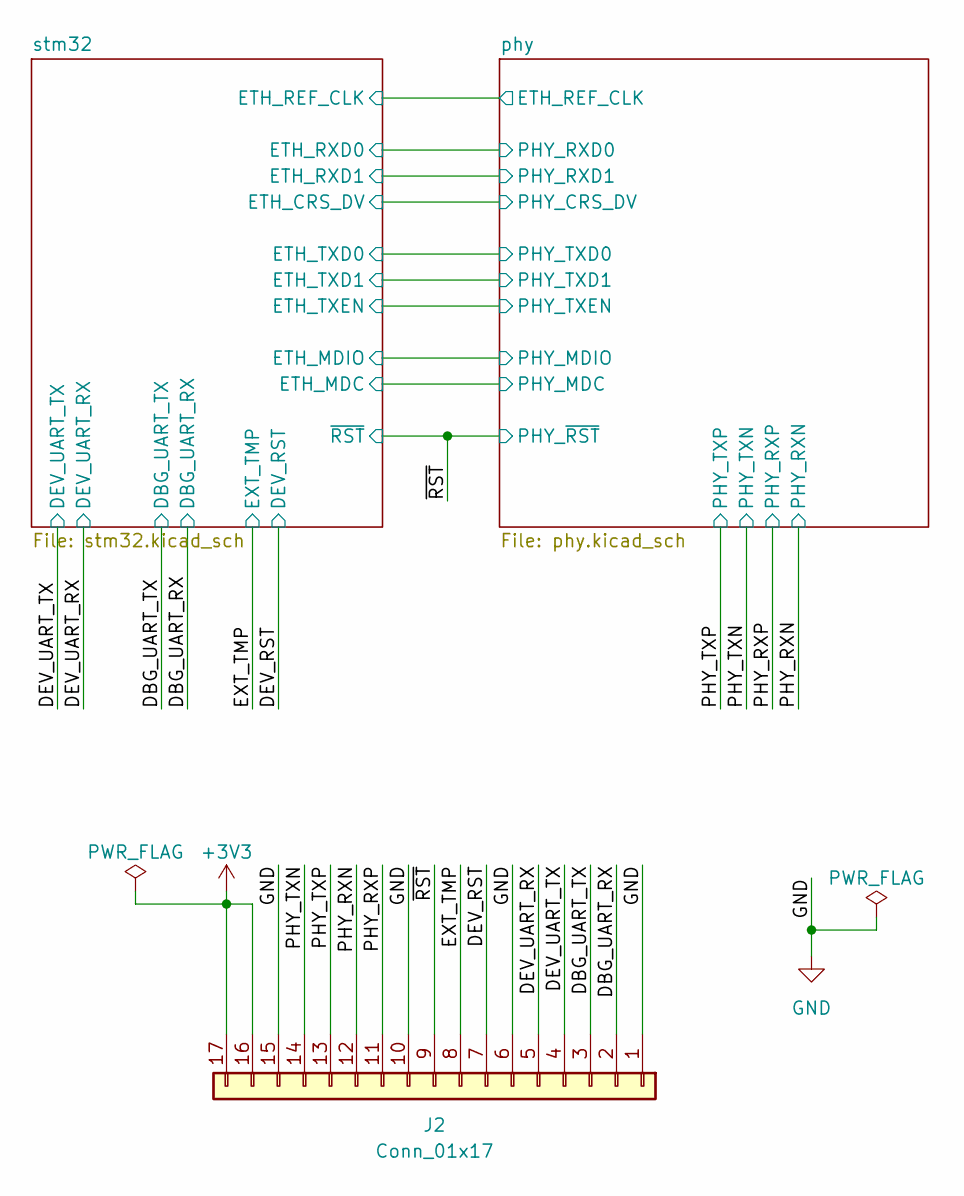
[picture p52: schematic tty2eth-slim.kicad_sch]

Parts:
J2: Conn_01x17; PinHeader_1x17_P1.27mm_Horizontal; Mouser Part Number 855-M50-3932042

Connections:
+3V3: J2.16, J2.17; also elsewhere on the board
/DBG_UART_RX: J2.2; also elsewhere on the board
/DBG_UART_TX: J2.3; also elsewhere on the board
/DEV_RST: J2.7; also elsewhere on the board
/DEV_UART_RX: J2.5; also elsewhere on the board
/DEV_UART_TX: J2.4; also elsewhere on the board
/EXT_TMP: J2.8; also elsewhere on the board
/PHY_RXN: J2.12; also elsewhere on the board
/PHY_RXP: J2.11; also elsewhere on the board
/PHY_TXN: J2.14; also elsewhere on the board
/PHY_TXP: J2.13; also elsewhere on the board
/~RST: J2.9; also elsewhere on the board
GND: J2.1, J2.6, J2.10, J2.15; also elsewhere on the board

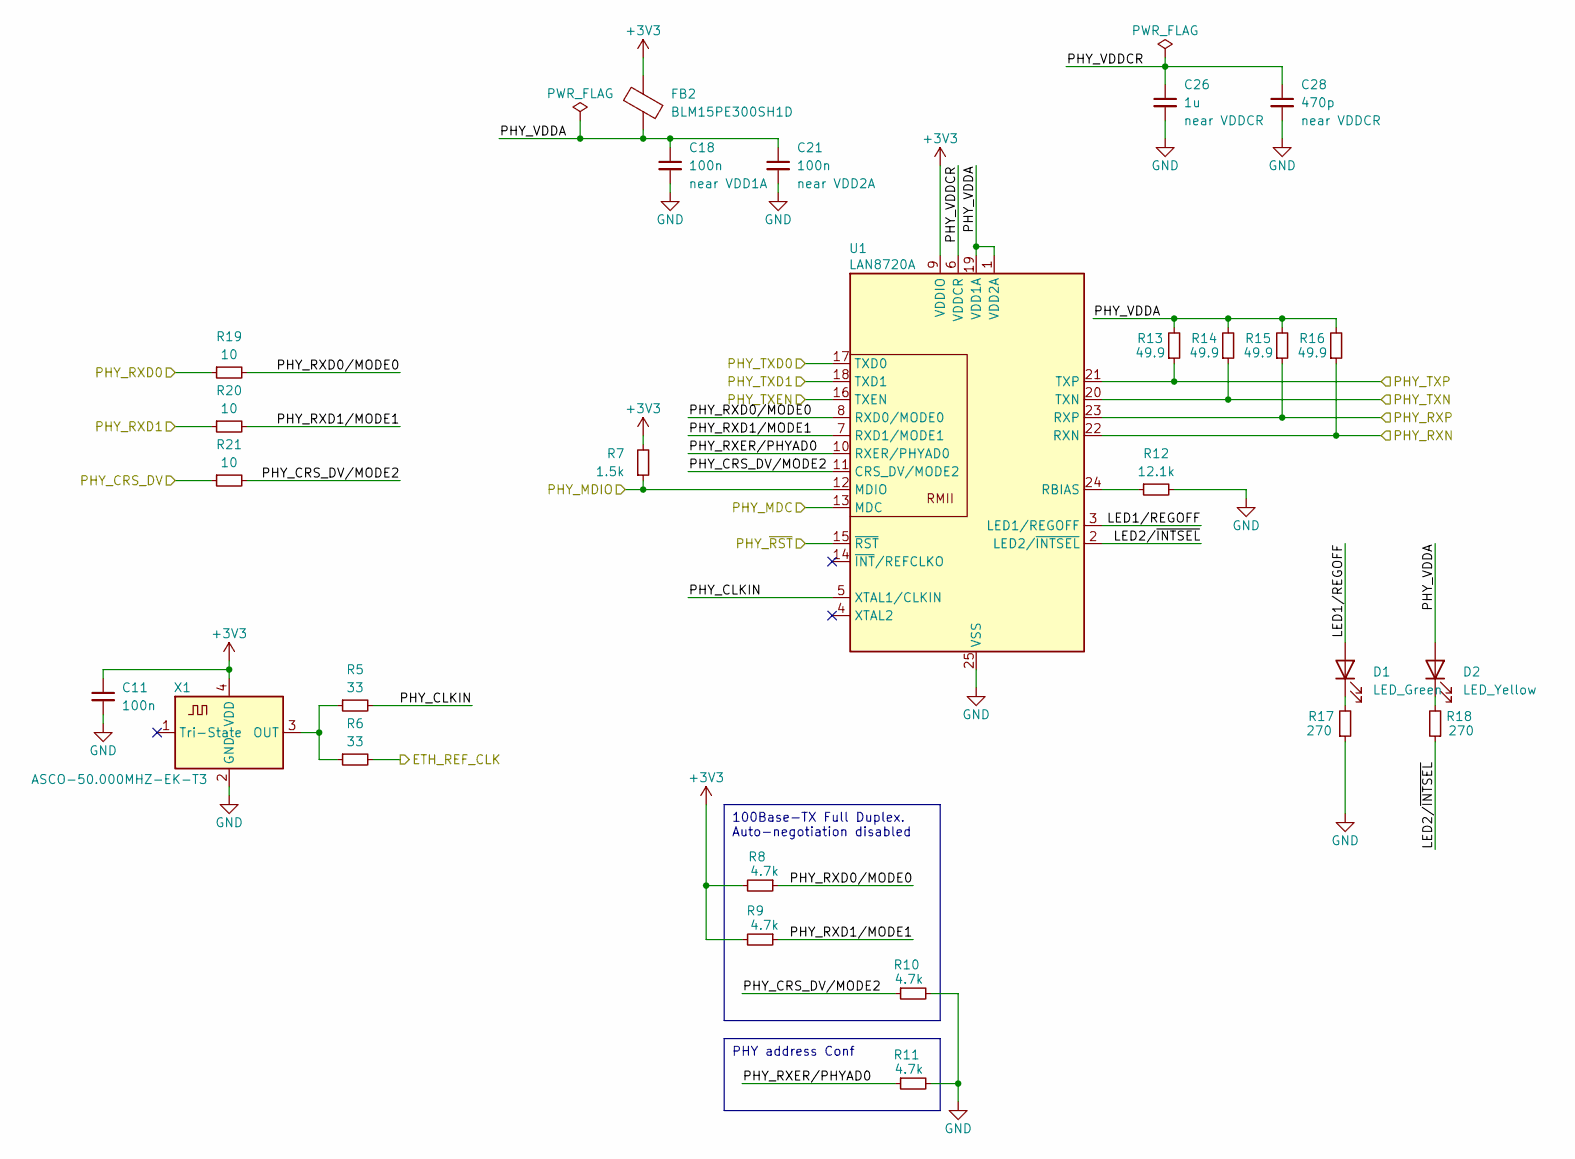
[picture p53: schematic phy.kicad_sch]

Parts:
C11, C18, C21: 100n; C_0402_1005Metric_Pad0.74x0.62mm_HandSolder; Mouser Part Number 187-80-C0402C104K4R7867
C26: 1u; C_0402_1005Metric_Pad0.74x0.62mm_HandSolder; Mouser Part Number 187-CL05A105KO5NNNC
C28: 470p; C_0402_1005Metric_Pad0.74x0.62mm_HandSolder; Mouser Part Number 187-CL05C471JB5NNWC
D1: LED_Green; LED_0402_1005Metric_Pad0.77x0.64mm_HandSolder; Mouser Part Number 755-SML-P11MTT86R
D2: LED_Yellow; LED_0402_1005Metric_Pad0.77x0.64mm_HandSolder; Mouser Part Number 755-SML-P11YTT86R
FB2: BLM15PE300SH1D; L_0402_1005Metric_Pad0.77x0.64mm_HandSolder; Mouser Part Number 81-BLM15PE300SH1D
R5, R6: 33; R_0402_1005Metric_Pad0.72x0.64mm_HandSolder; Mouser Part Number 652-CR0402FX-33R0GLF
R7: 1.5k; R_0402_1005Metric_Pad0.72x0.64mm_HandSolder; Mouser Part Number 652-CR0402FX-1501GLF
R8, R9, R10, R11: 4.7k; R_0402_1005Metric_Pad0.72x0.64mm_HandSolder; Mouser Part Number 652-CR0402FX-4701GLF
R12: 12.1k; R_0402_1005Metric_Pad0.72x0.64mm_HandSolder; Mouser Part Number 652-CR0402-FX1212GLF
R13, R14, R15, R16: 49.9; R_0402_1005Metric_Pad0.72x0.64mm_HandSolder; Mouser Part Number 652-CR0402FX-49R9GLF
R17, R18: 270; R_0402_1005Metric_Pad0.72x0.64mm_HandSolder; Mouser Part Number 652-CR0402FX-2700GLF
R19, R20, R21: 10; R_0402_1005Metric_Pad0.72x0.64mm_HandSolder; Mouser Part Number 652-CR0402FX-10R0GLF
U1: LAN8720A; VQFN-24-1EP_4x4mm_P0.5mm_EP2.5x2.5mm_ThermalVias; Mouser Part Number 579-LAN8720ACPTRABC
X1: ASCO-50.000MHZ-EK-T3; Oscillator_SMD_Abracon_ASCO-4Pin_1.6x1.2mm; Mouser Part Number 815-ASCO-50-EK-T3

Connections:
+3V3: C11.1, FB2.2, R7.2, R8.2, R9.2, U1.9 (VDDIO), X1.4 (VDD); also elsewhere on the board
/PHY_RXN: R16.1, U1.22 (RXN); also elsewhere on the board
/PHY_RXP: R15.1, U1.23 (RXP); also elsewhere on the board
/PHY_TXN: R14.1, U1.20 (TXN); also elsewhere on the board
/PHY_TXP: R13.1, U1.21 (TXP); also elsewhere on the board
/phy/ETH_REF_CLK: R6.2; also elsewhere on the board
/phy/LED1/REGOFF: D1.2 (A), U1.3 (LED1/REGOFF)
/phy/LED2/~INTSEL: R18.1, U1.2 (LED2/~INTSEL)
/phy/PHY_CLKIN: R5.2, U1.5 (XTAL1/CLKIN)
/phy/PHY_CRS_DV: R21.1; also elsewhere on the board
/phy/PHY_CRS_DV/MODE2: R10.1, R21.2, U1.11 (CRS_DV/MODE2)
/phy/PHY_MDC: U1.13 (MDC); also elsewhere on the board
/phy/PHY_MDIO: R7.1, U1.12 (MDIO); also elsewhere on the board
/phy/PHY_RXD0: R19.1; also elsewhere on the board
/phy/PHY_RXD0/MODE0: R8.1, R19.2, U1.8 (RXD0/MODE0)
/phy/PHY_RXD1: R20.1; also elsewhere on the board
/phy/PHY_RXD1/MODE1: R9.1, R20.2, U1.7 (RXD1/MODE1)
/phy/PHY_RXER/PHYAD0: R11.1, U1.10 (RXER/PHYAD0)
/phy/PHY_TXD0: U1.17 (TXD0); also elsewhere on the board
/phy/PHY_TXD1: U1.18 (TXD1); also elsewhere on the board
/phy/PHY_TXEN: U1.16 (TXEN); also elsewhere on the board
/phy/PHY_VDDA: C18.1, C21.1, D2.2 (A), FB2.1, R13.2, R14.2, R15.2, R16.2, U1.1 (VDD2A), U1.19 (VDD1A)
/phy/PHY_VDDCR: C26.1, C28.1, U1.6 (VDDCR)
/~RST: U1.15 (~RST); also elsewhere on the board
GND: C11.2, C18.2, C21.2, C26.2, C28.2, R10.2, R11.2, R12.2, R17.1, U1.25 (VSS), X1.2 (GND); also elsewhere on the board
unnamed: D1.1 (K), R17.2
unnamed: D2.1 (K), R18.2
unnamed: R12.1, U1.24 (RBIAS)
unnamed: R5.1, R6.1, X1.3 (OUT)

Notes on the sheet:
PHY address Conf
100Base-TX Full Duplex. Auto-negotiation disabled

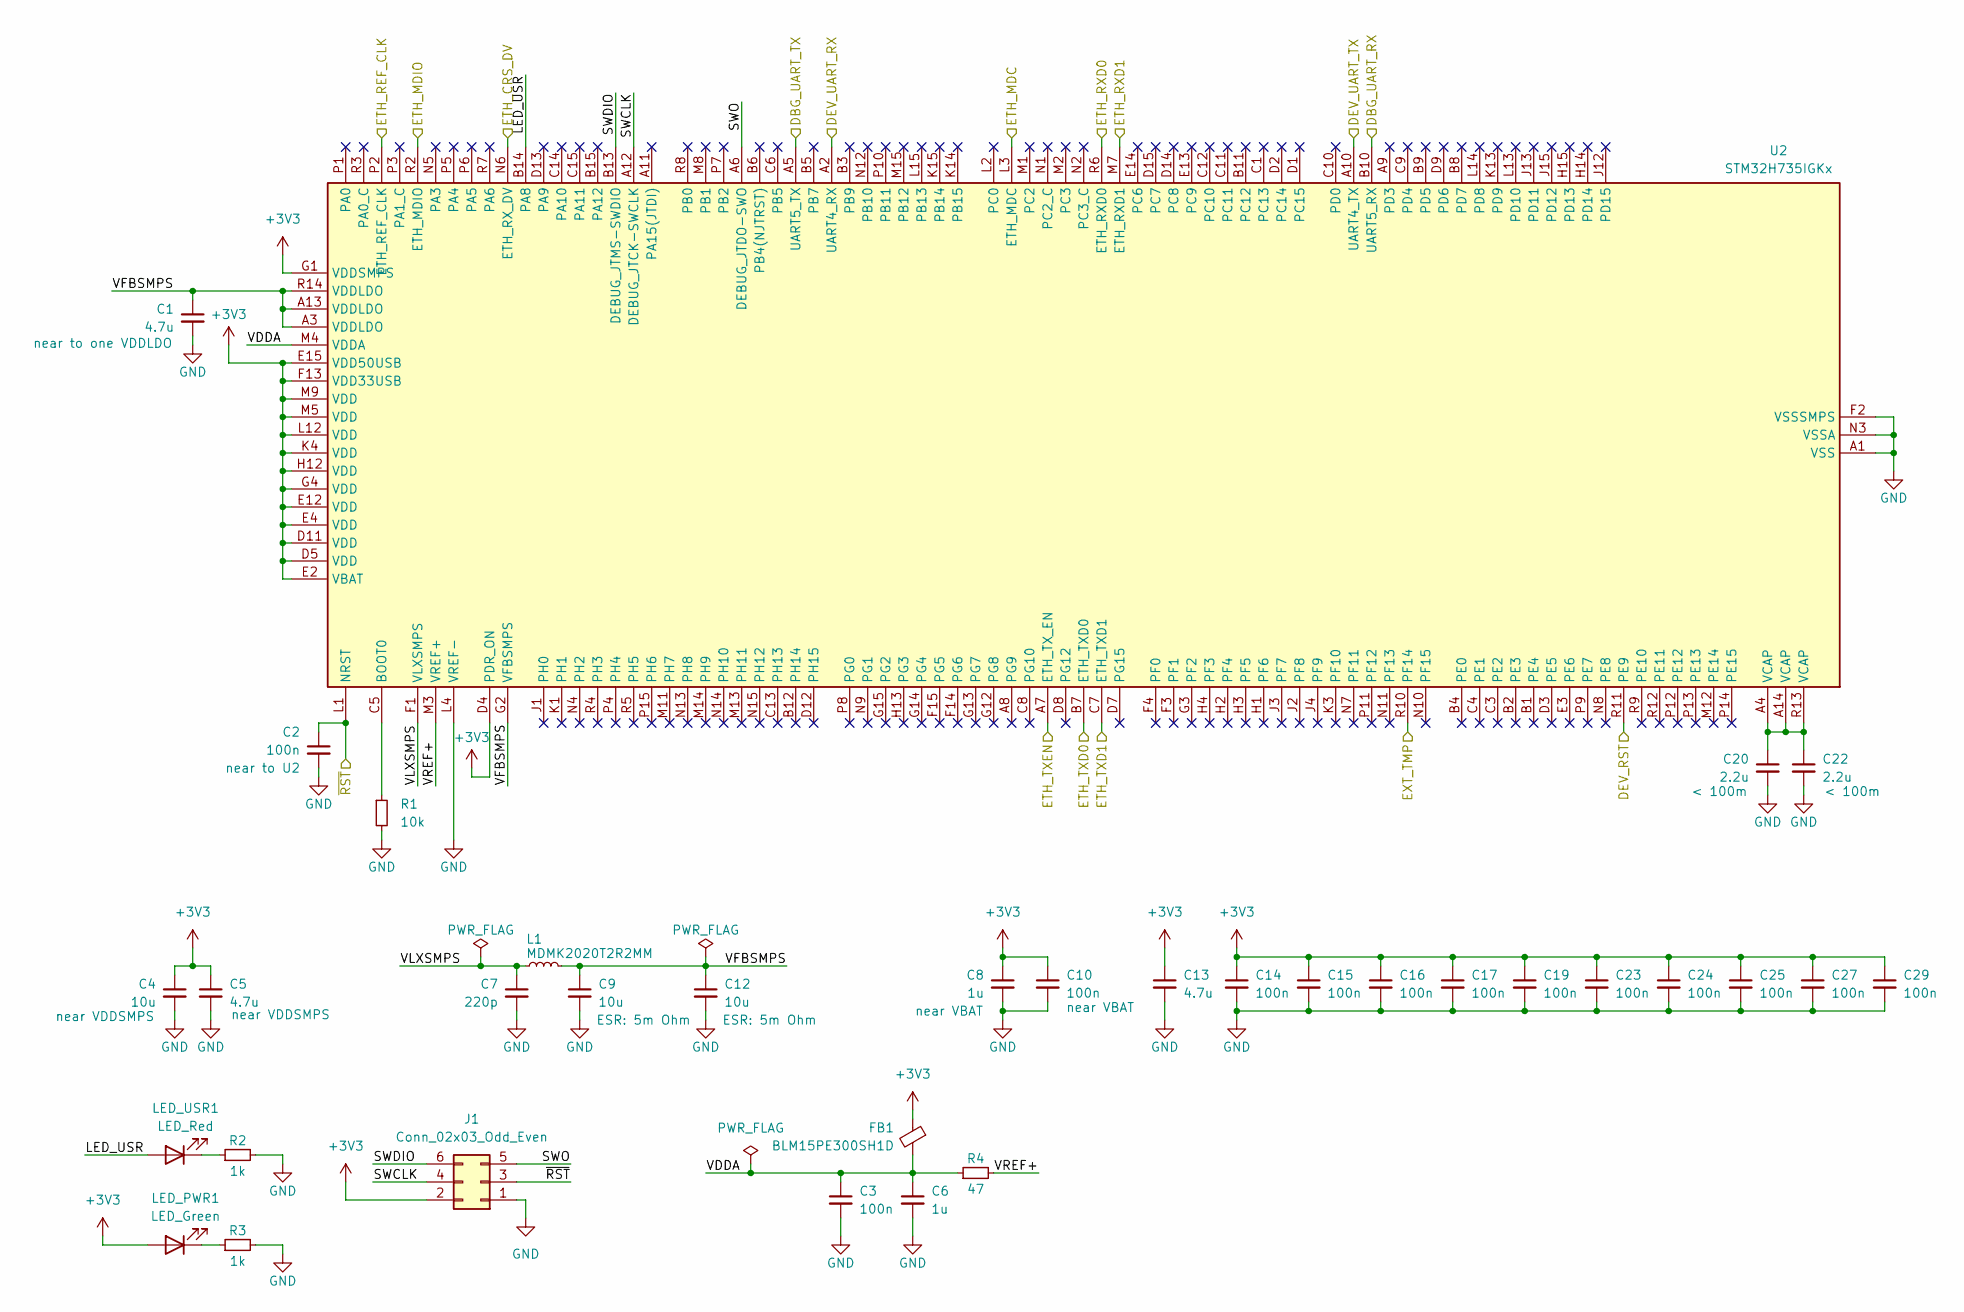
[picture p54: schematic stm32.kicad_sch]

Parts:
C1, C5, C13: 4.7u; C_0402_1005Metric_Pad0.74x0.62mm_HandSolder; Mouser Part Number 187-CL05A475MP5NRNC
C2, C3, C10, C14, C15, C16, C17, C19, C23, C24, C25, C27, C29: 100n; C_0402_1005Metric_Pad0.74x0.62mm_HandSolder; Mouser Part Number 187-80-C0402C104K4R7867
C4, C9, C12: 10u; C_0402_1005Metric_Pad0.74x0.62mm_HandSolder; Mouser Part Number 187-CL05A106MP6NUN8
C6, C8: 1u; C_0402_1005Metric_Pad0.74x0.62mm_HandSolder; Mouser Part Number 187-CL05A105KO5NNNC
C7: 220p; C_0402_1005Metric_Pad0.74x0.62mm_HandSolder; Mouser Part Number 187-CL05C221JB5NNNC
C20, C22: 2.2u; C_0402_1005Metric_Pad0.74x0.62mm_HandSolder; Mouser Part Number 963-MSASL105SB5225KF
FB1: BLM15PE300SH1D; L_0402_1005Metric_Pad0.77x0.64mm_HandSolder; Mouser Part Number 81-BLM15PE300SH1D
J1: Conn_02x03_Odd_Even; SAMTEC_CLT-103-01-F-D; Mouser Part Number 710-62000621121
L1: MDMK2020T2R2MM; L_Taiyo-Yuden_NR-20xx; Mouser Part Number 963-MDMK2020T2R2MM
LED_PWR1: LED_Green; LED_0402_1005Metric_Pad0.77x0.64mm_HandSolder; Mouser Part Number 755-SML-P11MTT86R
LED_USR1: LED_Red; LED_0402_1005Metric_Pad0.77x0.64mm_HandSolder; Mouser Part Number 755-SML-P11UTT86R
R1: 10k; R_0402_1005Metric_Pad0.72x0.64mm_HandSolder; Mouser Part Number 652-CR0402AFX1002GAS
R2, R3: 1k; R_0402_1005Metric_Pad0.72x0.64mm_HandSolder; Mouser Part Number 652-CR0402AFX1001GLF
R4: 47; R_0402_1005Metric_Pad0.72x0.64mm_HandSolder; Mouser Part Number 652-CR0402FX-47R0GLF
U2: STM32H735IGKx; UFBGA-201_10x10mm_Layout15x15_P0.65mm; Mouser Part Number 511-STM32H735IGK6

Connections:
+3V3: C4.1, C5.1, C8.1, C10.1, C13.1, C14.1, C15.1, C16.1, C17.1, C19.1, C23.1, C24.1, C25.1, C27.1, C29.1, FB1.1, J1.2, LED_PWR1.2 (A), U2.D4 (PDR_ON), U2.D5 (VDD), U2.D11 (VDD), U2.E2 (VBAT), U2.E4 (VDD), U2.E12 (VDD), U2.E15 (VDD50USB), U2.F13 (VDD33USB), U2.G1 (VDDSMPS), U2.G4 (VDD), U2.H12 (VDD), U2.K4 (VDD), U2.L12 (VDD), U2.M5 (VDD), U2.M9 (VDD); also elsewhere on the board
/DBG_UART_RX: U2.B10 (UART5_RX); also elsewhere on the board
/DBG_UART_TX: U2.A5 (UART5_TX); also elsewhere on the board
/DEV_RST: U2.R11 (PE9); also elsewhere on the board
/DEV_UART_RX: U2.A2 (UART4_RX); also elsewhere on the board
/DEV_UART_TX: U2.A10 (UART4_TX); also elsewhere on the board
/EXT_TMP: U2.R10 (PF14); also elsewhere on the board
/phy/ETH_REF_CLK: U2.P2 (ETH_REF_CLK); also elsewhere on the board
/phy/PHY_CRS_DV: U2.N6 (ETH_RX_DV); also elsewhere on the board
/phy/PHY_MDC: U2.L3 (PC1); also elsewhere on the board
/phy/PHY_MDIO: U2.R2 (ETH_MDIO); also elsewhere on the board
/phy/PHY_RXD0: U2.R6 (ETH_RXD0); also elsewhere on the board
/phy/PHY_RXD1: U2.M7 (ETH_RXD1); also elsewhere on the board
/phy/PHY_TXD0: U2.B7 (ETH_TXD0); also elsewhere on the board
/phy/PHY_TXD1: U2.C7 (ETH_TXD1); also elsewhere on the board
/phy/PHY_TXEN: U2.A7 (ETH_TX_EN); also elsewhere on the board
/stm32/LED_USR: LED_USR1.2 (A), U2.B14 (PA8)
/stm32/SWCLK: J1.4, U2.A12 (DEBUG_JTCK-SWCLK)
/stm32/SWDIO: J1.6, U2.B13 (DEBUG_JTMS-SWDIO)
/stm32/SWO: J1.5, U2.A6 (DEBUG_JTDO-SWO)
/stm32/VDDA: C3.1, C6.1, FB1.2, R4.1, U2.M4 (VDDA)
/stm32/VFBSMPS: C1.1, C9.1, C12.1, L1.1, U2.A3 (VDDLDO), U2.A13 (VDDLDO), U2.G2 (VFBSMPS), U2.R14 (VDDLDO)
/stm32/VLXSMPS: C7.1, L1.2, U2.F1 (VLXSMPS)
/stm32/VREF+: R4.2, U2.M3 (VREF+)
/~RST: C2.1, J1.3, U2.L1 (NRST); also elsewhere on the board
GND: C1.2, C2.2, C3.2, C4.2, C5.2, C6.2, C7.2, C8.2, C9.2, C10.2, C12.2, C13.2, C14.2, C15.2, C16.2, C17.2, C19.2, C20.2, C22.2, C23.2, C24.2, C25.2, C27.2, C29.2, J1.1, R1.2, R2.2, R3.2, U2.A1 (VSS), U2.A15 (VSS), U2.C2 (VSS), U2.D6 (VSS), U2.D10 (VSS), U2.E1 (VSS), U2.F2 (VSSSMPS), U2.F6 (VSS), U2.F7 (VSS), U2.F8 (VSS), U2.F9 (VSS), U2.F10 (VSS), U2.F12 (VSS), U2.G6 (VSS), U2.G7 (VSS), U2.G8 (VSS), U2.G9 (VSS), U2.G10 (VSS), U2.H6 (VSS), U2.H7 (VSS), U2.H8 (VSS), U2.H9 (VSS), U2.H10 (VSS), U2.J6 (VSS), U2.J7 (VSS), U2.J8 (VSS), U2.J9 (VSS), U2.J10 (VSS), U2.J14 (VSS), U2.K2 (VSS), U2.K6 (VSS), U2.K7 (VSS), U2.K8 (VSS), U2.K9 (VSS), U2.K10 (VSS), U2.K12 (VSS), U2.L4 (VREF-), U2.M6 (VSS), U2.M10 (VSS), U2.N3 (VSSA), U2.R1 (VSS), U2.R15 (VSS); also elsewhere on the board
unnamed: C20.1, C22.1, U2.A4 (VCAP), U2.A14 (VCAP), U2.R13 (VCAP)
unnamed: LED_PWR1.1 (K), R3.1
unnamed: LED_USR1.1 (K), R2.1
unnamed: R1.1, U2.C5 (BOOT0)

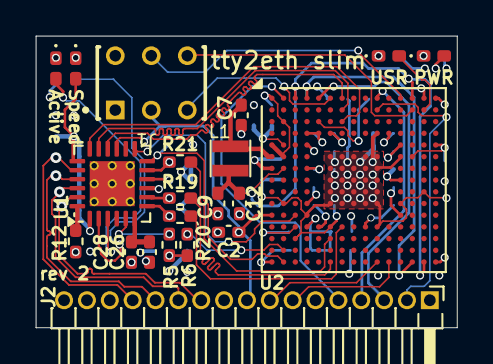
[picture p55: board tty2eth-slim.kicad_pcb from above]

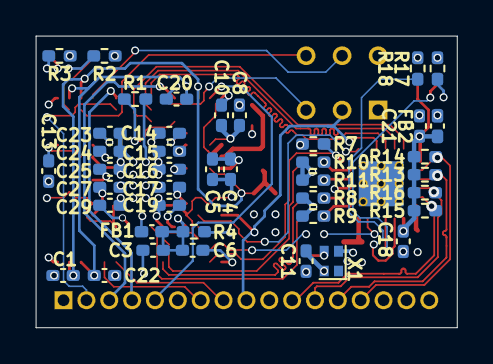
[picture p56: board tty2eth-slim.kicad_pcb from below]

Board: 4 copper layers, 23.4 x 16.2 mm, 62 parts (41 on the bottom side), 47 nets.
